lara-unb/Estimulema/Tesis Doc Miguel Gutierrez/figs/Fig_c5/c5_f1_ect.docx

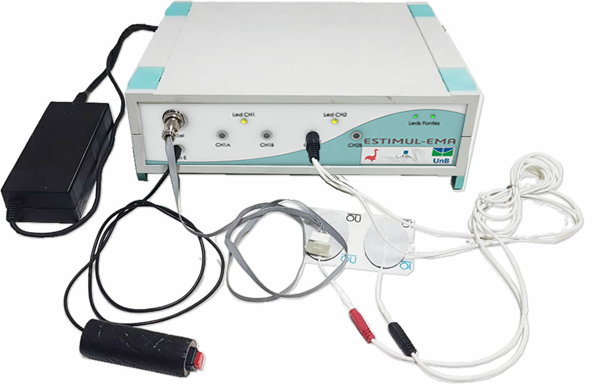
[picture p2: figure]

Acelerômetro

Eletrodo autoadesivo siliconado

Fonte

médica

Cabo do eletrodo

Botão de emergência
