lara-unb/Estimulema/Tesis Doc Miguel Gutierrez/figs/Fig_c5/c5_f4_css.docx

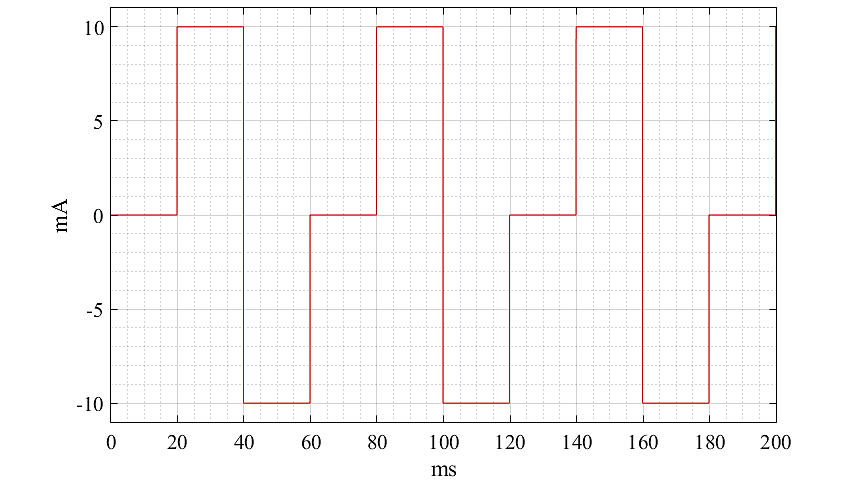
[picture p3: figure]
