lara-unb/Estimulema/Tesis Doc Miguel Gutierrez/figs/Fig_ap1/ap1_f1_v11.pdf

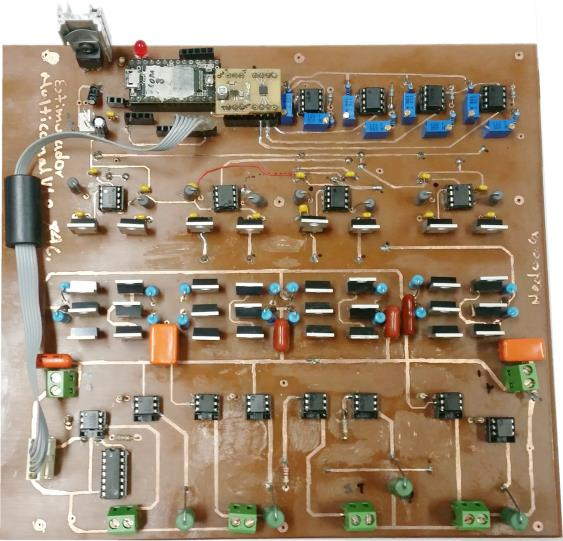
[picture p4: page 1]
