lara-unb/Estimulema/Tesis Doc Miguel Gutierrez/figs/Fig_c2/um_f3.pdf

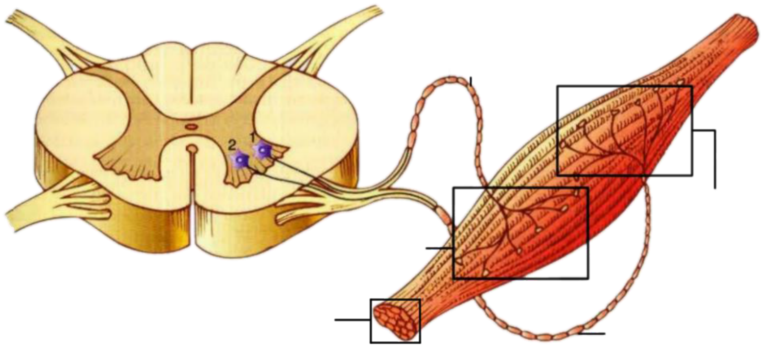
[picture p5: page 1]
