lara-unb/Estimulema/Tesis Doc Miguel Gutierrez/figs/Fig_c3/gem_f4.pdf

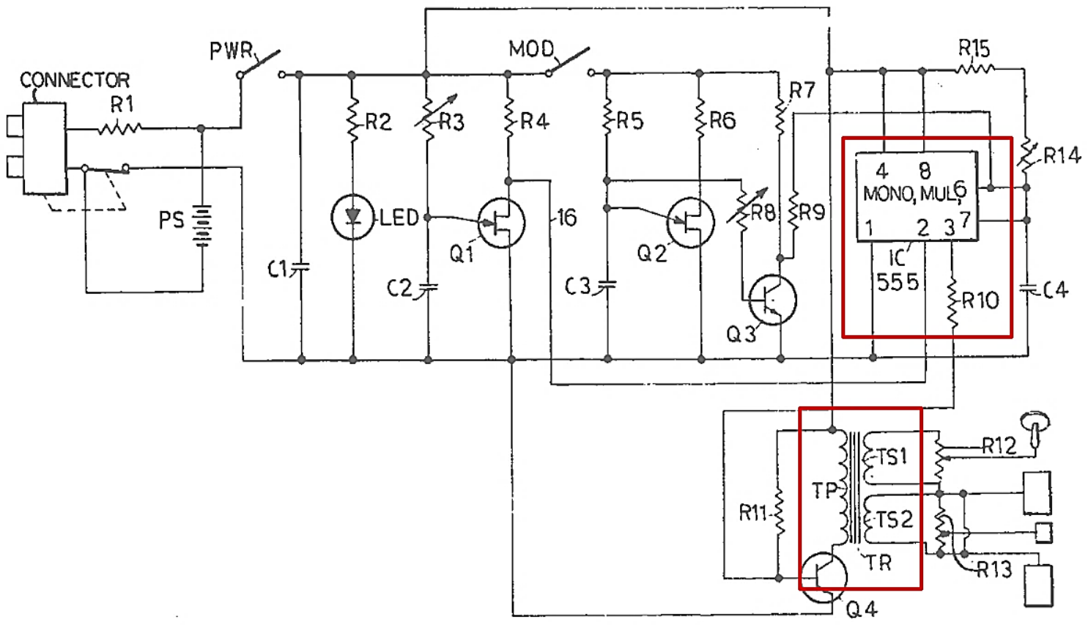
[picture p6: page 1]
