lara-unb/Estimulema/Tesis Doc Miguel Gutierrez/figs/Fig_c3/ges_f8.pdf

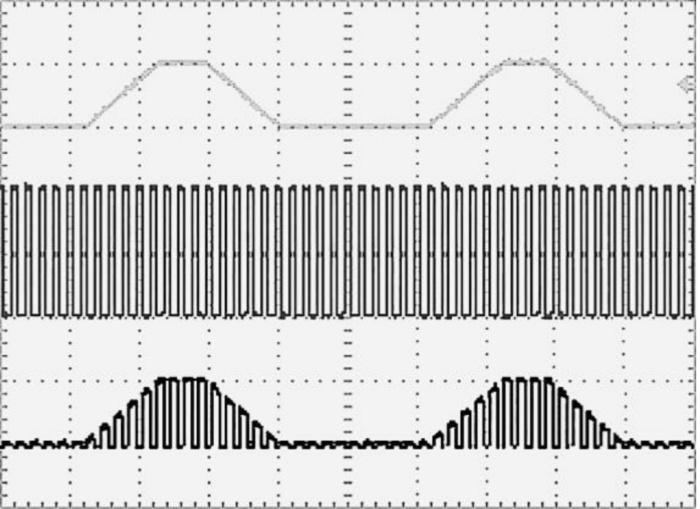
[picture p7: page 2]
