lara-unb/Estimulema/Tesis Doc Miguel Gutierrez/figs/Fig_c4/c4_f21_esb.pdf

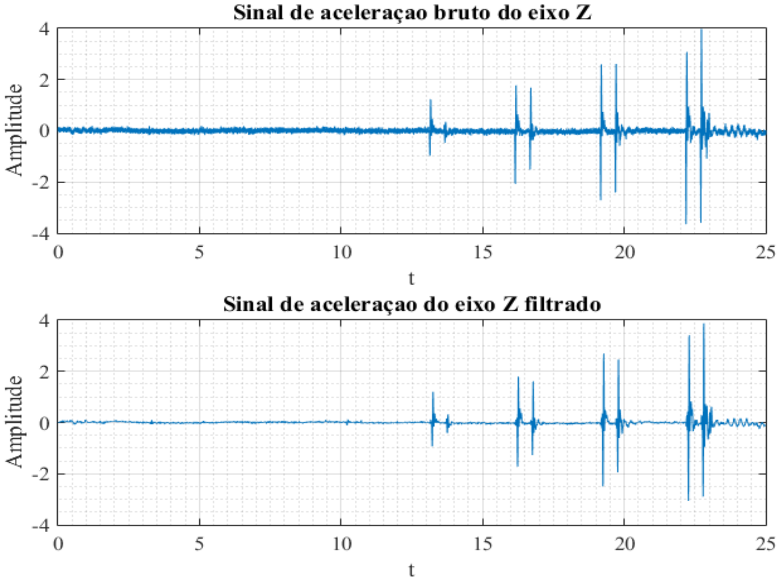
[picture p8: page 1]
