lara-unb/Estimulema/Tesis Doc Miguel Gutierrez/figs/Fig_c4/c4_f22_cca.pdf

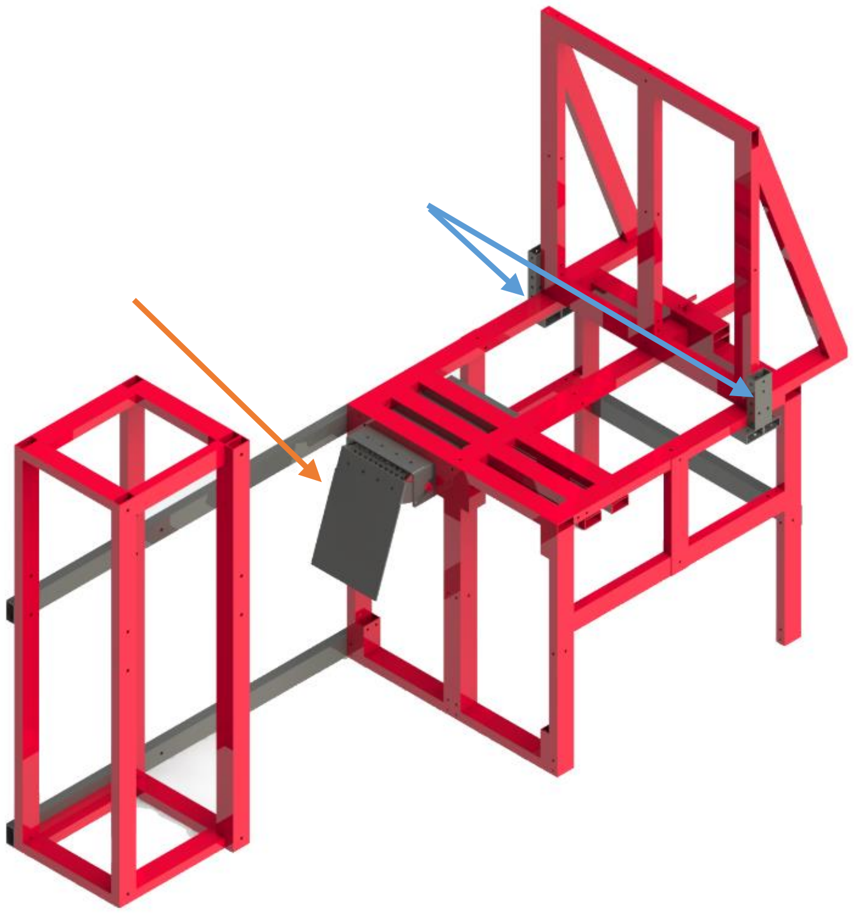
[picture p9: page 1]
