lara-unb/Estimulema/Tesis Doc Miguel Gutierrez/figs/Fig_c4/c4_f23_cdm.pdf

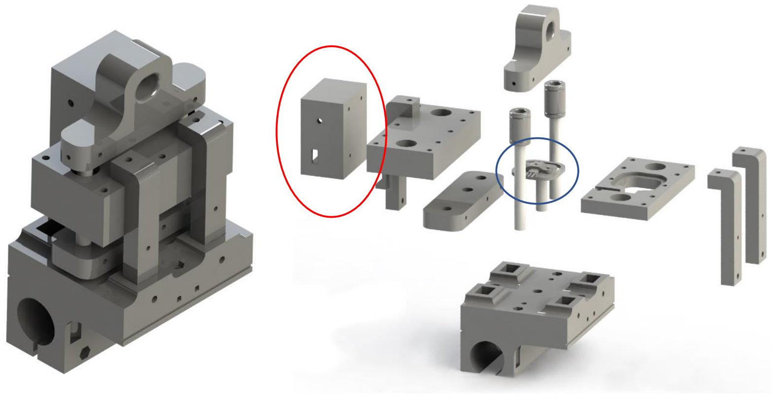
[picture p10: page 1]
