lara-unb/Estimulema/Tesis Doc Miguel Gutierrez/figs/Fig_c4/c4_f25_mpci.pdf

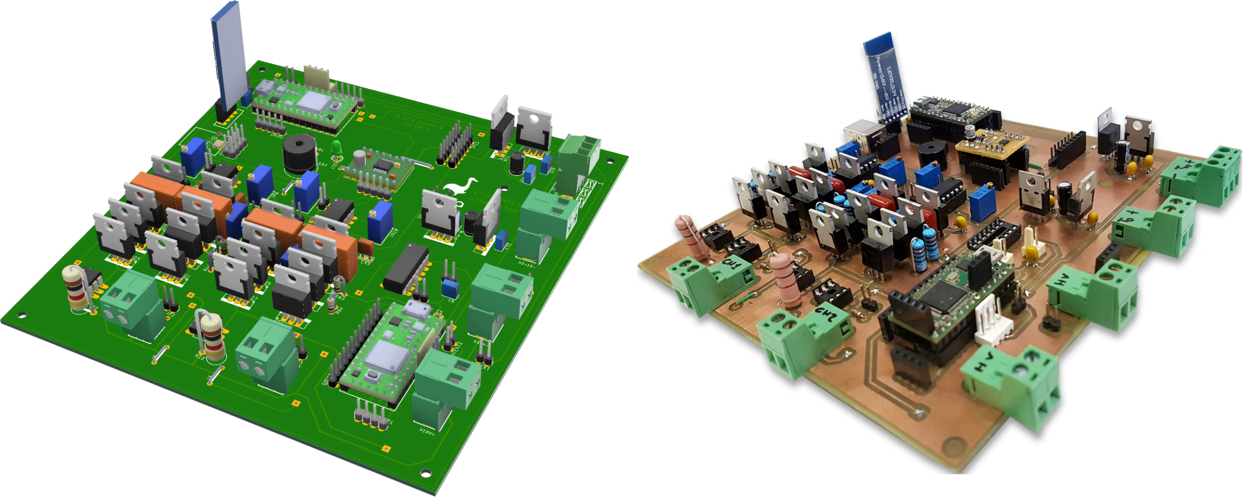
[picture p11: page 1]
