lara-unb/Estimulema/Tesis Doc Miguel Gutierrez/figs/Fig_c4/c4_f28_gfa.pdf

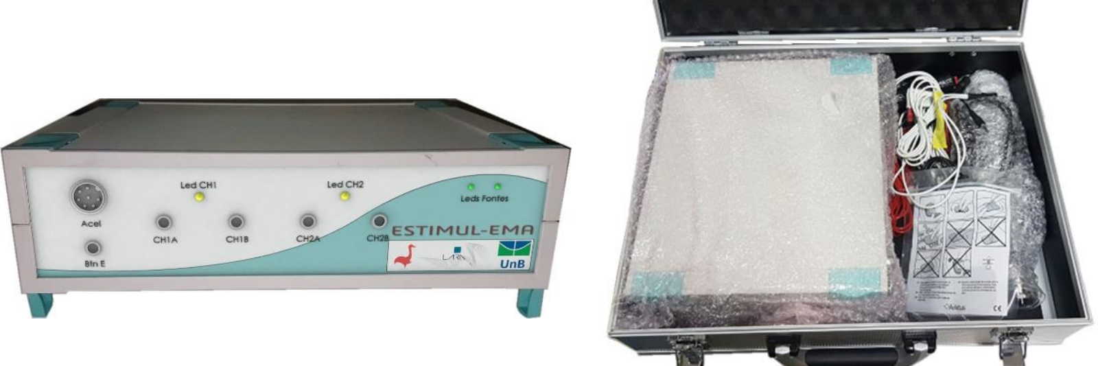
[picture p12: page 1]
