lara-unb/Estimulema/Tesis Doc Miguel Gutierrez/figs/Fig_ap1/ap1_f1_v10.pdf

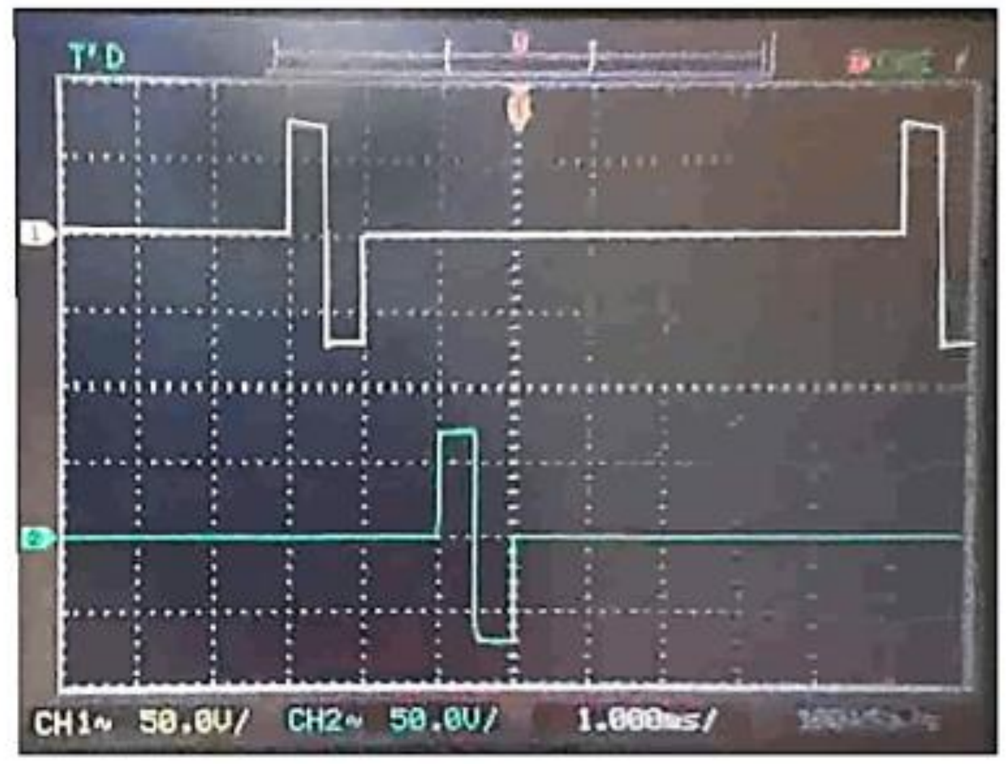
[picture p13: page 1]
