lara-unb/Estimulema/Tesis Doc Miguel Gutierrez/figs/Fig_ap1/ap1_f1_v2.pdf

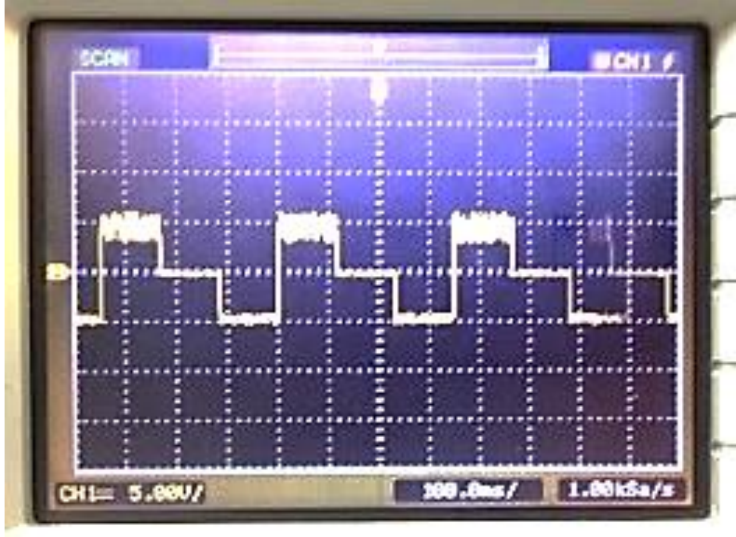
[picture p14: page 1]
