lara-unb/Estimulema/Tesis Doc Miguel Gutierrez/figs/Fig_ap1/ap1_f1_v3.pdf

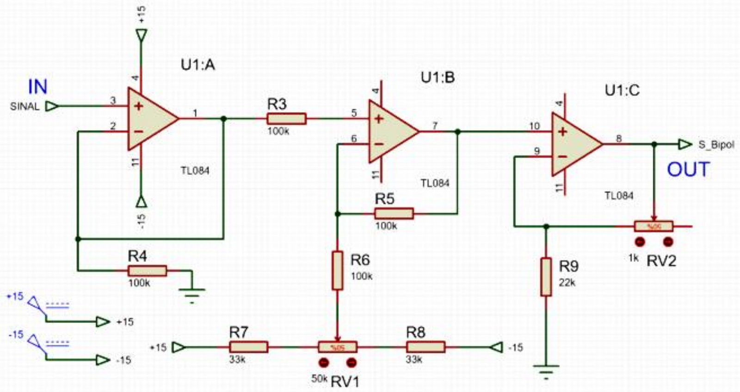
[picture p15: page 1]
