lara-unb/Estimulema/Tesis Doc Miguel Gutierrez/figs/Fig_ap1/ap1_f1_v8.pdf

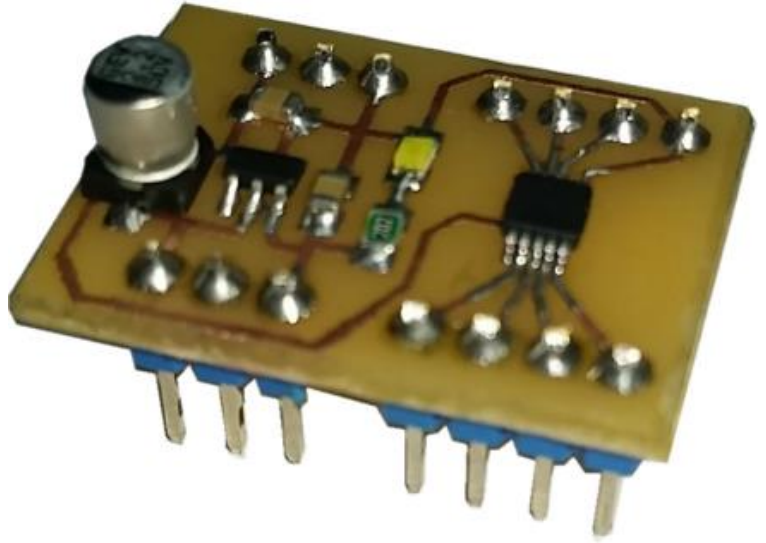
[picture p16: page 2]
