lara-unb/Estimulema/Interfaces Python/Estimulema Diag and Train/03042019/Figure_1.png

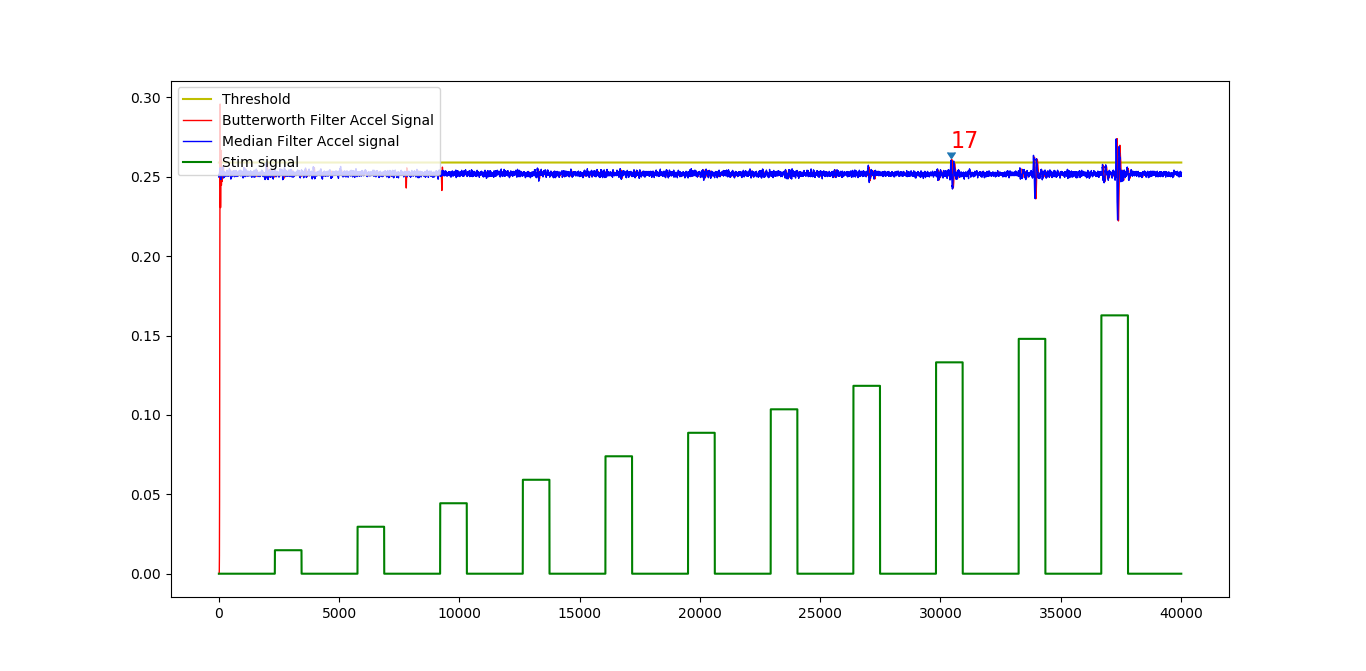
Interfaces Python/Estimulema Diag and Train/03042019/Figure_1.png
