lara-unb/Estimulema/Interfaces Python/Estimulema Diag and Train/03042019/Figure_3.png

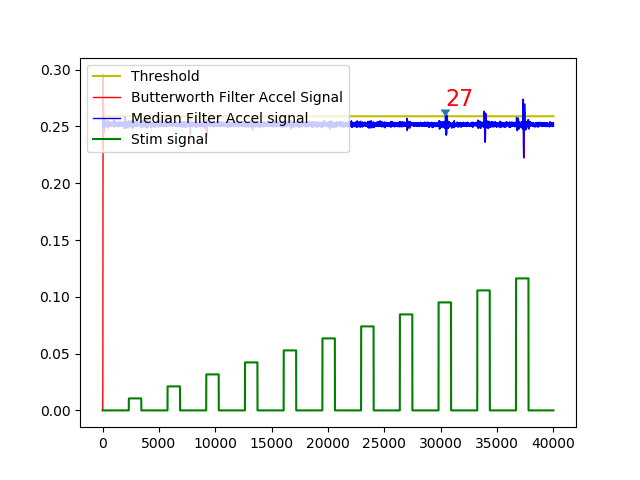
Interfaces Python/Estimulema Diag and Train/03042019/Figure_3.png
