lara-unb/Estimulema/Modelos 3d/Eagle Library/HX711 texture.jpg

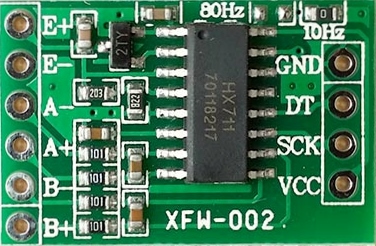
Modelos 3d/Eagle Library/HX711 texture.jpg
