lara-unb/Estimulema/Tesis Doc Miguel Gutierrez/parts/acro_list.tex

\newacronym{UTI}{UTI}{Unidade de Tratamento Intensivo}
\newacronym{DC}{DC}{Doente Crítico}
\newacronym{LM}{LM}{Lesão Medular}
\newacronym{PNMDC}{PNMDC}{Polineuromiopatia da Doença Crítica}
\newacronym{ES}{ES}{\textit{Electrical Stimulation}}
\newacronym{EEF}{EEF}{Estimulação Elétrica Funcional}
\newacronym{FES}{FES}{\textit{Functional Electrical Stimulation}}
\newacronym{EENM}{EENM}{Estimulação Elétrica Neuromuscular}
\newacronym{NMES}{NMES}{\textit{Neuromuscular Electrical Stimulation}}
\newacronym{EENT}{EENT}{Estimulação Elétrica Nervosa Transcutânea}
\newacronym{TENS}{TENS}{\textit{Transcutaneous Electrical Nerve Stimulation}}
\newacronym{EDE}{EDE}{Eletrodiagnóstico de Estímulo}
\newacronym{PE}{PE}{Parâmetros de Estimulação}
\newacronym{SNC}{SNC}{Sistema Nervoso Central}
\newacronym{SNP}{SNP}{Sistema Nervoso Periférico}
\newacronym{EMG}{EMG}{Eletromiografia}
\newacronym{ECG}{ECG}{Eletrocardiografia}
\newacronym{SUS}{SUS}{Sistema Único de Saúde}
\newacronym{UC}{UC}{Unidade de Controle}
\newacronym{MDM}{MDM}{Módulo de Detecção de Movimento}
\newacronym{MIU}{MIU}{Módulo da Interface de Usuário}
\newacronym{MC}{MC}{Módulo de Controle}
\newacronym{MGS}{MGS}{Módulo Gerador de Sinal}
\newacronym{ME}{ME}{Módulo Estimulador}
\newacronym{PLE}{PLE}{Plataforma Experimental}
\newacronym{T}{T}{Transformador}
\newacronym{CTC}{CTC}{Conversor Tensão-Corrente}
\newacronym{EC}{EC}{Espelho de Corrente}
\newacronym{PW}{PW}{\textit{Pulse Width}}
\newacronym{PWM}{PWM}{\textit{Pulse Width Modulation}}
\newacronym{F}{f}{Frequência}
\newacronym{I}{I}{Intensidade}
\newacronym{V}{V}{Voltagem}
\newacronym{M}{M}{Monofásica}
\newacronym{B}{B}{Bifásica}
\newacronym{PWon}{PWon}{Largura de Pulso do Tempo de Ativação}
\newacronym{PWoff}{PWoff}{Largura de Pulso do Tempo de Repouso}
\newacronym{EPS}{EPS}{Estagio de Potência de Saída}
\newacronym{EP}{EP}{Estagio de Potência }
\newacronym{ECW}{ECW}{Espelho de Corrente de Wilson}
\newacronym{RB}{RB}{Reobase}
\newacronym{CR}{CR}{Cronaxia}
\newacronym{AC}{AC}{Acomodação}
\newacronym{PCI}{PCI}{Placa de Circuito Impresso}
\newacronym{PC}{PC}{\textit{Personal Computer}}
\newacronym{ABNT}{ABNT}{Associação Brasileira de Normas Técnicas}
\newacronym{IEC}{IEC}{International Electrotechnical Commission}
\newacronym{NBR}{NBR}{Norma Brasileira}
\newacronym{LCD}{LCD}{\textit{Lyquid Crystal Display}}
%Nuevos acronimos del capitulo 3 
\newacronym{CVM}{CVM}{Contração Voluntária Máxima}
\newacronym{ICD}{ICD}{Interfaces de Controle Digitais}
\newacronym{ICA}{ICA}{Interfaces de Controle Analógicas}
\newacronym{USB}{USB}{\textit{Universal Serial Bus}}
\newacronym{I2C}{I2C}{\textit{Inter Integrated Circuits}}
\newacronym{UART}{UART}{\textit{Universal Asynchronous Receiver-Transmitter}}
\newacronym{SPI}{SPI}{\textit{Serial Peripheral Interface}}
\newacronym{DSP}{DSP}{\textit{Digital Signal Processor}}
\newacronym{UFMG}{UFMG}{Universidade Federal de Minas Gerais}
\newacronym{IHM}{IHM}{Interface Homem Máquina}
\newacronym{$R_{CARGA}$}{$R_{CARGA}$}{Resistencia de Carga}
\newacronym{DAC}{DAC}{\textit{Digital to Analog Converter}}
\newacronym{DA}{DA}{\textit{Digital to Analog}}
\newacronym{ADC}{ADC}{\textit{Analog to Digital Converter}}
\newacronym{AOT}{AOT}{Amplificador Operacional de Transcondutância }
\newacronym{AOP}{AOP}{Amplificador Operacional}
\newacronym{CI}{CI}{Circuito Integrado}
\newacronym{CA}{CA}{Corrente Alternada}
\newacronym{CC}{CC}{Corrente Continua}
\newacronym{IDE}{IDE}{\textit{Integrated Development Environment}}
\newacronym{THM}{THM}{\textit{Through Hole Mounting}}
\newacronym{SMD}{SMD}{\textit{Surface Mount Device}}
\newacronym{MSPS}{MSPS}{\textit{Million Samples Per Second}}
\newacronym{GND}{GND}{\textit{Ground}}
\newacronym{TBJ}{TBJ}{Transistor Bipolar de Junção}
\newacronym{IMU}{IMU}{\textit{Inertial Measurement Unit}}
\newacronym{DOF}{DOF}{\textit{Degrees Of Freedom}}
\newacronym{SC}{SC}{Sinal de Controle}
\newacronym{GS}{GS}{Gerador de Sinal}
\newacronym{GF}{GF}{Gerador de Funções}
\newacronym{TCE}{TCE}{Teste Clínico Experimental}
\newacronym{JT}{JT}{Janela de Tempo}
\newacronym{FIR}{FIR}{\textit{Finite Impulse Response}}
\newacronym{MOS}{MOS}{\textit{Metal Oxide Semiconductor}}
\newacronym{LED}{LED}{\textit{Light Emitting Diode}}
\newacronym{IGC}{IGC}{Interface Gráfica de Controle}
\newacronym{MMG}{MMG}{Mecanomiografia}
\newacronym{sEMG}{sEMG}{\textit{surface Electromyography}}
\newacronym{ExN}{ExN}{Excitabilidade Neuromuscular}
