lara-unb/Estimulema/Tesis Doc Miguel Gutierrez/parts/abstract.tex

%PORTUGUESE
\resumo{Resumo}{gfhdsdjfgjd}
%ENGLISH

\resumo{Abstract}{fdfhdhfd}

\end{abstract}
