lara-unb/Estimulema/estimulemaINO/carga/componentes.fw.png

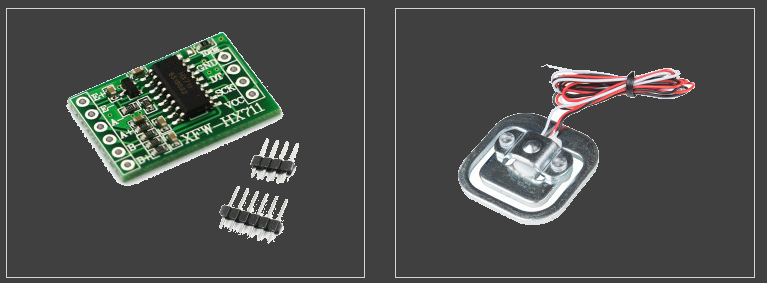
estimulemaINO/carga/componentes.fw.png
