lara-unb/Estimulema/Modelos 3d/caja cto load cell/Assem1.SLDASM

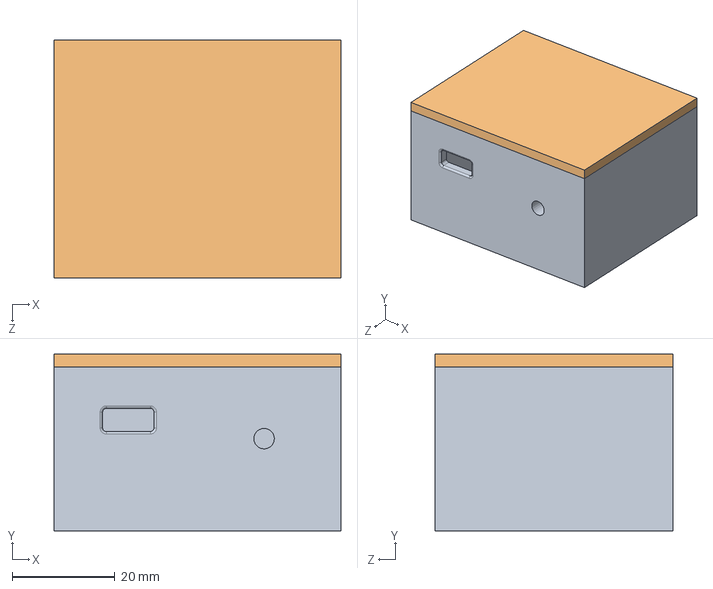
[picture p29: CAD file, 2018-08-30]
Modelos 3d/caja cto load cell/Assem1.SLDASM
56.0 x 34.5 x 46.5 mm
caja
tapa
