lara-unb/Estimulema/Modelos 3d/Isolation Box for Sitching Souurce/box.SLDASM

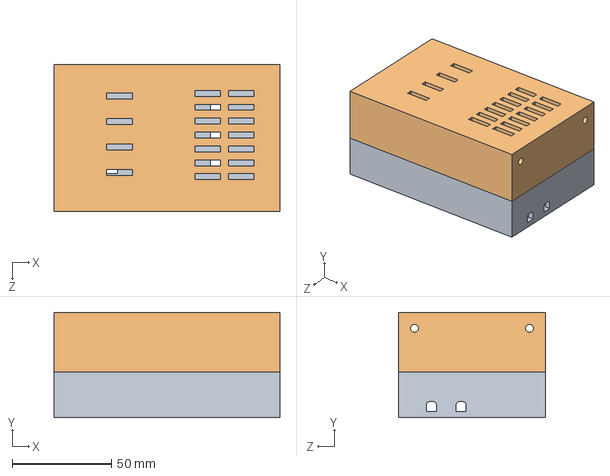
[picture p30: CAD file, 2018-08-30]
Modelos 3d/Isolation Box for Sitching Souurce/box.SLDASM
114.0 x 53.0 x 74.0 mm
button 2
top
