lara-unb/Estimulema/Modelos 3d/Box for Perfotmance test/CAIXA CARGAS COMPLETA.SLDASM

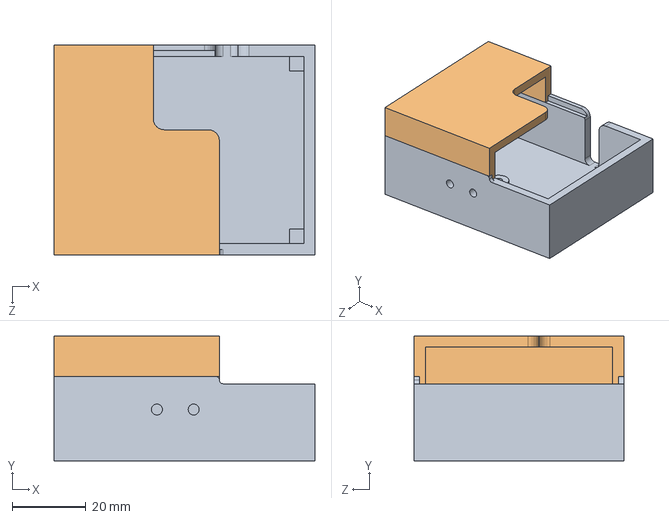
[picture p31: CAD file, 2018-08-30]
Modelos 3d/Box for Perfotmance test/CAIXA CARGAS COMPLETA.SLDASM
71.0 x 34.0 x 57.0 mm
CAIXA SISTEMA CARGAS INF
CAIXA SISTEMA CARGAS SUP
