lara-unb/Estimulema/Modelos 3d/caja acelerometro/Assem1.SLDASM

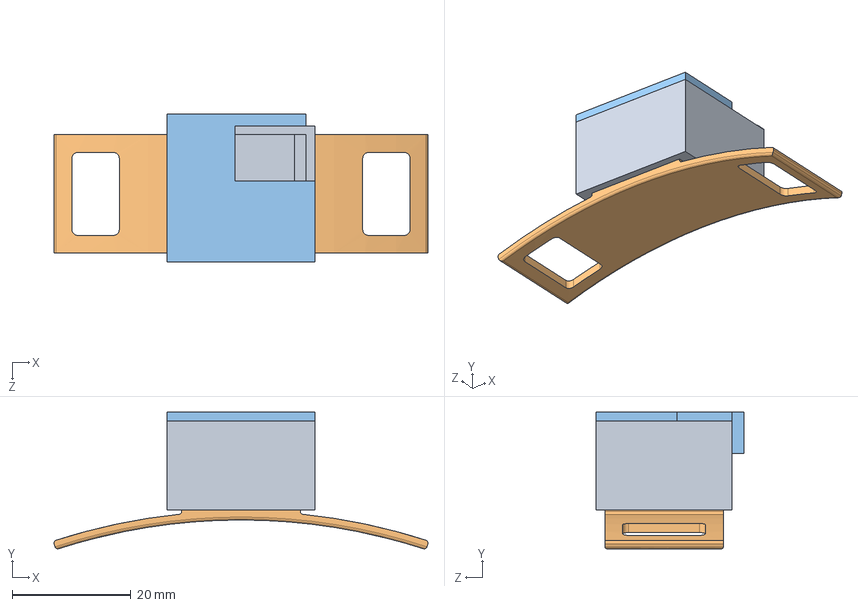
[picture p32: CAD file, 2018-08-30]
Modelos 3d/caja acelerometro/Assem1.SLDASM
63.1 x 23.1 x 25.0 mm
caja accel
base
tapa
