lara-unb/Estimulema/Modelos 3d/caja boton de emergencia/boton de segurança.SLDASM

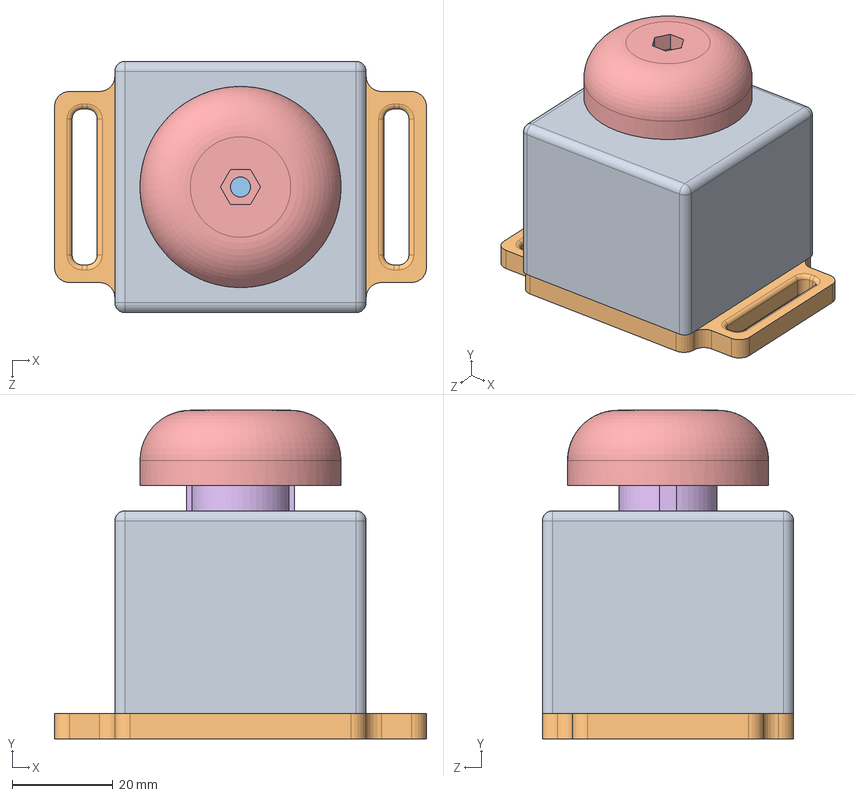
[picture p33: CAD file, 2018-08-30]
Modelos 3d/caja boton de emergencia/boton de segurança.SLDASM
74.0 x 65.3 x 50.0 mm
caja
base
botao
base boton
base boton sup
base boton 2
