lara-unb/Estimulema/Modelos 3d/Caneta/caneta completa.SLDASM

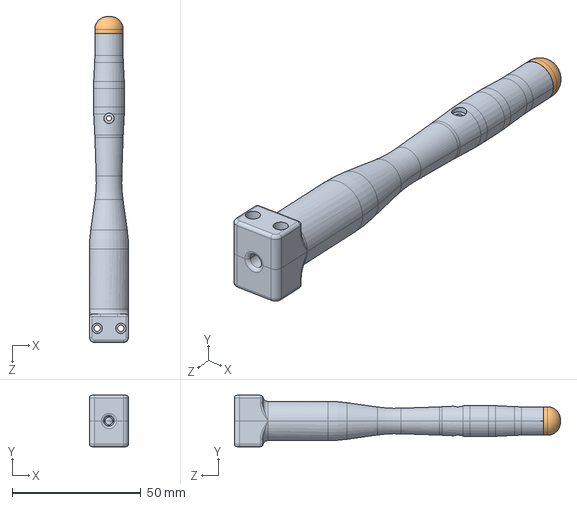
[picture p34: CAD file, 2018-08-30]
Modelos 3d/Caneta/caneta completa.SLDASM
15.2 x 20.0 x 126.5 mm
caneta test x 2
punta caneta
