lara-unb/Estimulema/Modelos 3d/Suport Device for load cell/Aparelho de mediçao de forza (Router's conflicted copy 2018-08-17).SLDASM

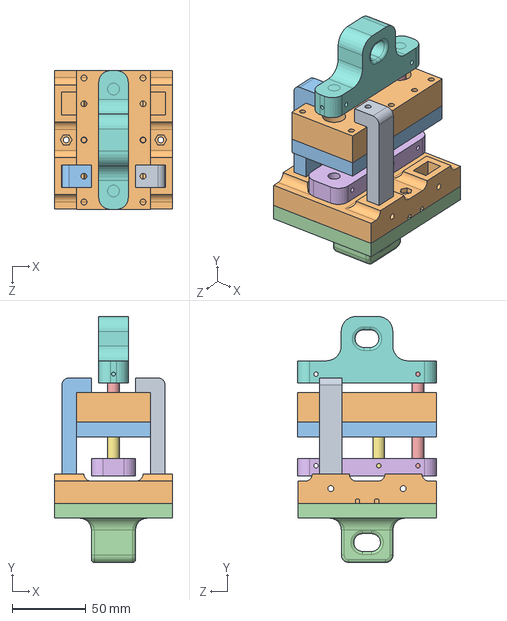
[picture p35: CAD file, 2018-08-30]
Modelos 3d/Suport Device for load cell/Aparelho de mediçao de forza (Router's conflicted copy 2018-08-17).SLDASM
80.0 x 166.5 x 94.0 mm
base trasera
agarre sup trasero
