lara-unb/Estimulema/Modelos 3d/Box for Perfotmance test/CAIXA SISTEMA CARGAS INF.SLDPRT

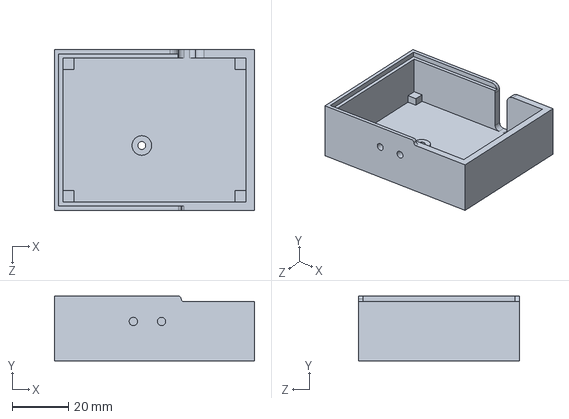
[picture p36: CAD file, 2018-08-30]
Modelos 3d/Box for Perfotmance test/CAIXA SISTEMA CARGAS INF.SLDPRT
71.0 x 23.0 x 57.0 mm
