lara-unb/Estimulema/Modelos 3d/caja acelerometro/tapa.SLDPRT

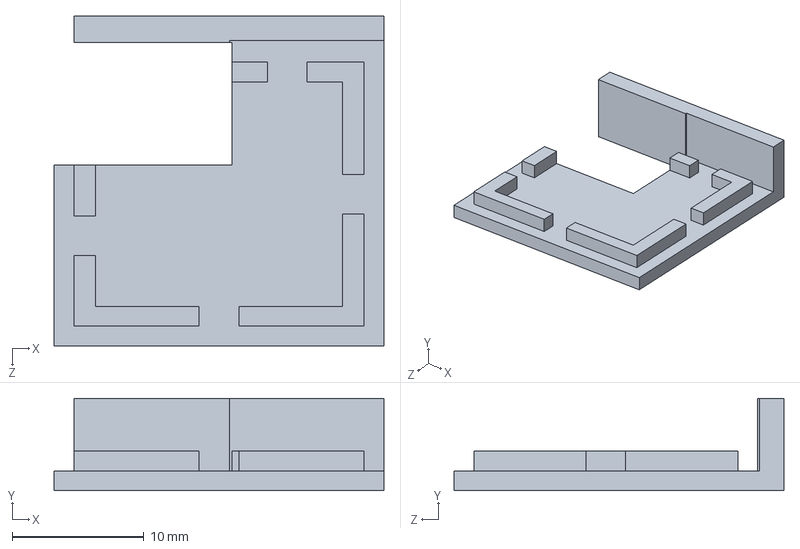
[picture p37: CAD file, 2018-08-30]
Modelos 3d/caja acelerometro/tapa.SLDPRT
25.0 x 7.00 x 25.0 mm
