lara-unb/Estimulema/Modelos 3d/caja boton de emergencia/base boton sup.SLDPRT

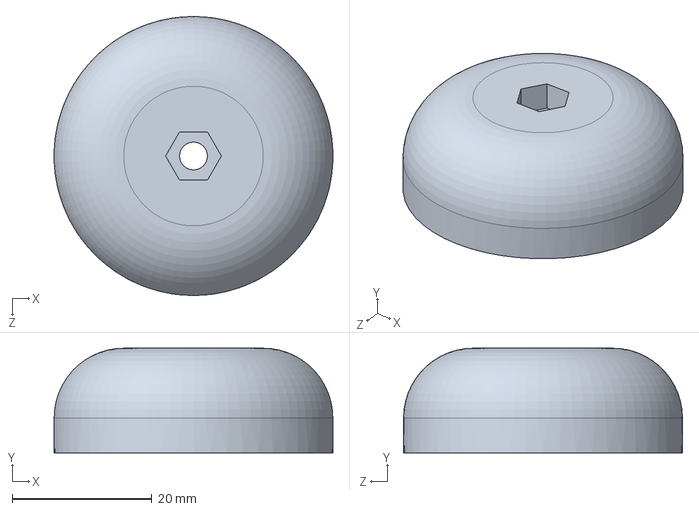
[picture p38: CAD file, 2018-08-30]
Modelos 3d/caja boton de emergencia/base boton sup.SLDPRT
40.0 x 15.0 x 40.0 mm
