lara-unb/Estimulema/Modelos 3d/caja boton de emergencia/stl boton de emergencia/base boton sup suporte.stl

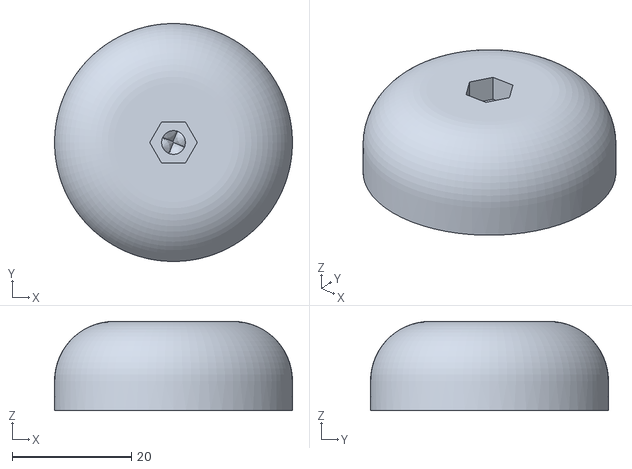
[picture p39: CAD file, 2018-08-30]
Modelos 3d/caja boton de emergencia/stl boton de emergencia/base boton sup suporte.stl
40.0 x 40.0 x 15.0
