lara-unb/Estimulema/Modelos 3d/Caneta/top.STL

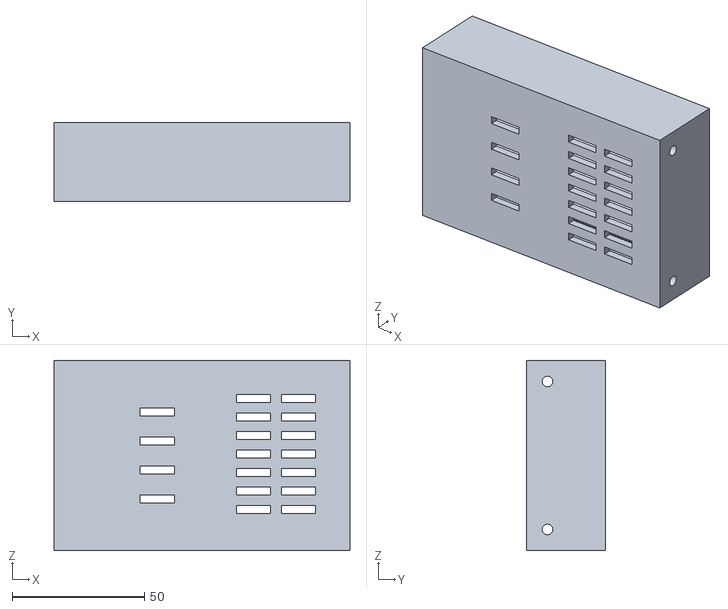
[picture p40: CAD file, 2018-08-30]
Modelos 3d/Caneta/top.STL
112.0 x 30.0 x 72.0
