lara-unb/Estimulema/Modelos 3d/Eagle Library/HX711 14.STEP

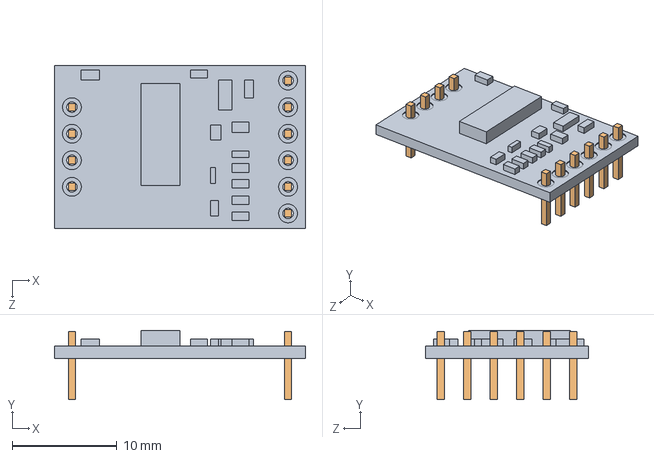
[picture p41: CAD file, 2018-08-30]
Modelos 3d/Eagle Library/HX711 14.STEP
24.0 x 6.60 x 15.6 mm
