lara-unb/Estimulema/Modelos 3d/Isolation Box for Sitching Souurce/top.SLDPRT

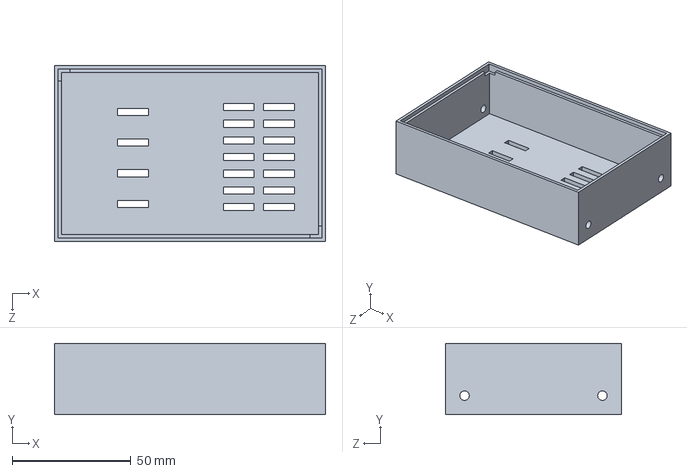
[picture p42: CAD file, 2018-08-30]
Modelos 3d/Isolation Box for Sitching Souurce/top.SLDPRT
114.0 x 30.0 x 74.0 mm
