lara-unb/Estimulema/Modelos 3d/Suport Device for load cell/agarre sup trasero - tuvo 2 pol .SLDPRT

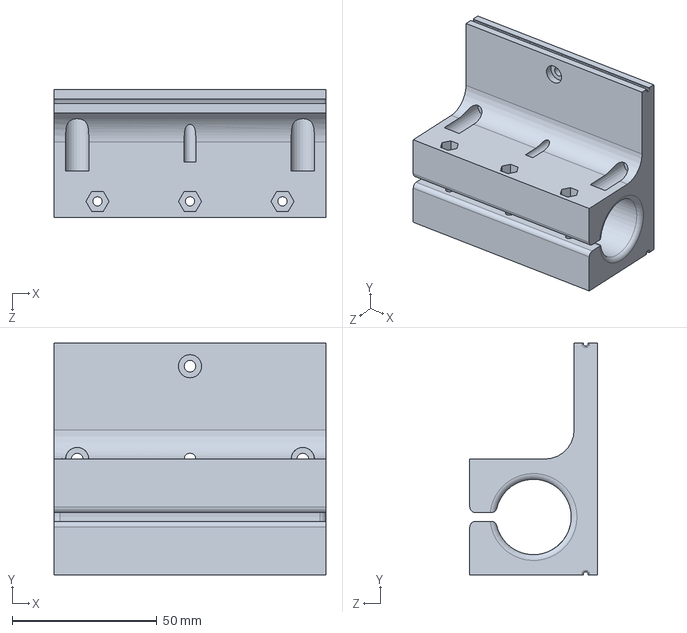
[picture p43: CAD file, 2018-09-06]
Modelos 3d/Suport Device for load cell/agarre sup trasero - tuvo 2 pol .SLDPRT
93.8 x 80.0 x 44.0 mm
