lara-unb/Estimulema/Modelos 3d/Box for Perfotmance test/CAIXA SISTEMA CARGAS SUP.SLDPRT

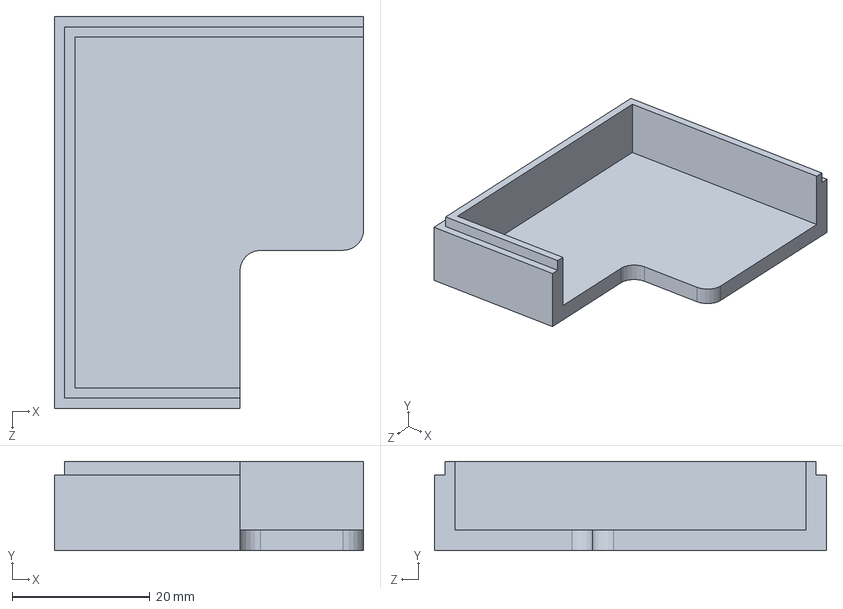
[picture p44: CAD file, 2018-08-30]
Modelos 3d/Box for Perfotmance test/CAIXA SISTEMA CARGAS SUP.SLDPRT
45.0 x 13.0 x 57.0 mm
