lara-unb/Estimulema/Modelos 3d/caja acelerometro/base.SLDPRT

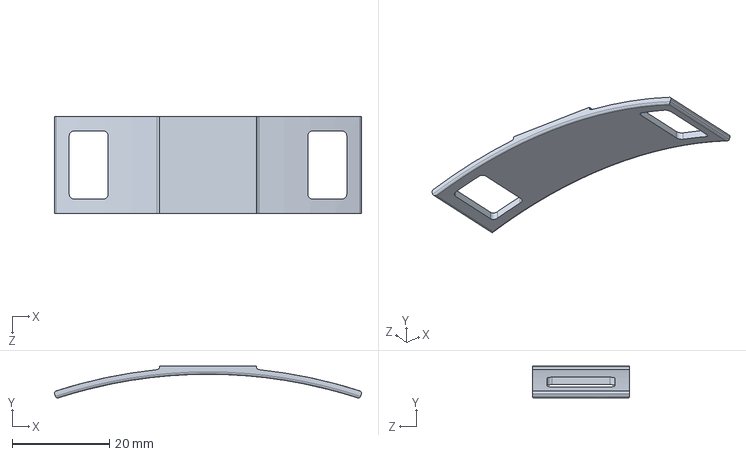
[picture p45: CAD file, 2018-08-30]
Modelos 3d/caja acelerometro/base.SLDPRT
63.1 x 6.57 x 20.0 mm
