lara-unb/Estimulema/Modelos 3d/caja boton de emergencia/botao.SLDPRT

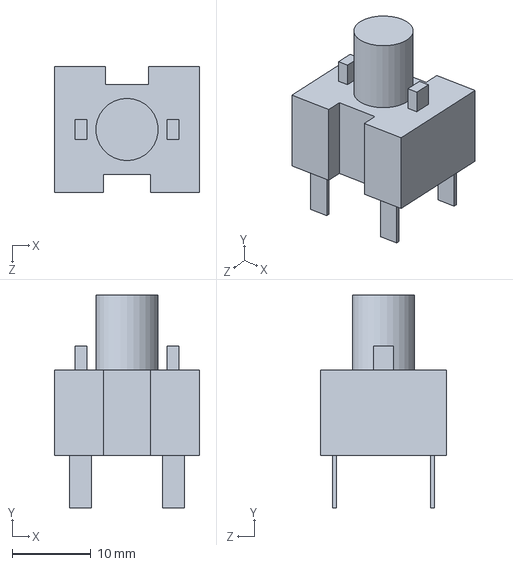
[picture p46: CAD file, 2018-08-30]
Modelos 3d/caja boton de emergencia/botao.SLDPRT
18.4 x 27.0 x 16.0 mm
