lara-unb/Estimulema/Modelos 3d/caja boton de emergencia/stl boton de emergencia/base boton 2.STL

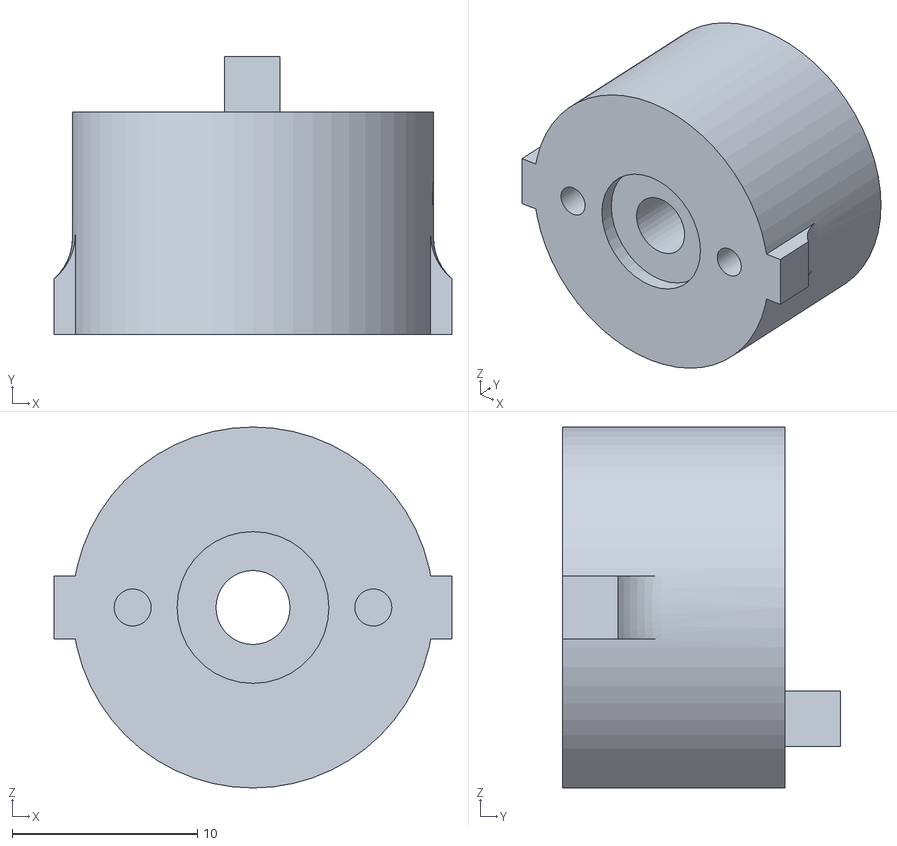
[picture p47: CAD file, 2018-08-30]
Modelos 3d/caja boton de emergencia/stl boton de emergencia/base boton 2.STL
21.5 x 15.0 x 19.5
