lara-unb/Estimulema/Modelos 3d/caja cto load cell/tapa.SLDPRT

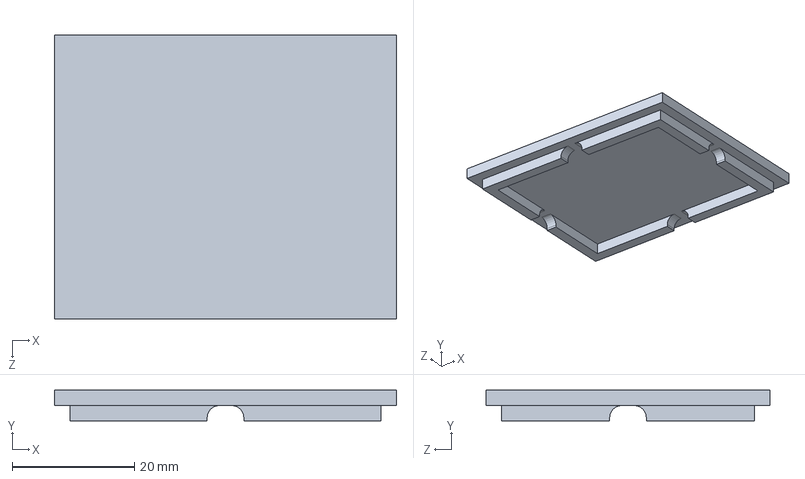
[picture p48: CAD file, 2018-08-30]
Modelos 3d/caja cto load cell/tapa.SLDPRT
56.0 x 5.00 x 46.5 mm
