lara-unb/Estimulema/Modelos 3d/Caneta/punta caneta.SLDPRT

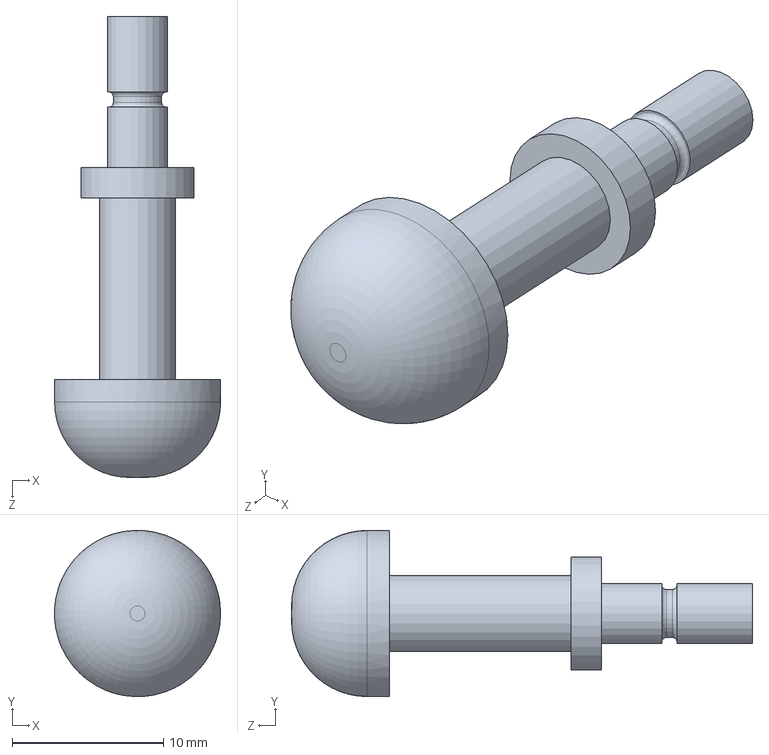
[picture p49: CAD file, 2018-08-30]
Modelos 3d/Caneta/punta caneta.SLDPRT
11.0 x 11.0 x 30.5 mm
