lara-unb/Estimulema/Modelos 3d/caja boton de emergencia/base.SLDPRT

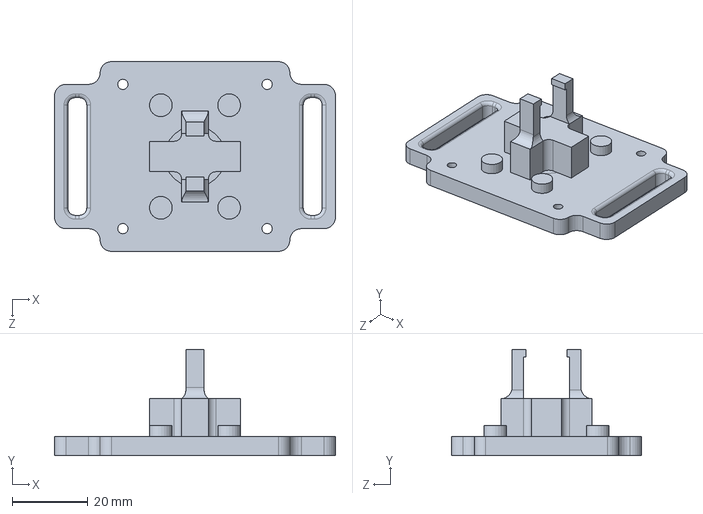
[picture p51: CAD file, 2018-08-30]
Modelos 3d/caja boton de emergencia/base.SLDPRT
74.0 x 28.0 x 50.0 mm
