lara-unb/Estimulema/Modelos 3d/caja cto load cell/caja.SLDPRT

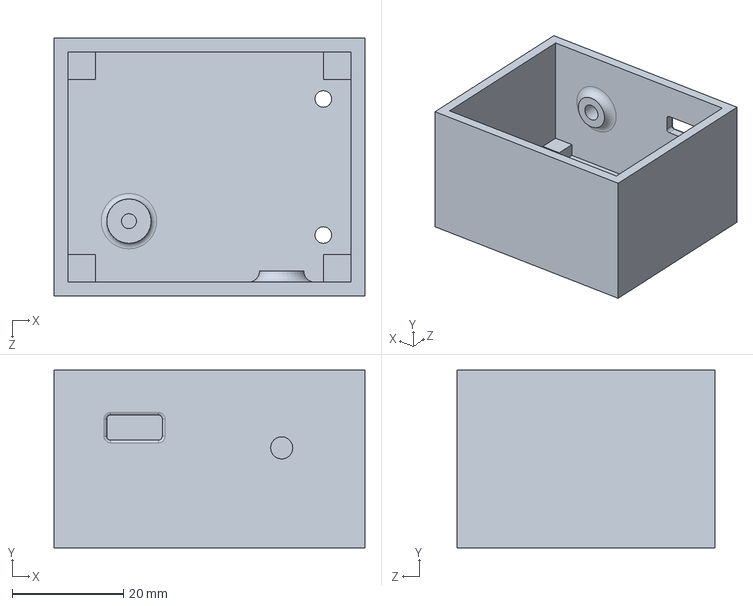
[picture p52: CAD file, 2018-08-30]
Modelos 3d/caja cto load cell/caja.SLDPRT
56.0 x 32.0 x 46.5 mm
