lara-unb/Estimulema/Modelos 3d/Caneta/caneta test.SLDPRT

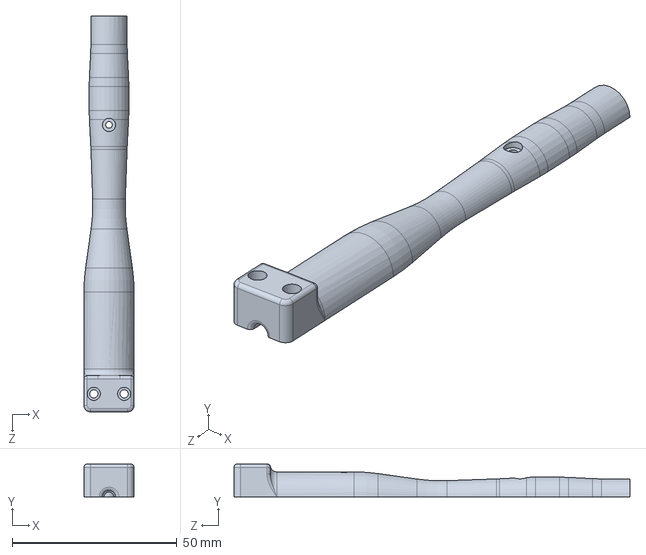
[picture p53: CAD file, 2018-08-30]
Modelos 3d/Caneta/caneta test.SLDPRT
15.2 x 10.0 x 120.0 mm
