lara-unb/Estimulema/Modelos 3d/Isolation Box for Sitching Souurce/base pasante.SLDPRT

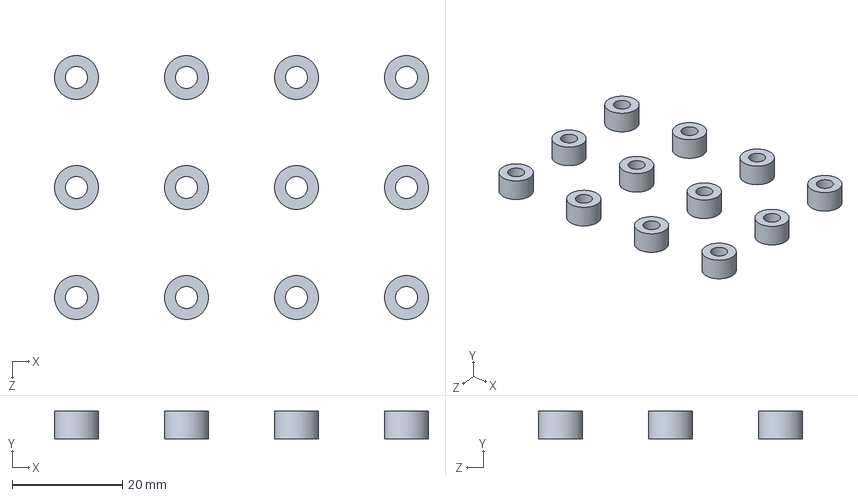
[picture p54: CAD file, 2018-08-30]
Modelos 3d/Isolation Box for Sitching Souurce/base pasante.SLDPRT
68.0 x 5.00 x 48.0 mm
