lara-unb/Estimulema/Modelos 3d/caja acelerometro/caja accel.SLDPRT

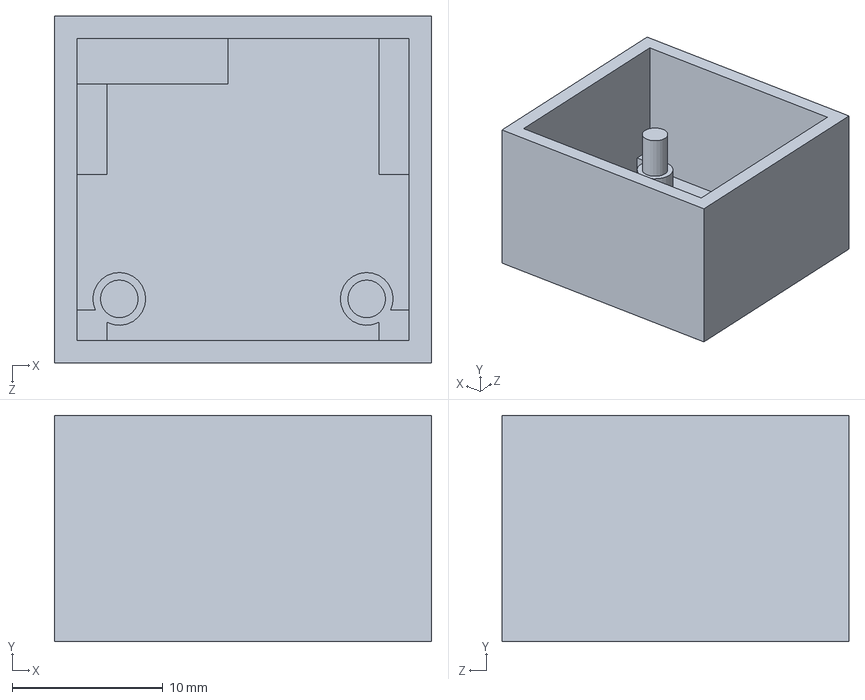
[picture p55: CAD file, 2018-08-30]
Modelos 3d/caja acelerometro/caja accel.SLDPRT
25.0 x 15.0 x 23.0 mm
