lara-unb/Estimulema/Modelos 3d/caja cto load cell/principal.SLDPRT

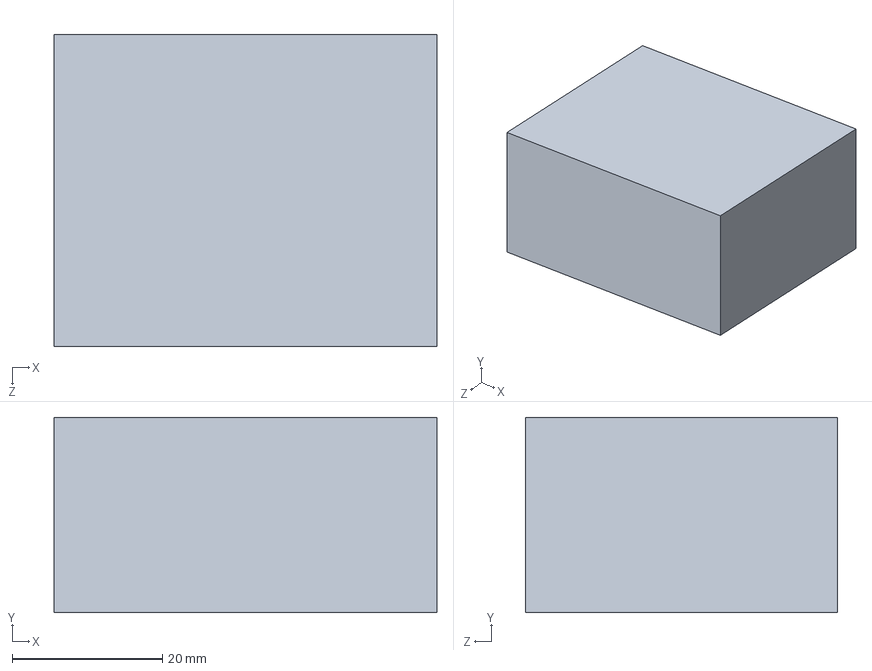
[picture p56: CAD file, 2018-08-30]
Modelos 3d/caja cto load cell/principal.SLDPRT
51.0 x 26.0 x 41.5 mm
