lara-unb/Estimulema/Modelos 3d/Caneta/button.STL

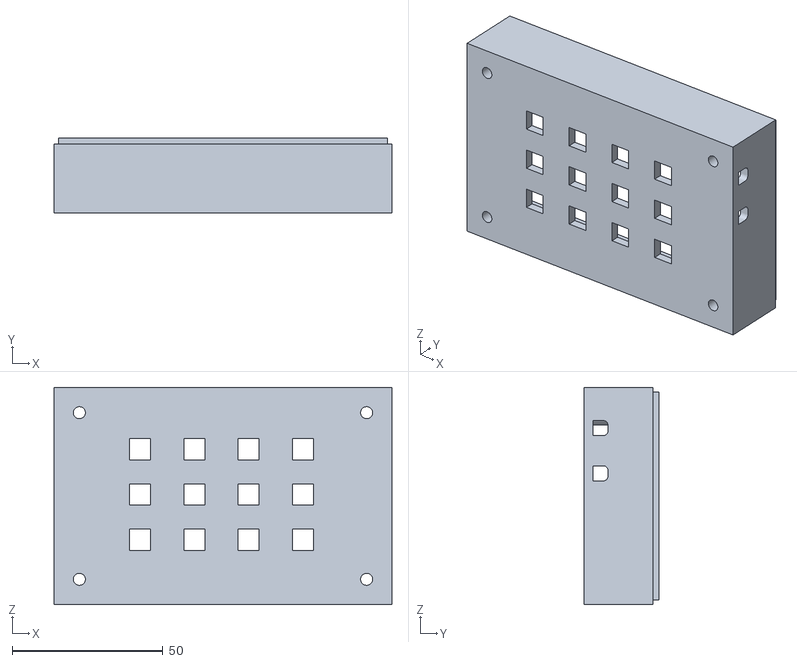
[picture p57: CAD file, 2018-08-30]
Modelos 3d/Caneta/button.STL
112.0 x 25.0 x 72.0
