lara-unb/Estimulema/Modelos 3d/Isolation Box for Sitching Souurce/pasantes.SLDPRT

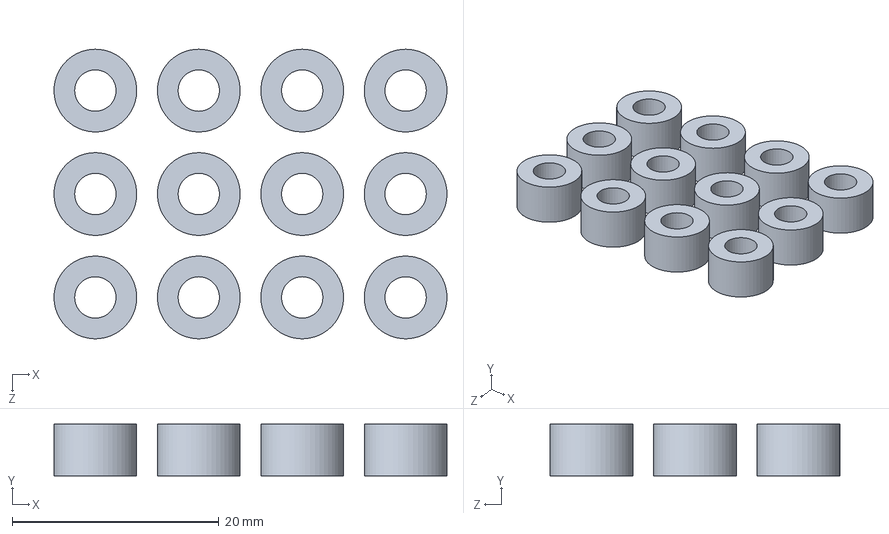
[picture p58: CAD file, 2018-08-30]
Modelos 3d/Isolation Box for Sitching Souurce/pasantes.SLDPRT
38.0 x 5.00 x 28.0 mm
