lara-unb/Estimulema/Modelos 3d/Suport Device for load cell/isolador pasante.SLDPRT

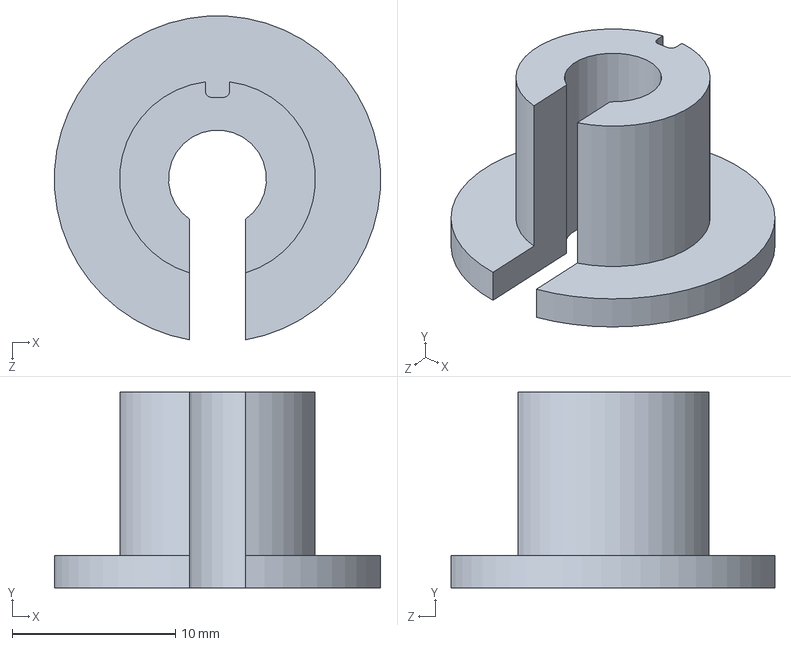
[picture p59: CAD file, 2018-09-06]
Modelos 3d/Suport Device for load cell/isolador pasante.SLDPRT
20.0 x 12.0 x 19.8 mm
