lara-unb/Estimulema/Modelos 3d/caja boton de emergencia/caja.SLDPRT

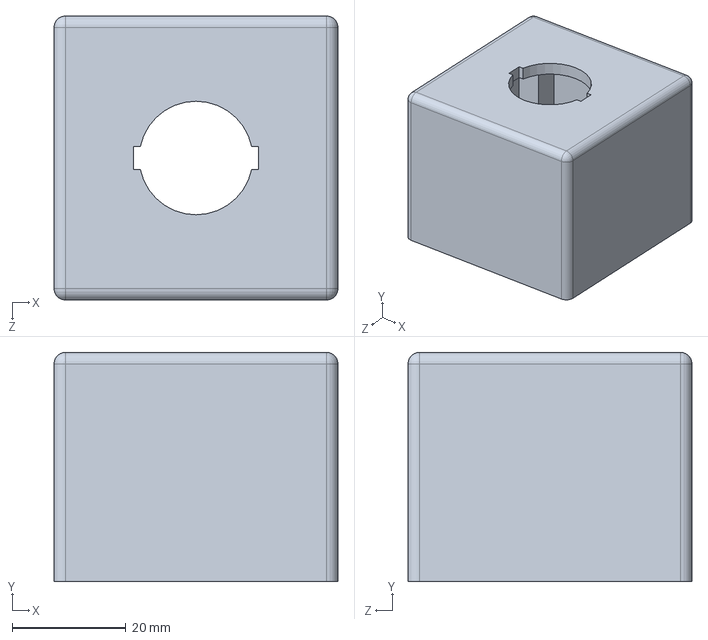
[picture p60: CAD file, 2018-08-30]
Modelos 3d/caja boton de emergencia/caja.SLDPRT
50.0 x 40.3 x 50.0 mm
