lara-unb/Estimulema/Modelos 3d/caja boton de emergencia/stl boton de emergencia/base boton.STL

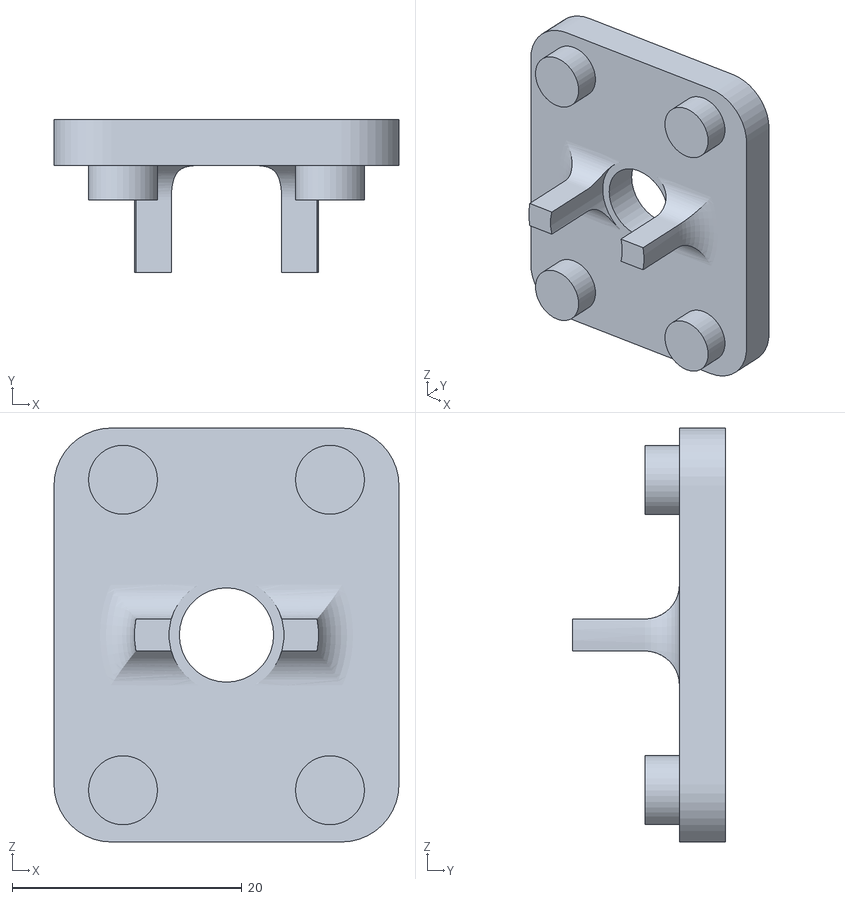
[picture p61: CAD file, 2018-08-30]
Modelos 3d/caja boton de emergencia/stl boton de emergencia/base boton.STL
30.0 x 13.3 x 36.0
