lara-unb/Estimulema/Modelos 3d/Isolation Box for Sitching Souurce/button 2.SLDPRT

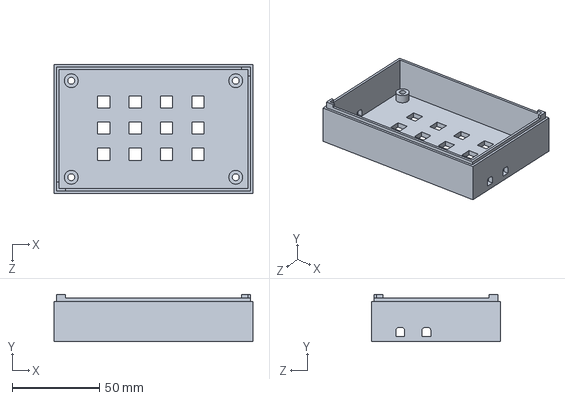
[picture p62: CAD file, 2018-08-30]
Modelos 3d/Isolation Box for Sitching Souurce/button 2.SLDPRT
114.0 x 27.0 x 74.0 mm
