lara-unb/Estimulema/Modelos 3d/Suport Device for load cell/LATERAL MOV - FRONTAL.SLDPRT

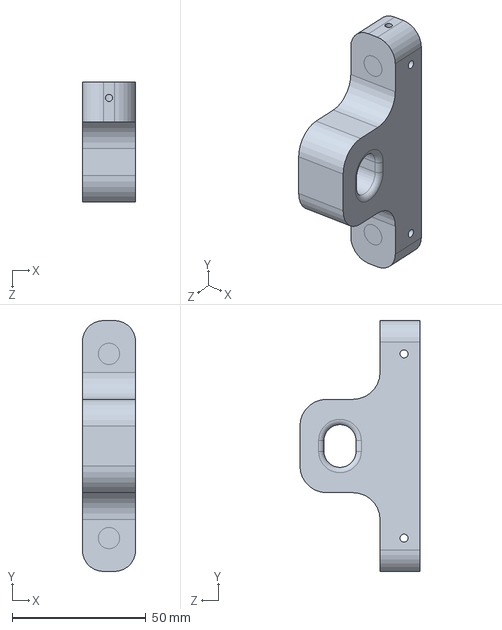
[picture p63: CAD file, 2018-08-30]
Modelos 3d/Suport Device for load cell/LATERAL MOV - FRONTAL.SLDPRT
20.0 x 94.0 x 45.0 mm
