lara-unb/Estimulema/Modelos 3d/Suport Device for load cell/GUIA.SLDPRT

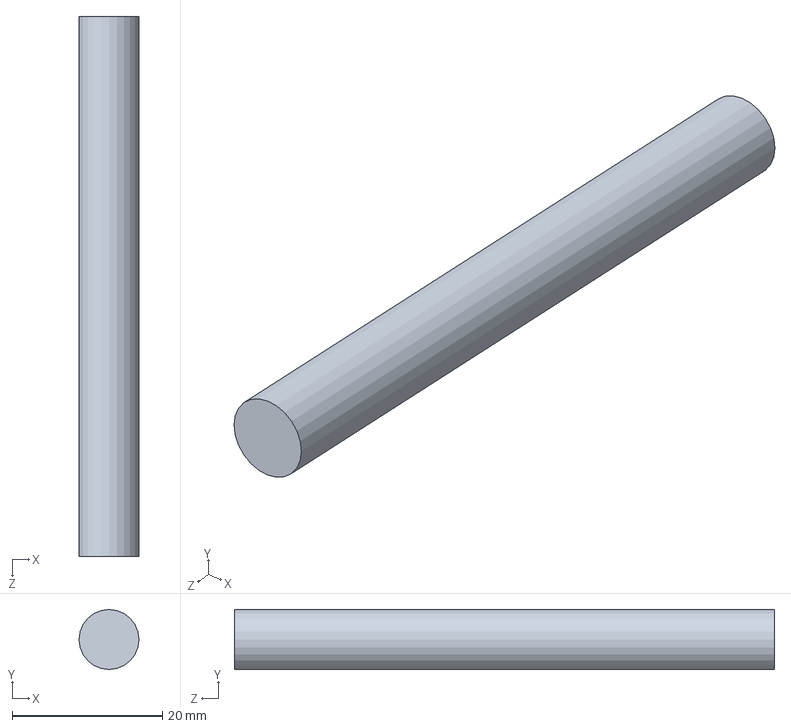
[picture p65: CAD file, 2018-08-30]
Modelos 3d/Suport Device for load cell/GUIA.SLDPRT
8.00 x 8.00 x 72.0 mm
