lara-unb/Estimulema/Modelos 3d/Suport Device for load cell/LATERAL MOV.SLDPRT

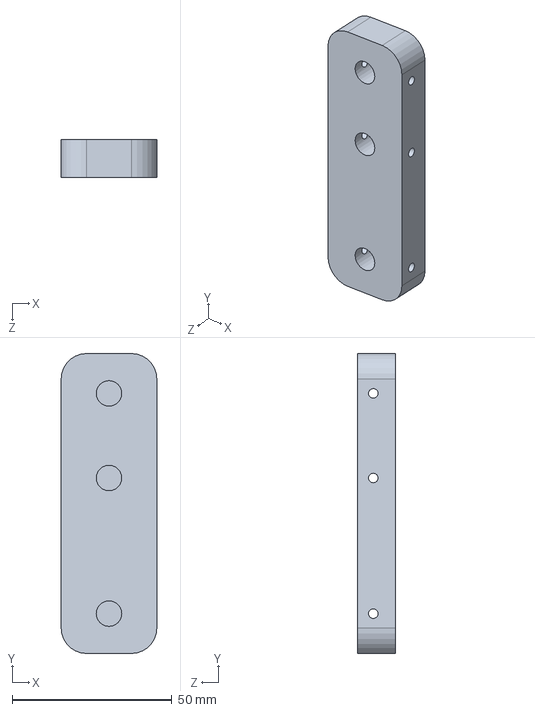
[picture p66: CAD file, 2018-08-30]
Modelos 3d/Suport Device for load cell/LATERAL MOV.SLDPRT
30.0 x 94.0 x 12.0 mm
