lara-unb/Estimulema/Modelos 3d/Suport Device for load cell/ESTOPIN.SLDPRT

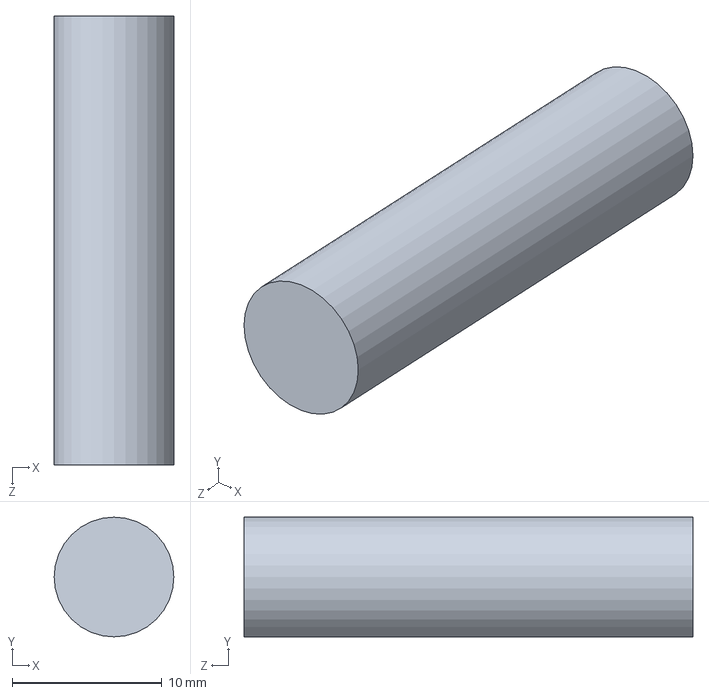
[picture p67: CAD file, 2018-08-30]
Modelos 3d/Suport Device for load cell/ESTOPIN.SLDPRT
8.00 x 8.00 x 30.0 mm
