lara-unb/Estimulema/Modelos 3d/Suport Device for load cell/suporte trasero - base cto.SLDPRT

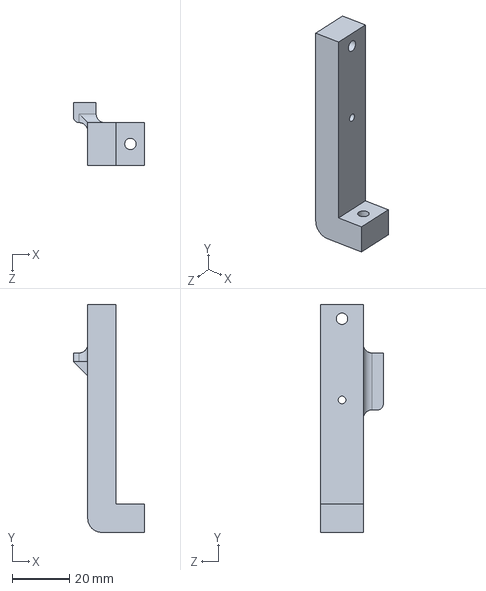
[picture p68: CAD file, 2018-08-30]
Modelos 3d/Suport Device for load cell/suporte trasero - base cto.SLDPRT
25.0 x 80.0 x 22.0 mm
