lara-unb/Estimulema/Modelos 3d/Suport Device for load cell/suporte trasero - Con hueco.SLDPRT

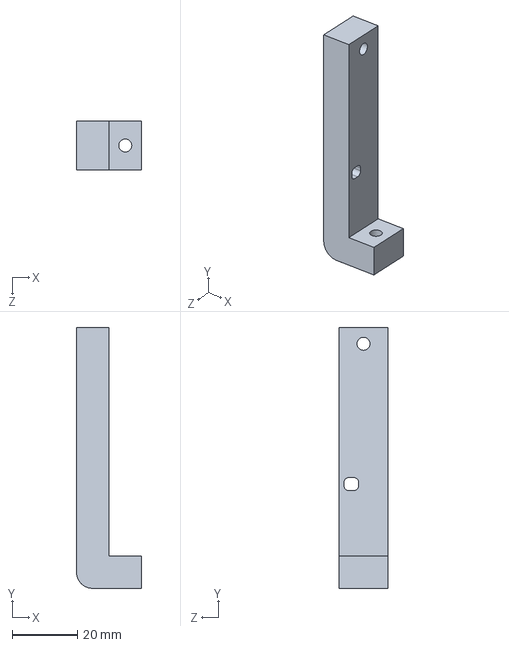
[picture p70: CAD file, 2018-08-30]
Modelos 3d/Suport Device for load cell/suporte trasero - Con hueco.SLDPRT
20.0 x 80.0 x 15.0 mm
