lara-unb/Estimulema/Modelos 3d/Suport Device for load cell/Celula de carga.SLDPRT

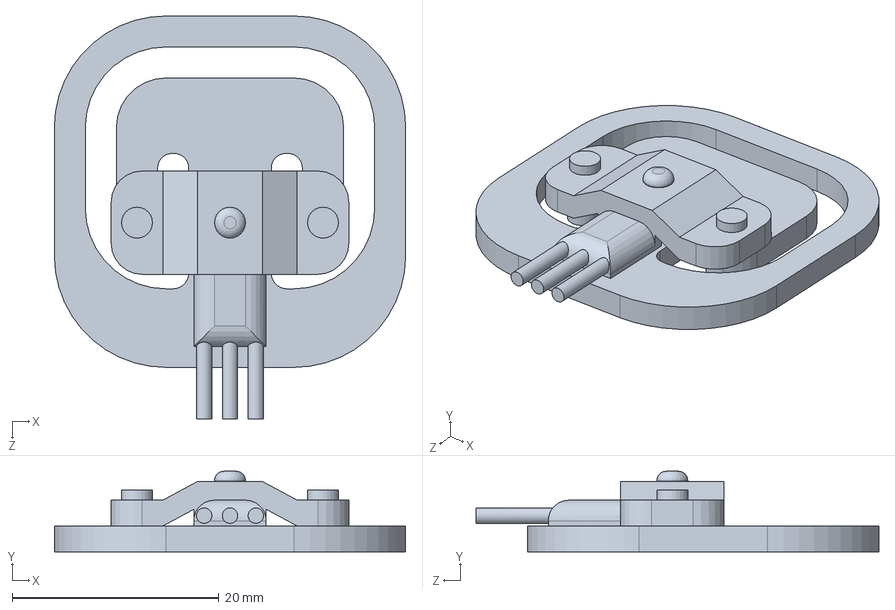
[picture p71: CAD file, 2018-08-30]
Modelos 3d/Suport Device for load cell/Celula de carga.SLDPRT
34.0 x 7.80 x 39.0 mm
