lara-unb/Estimulema/Modelos 3d/Suport Device for load cell/GUIA LATERAL.SLDPRT

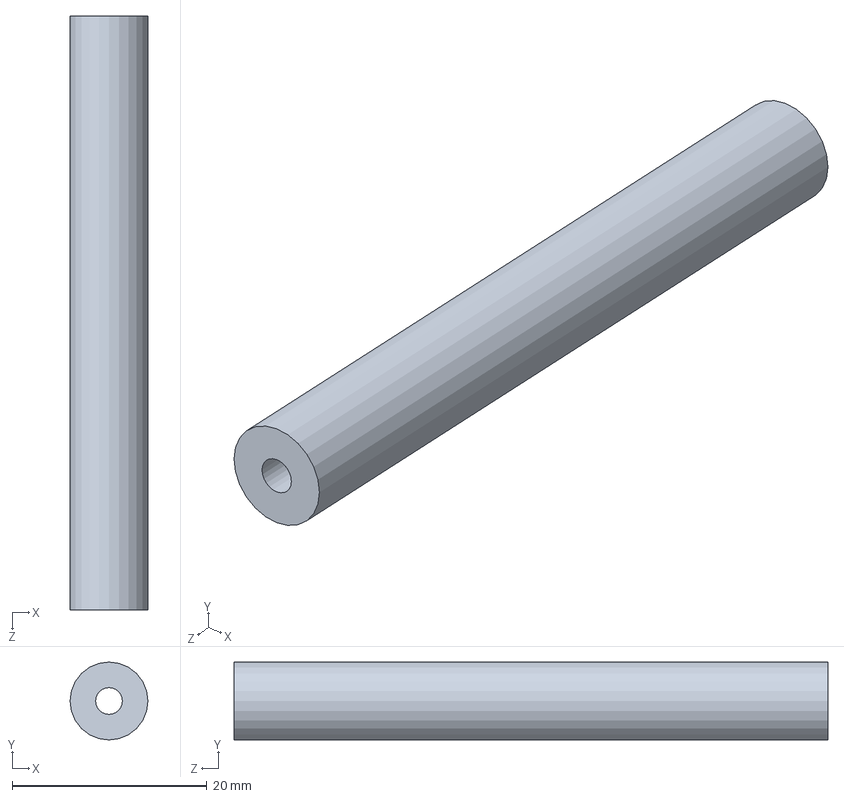
[picture p72: CAD file, 2018-08-30]
Modelos 3d/Suport Device for load cell/GUIA LATERAL.SLDPRT
8.00 x 8.00 x 61.0 mm
