lara-unb/Estimulema/Modelos 3d/Suport Device for load cell/suporte 12.SLDPRT

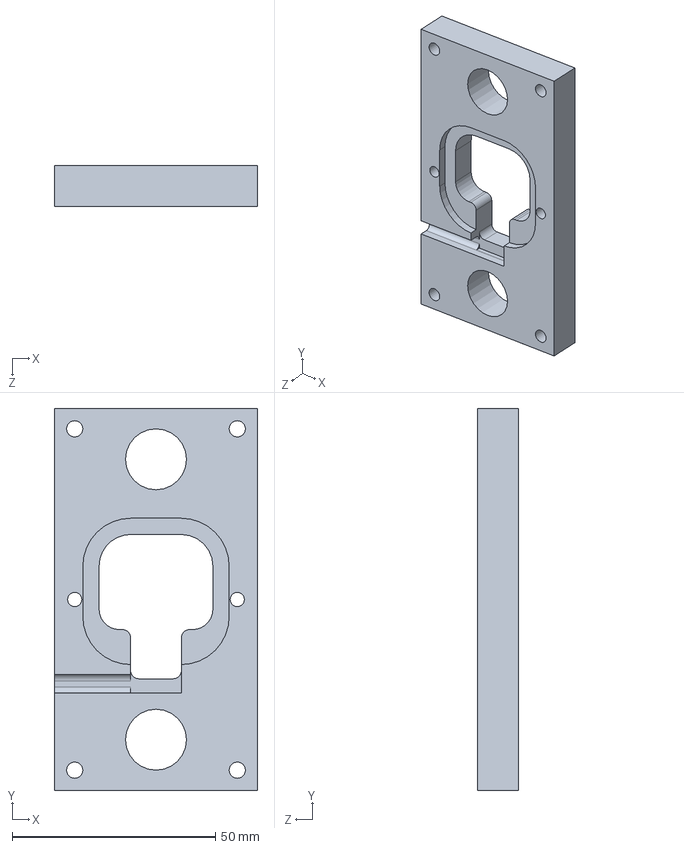
[picture p73: CAD file, 2018-08-30]
Modelos 3d/Suport Device for load cell/suporte 12.SLDPRT
50.0 x 94.0 x 10.0 mm
