lara-unb/Estimulema/Modelos 3d/Suport Device for load cell/ROLAMENTO.SLDPRT

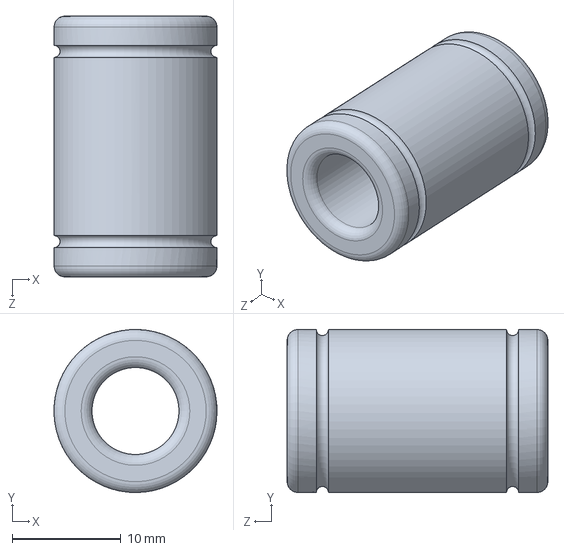
[picture p74: CAD file, 2018-08-30]
Modelos 3d/Suport Device for load cell/ROLAMENTO.SLDPRT
15.0 x 15.0 x 24.0 mm
