lara-unb/Estimulema/Modelos 3d/Suport Device for load cell/base trasera.SLDPRT

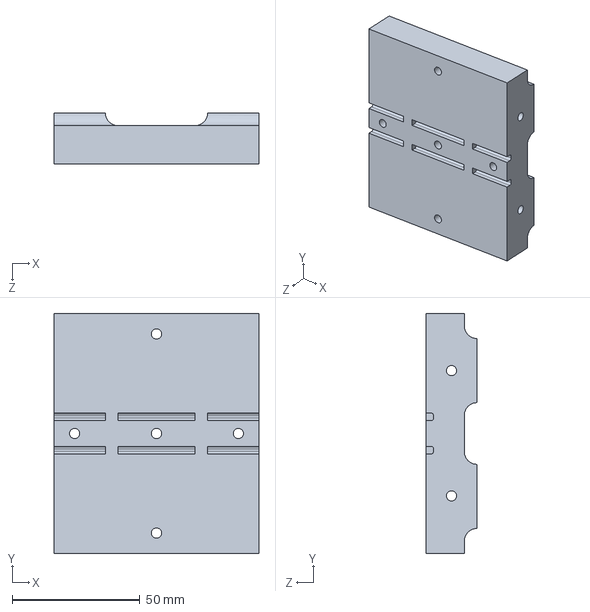
[picture p75: CAD file, 2018-08-30]
Modelos 3d/Suport Device for load cell/base trasera.SLDPRT
80.0 x 93.8 x 20.0 mm
