lara-unb/Estimulema/Modelos 3d/Suport Device for load cell/suporte 1.SLDPRT

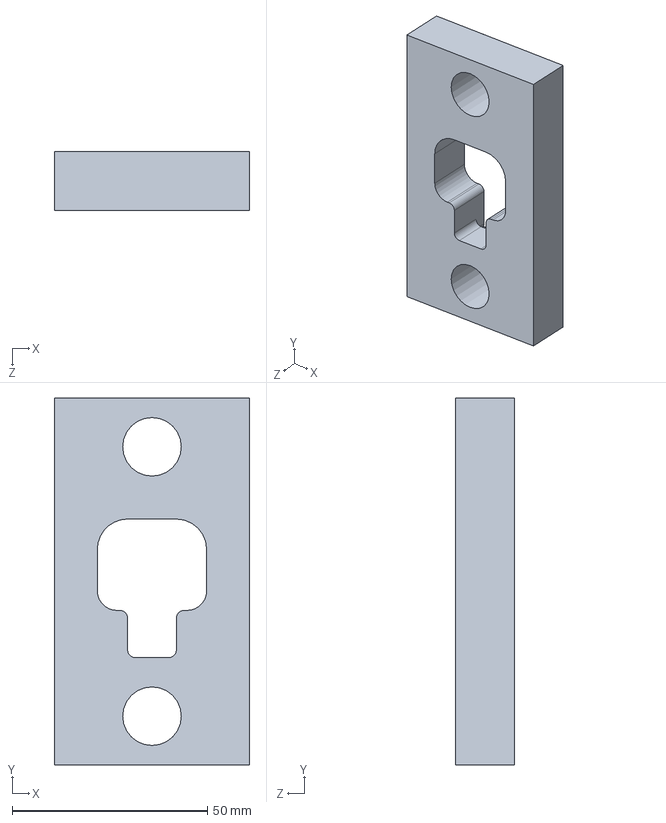
[picture p76: CAD file, 2018-08-30]
Modelos 3d/Suport Device for load cell/suporte 1.SLDPRT
50.0 x 94.0 x 15.0 mm
