lara-unb/Estimulema/Modelos 3d/Suport Device for load cell/Part1.SLDPRT

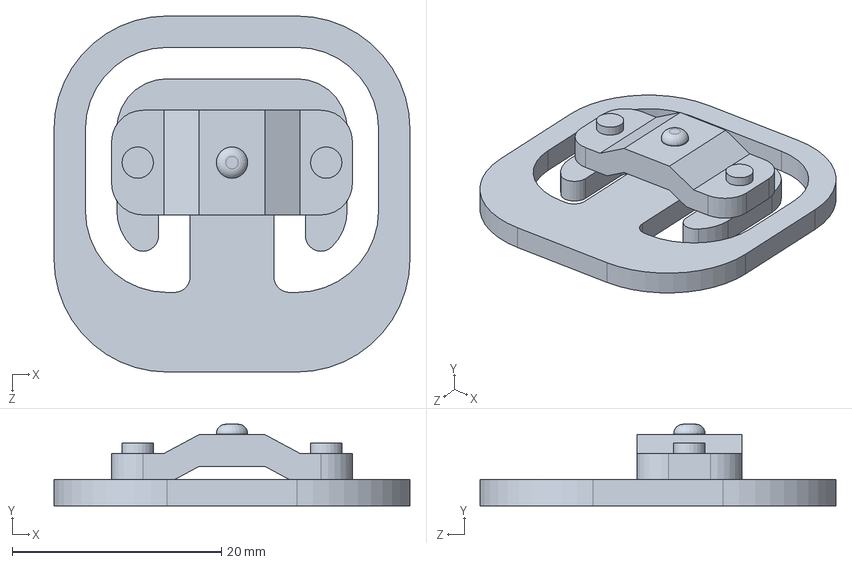
[picture p77: CAD file, 2018-08-30]
Modelos 3d/Suport Device for load cell/Part1.SLDPRT
34.0 x 7.80 x 34.0 mm
