lara-unb/Estimulema/Modelos 3d/Suport Device for load cell/agarre sup trasero.SLDPRT

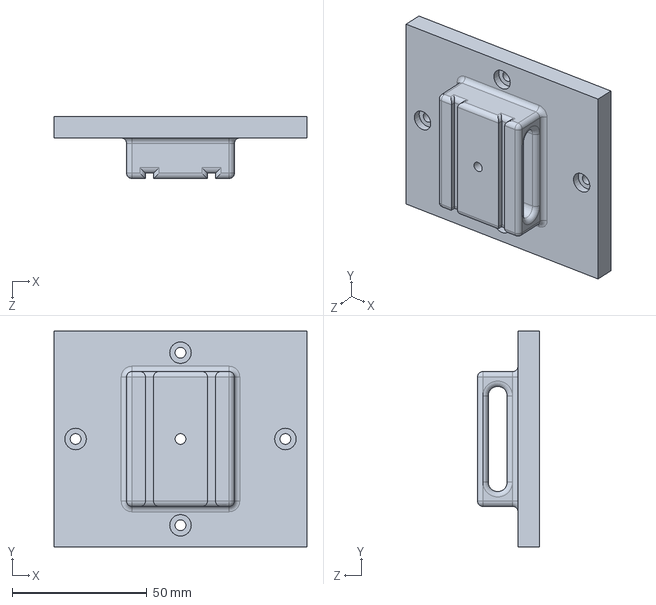
[picture p78: CAD file, 2018-08-30]
Modelos 3d/Suport Device for load cell/agarre sup trasero.SLDPRT
93.8 x 80.0 x 23.0 mm
