lara-unb/Estimulema/(list of files, cad)

Other CAD files:
Modelos 3d/Eagle Library/HX711.STEP
Modelos 3d/caja boton de emergencia/stl boton de emergencia/base boton sup.STL
Modelos 3d/caja boton de emergencia/stl boton de emergencia/base.STL
Modelos 3d/caja boton de emergencia/stl boton de emergencia/caja.STL
Modelos 3d/Isolation Box for Sitching Souurce/button.SLDPRT
Modelos 3d/caja boton de emergencia/base boton.SLDPRT
Modelos 3d/Caneta/punta caneta.SLDDRW
Modelos 3d/Eagle Library/HX711.SLDPRT
