lara-unb/Estimulema/Teste de Desempeño/Dualpex 071 performance test/Desempenho.pdf

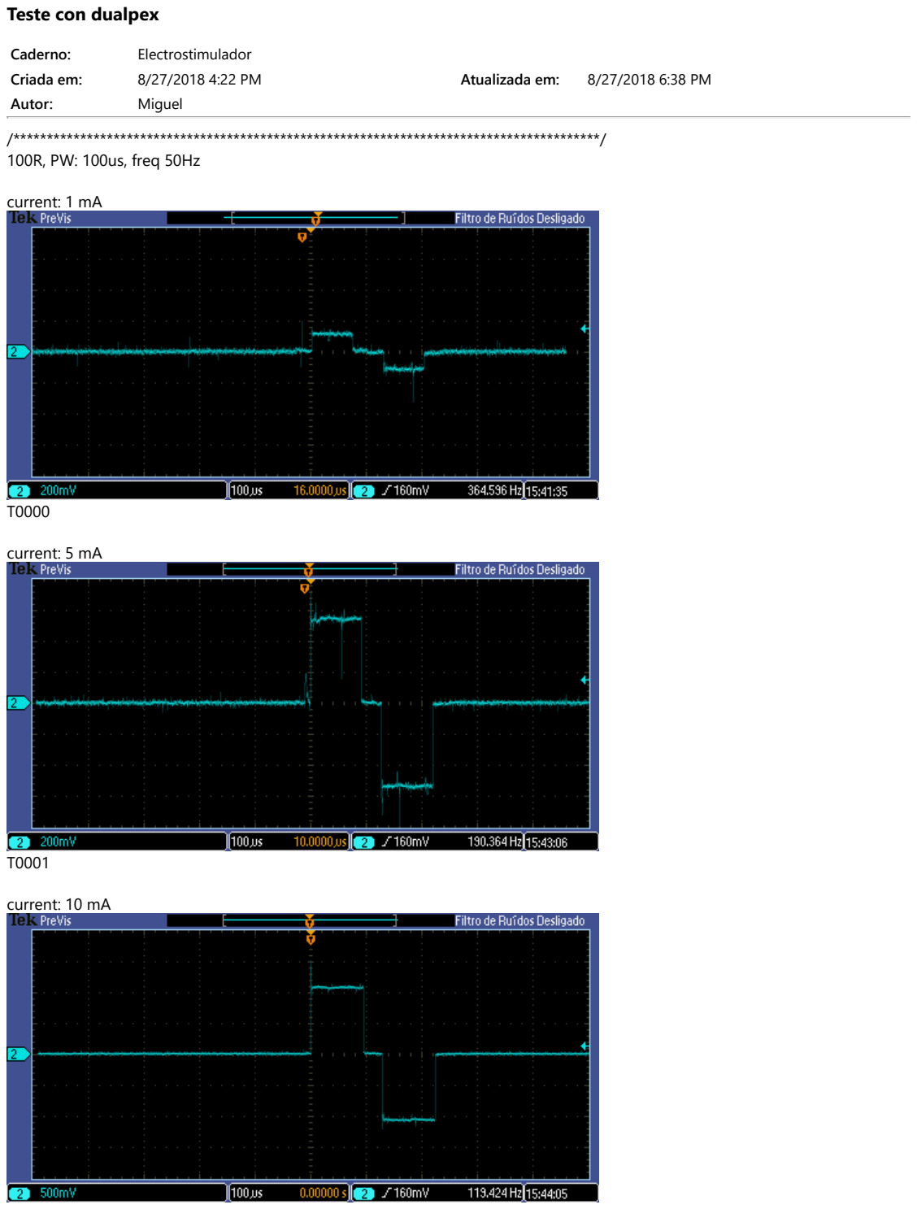
[picture p79: page 1]

Caderno: | Electrostimulador
Criada em: | 8/27/2018 4:22 PM | Atualizada em: | 8/27/2018 6:38 PM
Autor: | Miguel

Teste con dualpex

/****************************************************************************************/
100R, PW: 100us, freq 50Hz

current: 1 mA

T0000

current: 5 mA

T0001

current: 10 mA

T0002

current: 35 mA

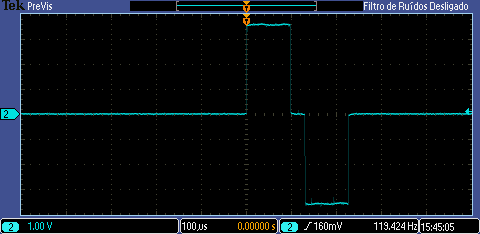
[picture p80: figure]

T0003

current: 69 mA

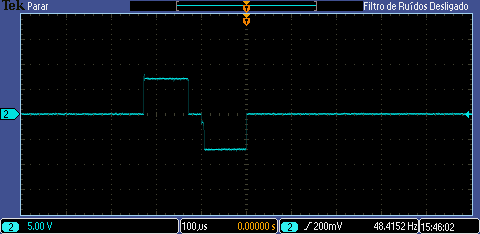
[picture p81: figure]

T0004

/****************************************************************************************/ 470R, PW: 100us, freq 50Hz

current: 1 mA

T0005

current: 5 mA

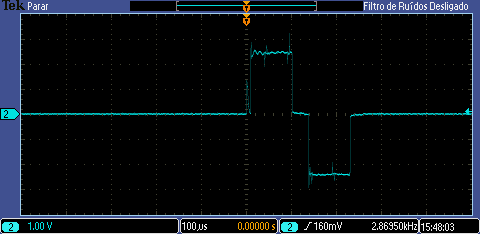
[picture p82: figure]

T0006

current: 10 mA

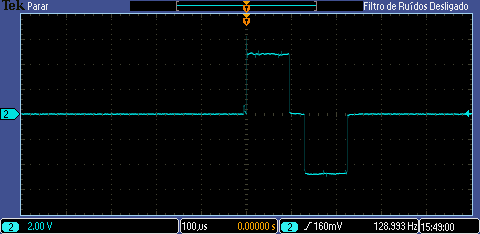
[picture p83: figure]

T0007

current: 35 mA

T0008

current: 69 mA

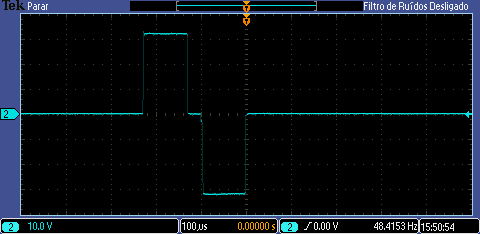
[picture p84: figure]

T0009

/****************************************************************************************/ 1000R, PW: 100us, freq 50Hz

current: 1 mA

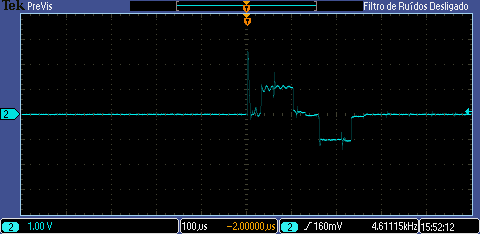
[picture p85: figure]

T0010

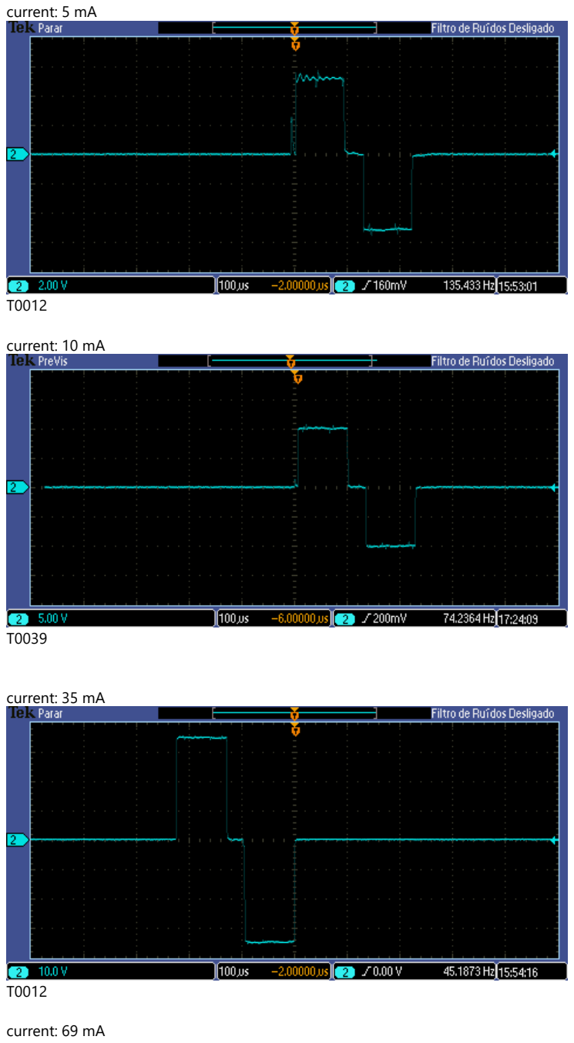
[picture p86: page 5]

current: 5 mA

T0012

current: 10 mA

T0039

current: 35 mA

T0012

current: 69 mA

T0013

/****************************************************************************************/ 1500R, PW: 100us, freq 100Hz

current: 1 mA

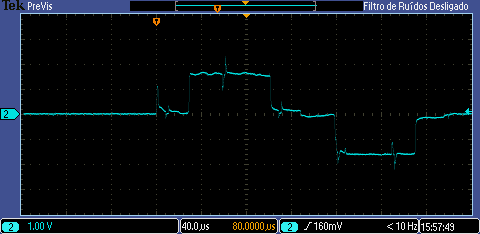
[picture p87: figure]

T0014

current: 5 mA

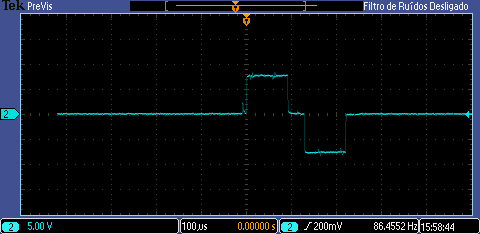
[picture p88: figure]

T0015

current: 10 mA

T0016

current: 35 mA

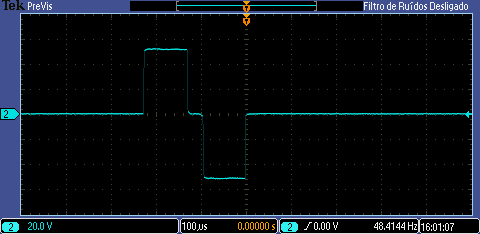
[picture p89: figure]

T0017

current: 69 mA

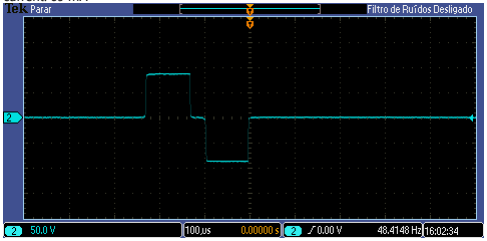
[picture p90: figure]

T0018

/****************************************************************************************/ 100R, PW: 500us, freq 100Hz

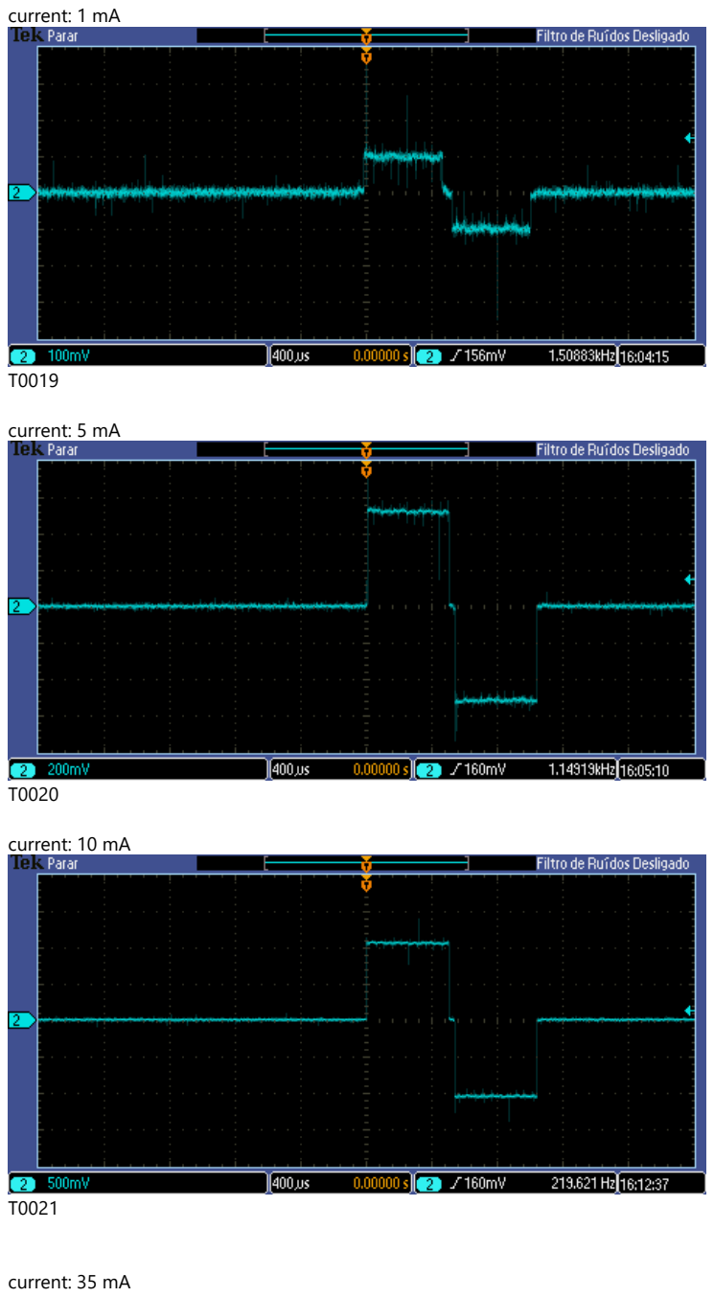
[picture p91: page 8]

current: 1 mA

T0019

current: 5 mA

T0020

current: 10 mA

T0021

current: 35 mA

T0022

current: 69 mA

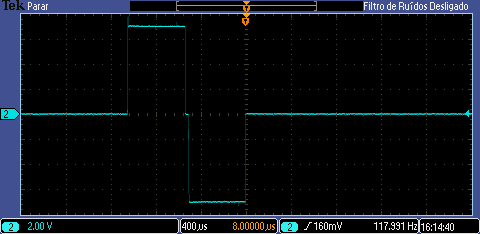
[picture p92: figure]

T0023

/****************************************************************************************/ 1500R, PW: 500us, freq 100Hz

current: 1 mA

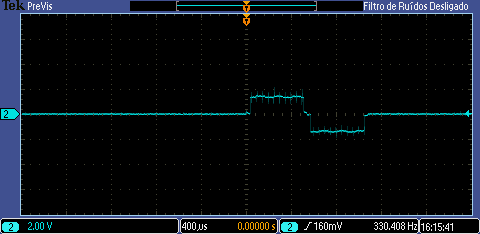
[picture p93: figure]

T0024

current: 5 mA

T0025

current: 10 mA

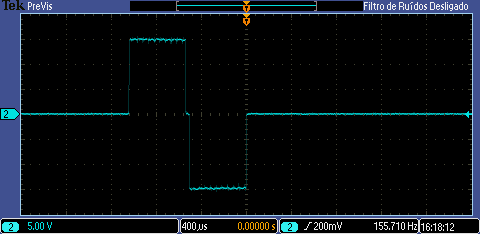
[picture p94: figure]

T0026

current: 35 mA

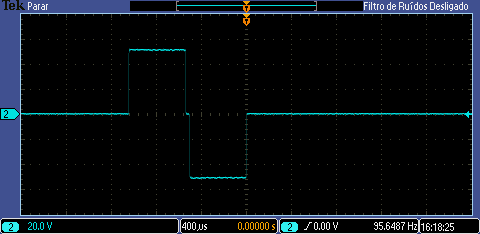
[picture p95: figure]

T0027

current: 69 mA

T0028

/****************************************************************************************/ 1500R, PW: 1000us, freq 200Hz

current: 1 mA

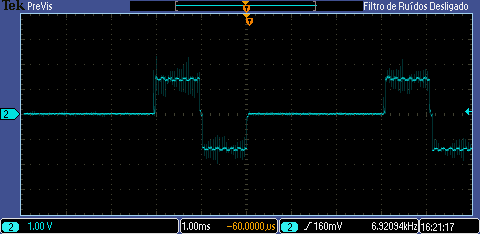
[picture p96: figure]

T0029

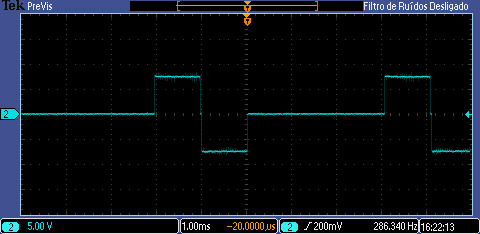
[picture p97: figure]

current: 5 mA

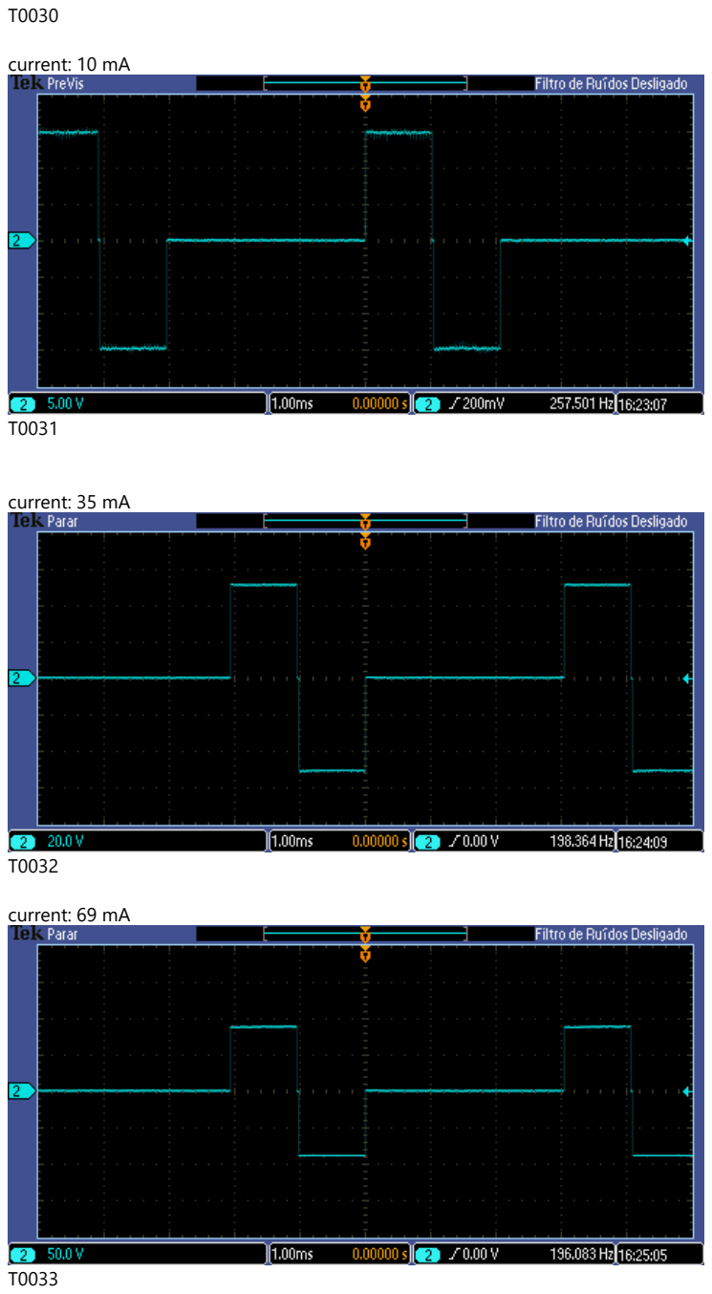
[picture p98: page 12]

T0030

current: 10 mA

T0031

current: 35 mA

T0032

current: 69 mA

T0033

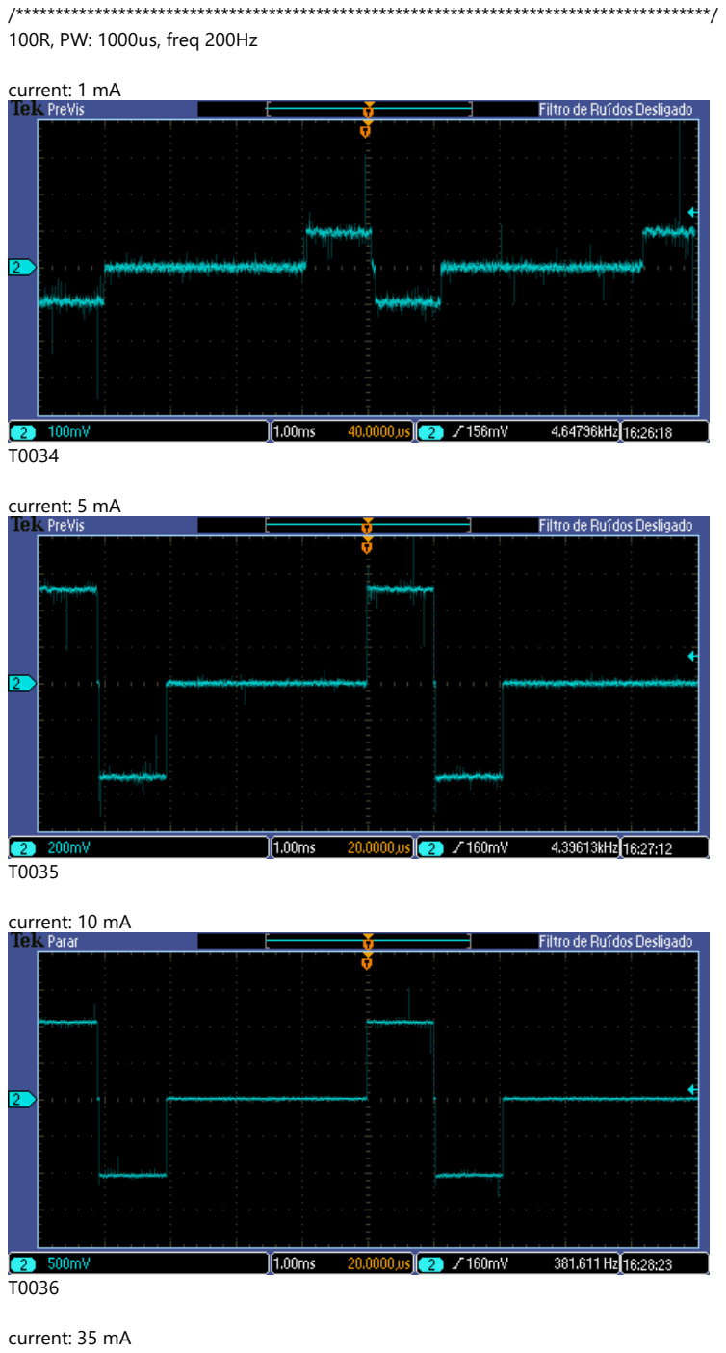
[picture p99: page 13]

/****************************************************************************************/ 100R, PW: 1000us, freq 200Hz

current: 1 mA

T0034

current: 5 mA

T0035

current: 10 mA

T0036

current: 35 mA

T0037

current: 69 mA

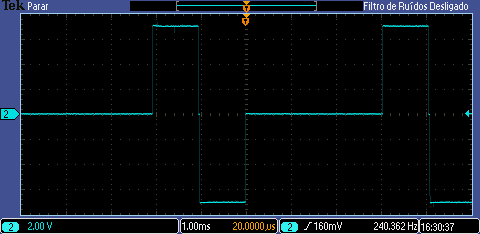
[picture p100: figure]

T0038
