lara-unb/Estimulema/Teste de Desempeño/Libro testes electro HTM.xlsx

Sheet: Hoja1
1mA |  |  |  |  |  | 10mA |  |  |  |  |  | 20mA
fre | pw | R1= 100 | R2= 470 | R3=1k | R4=1,5k | fre | pw | R1= 100 | R2= 470 | R3=1k | R4=1,5k | fre | pw | R1= 100 | R2= 470 | R3=1k | R4=1,5k
20 | 100 | 100mV | 470mV | 1V | 1.5V | 20 | 100 |  |  |  |  | 20 | 100
20 | 300 | 100mV | 470mV | 1V | 1.5V | 20 | 300 |  |  |  |  | 20 | 300
20 | 500 | 100mV | 470mV | 1V | 1.5V | 20 | 500 |  |  |  |  | 20 | 500
30 | 100 | 100mV | 470mV | 1V | 1.5V | 30 | 100 |  |  |  |  | 30 | 100
30 | 300 | 100mV | 470mV | 1V | 1.5V | 30 | 300 |  |  |  |  | 30 | 300
30 | 500 | 100mV | 470mV | 1V | 1.5V | 30 | 500 |  |  |  |  | 30 | 500
40 | 100 | 100mV | 470mV | 1V | 1.5V | 40 | 100 |  |  |  |  | 40 | 100
40 | 300 | 100mV | 470mV | 1V | 1.5V | 40 | 300 |  |  |  |  | 40 | 300
40 | 500 | 100mV | 470mV | 1V | 1.5V | 40 | 500 |  |  |  |  | 40 | 500
50 | 100 | 100mV | 470mV | 1V | 1.5V | 50 | 100 |  |  |  |  | 50 | 100
50 | 300 | 100mV | 470mV | 1V | 1.5V | 50 | 300 |  |  |  |  | 50 | 300
50 | 500 | 100mV | 470mV | 1V | 1.5V | 50 | 500 |  |  |  |  | 50 | 500
30mA |  |  |  |  |  | 40mA |  |  |  |  |  | 50mA
fre | pw | R1= 100 | R2= 470 | R3=1k | R4=1,5k | fre | pw | R1= 100 | R2= 470 | R3=1k | R4=1,5k | fre | pw | R1= 100 | R2= 470 | R3=1k | R4=1,5k
20 | 100 | 3V | 14V | 30V | 46V | 20 | 100 |  |  |  |  | 20 | 100
20 | 300 | 3V | 14V | 30V | 46V | 20 | 300 |  |  |  |  | 20 | 300
20 | 500 | 3V | 14V | 30V | 46V | 20 | 500 |  |  |  |  | 20 | 500
30 | 100 | 3V | 14V | 30V | 46V | 30 | 100 |  |  |  |  | 30 | 100
30 | 300 | 3V | 14V | 30V | 46V | 30 | 300 |  |  |  |  | 30 | 300
30 | 500 | 3V | 14V | 30V | 46V | 30 | 500 |  |  |  |  | 30 | 500
40 | 100 | 3V | 14V | 30V | 46V | 40 | 100 |  |  |  |  | 40 | 100
40 | 300 | 3V | 14V | 30V | 46V | 40 | 300 |  |  |  |  | 40 | 300
40 | 500 | 3V | 14V | 30V | 46V | 40 | 500 |  |  |  |  | 40 | 500
50 | 100 | 3V | 14V | 30V | 46V | 50 | 100 |  |  |  |  | 50 | 100
50 | 300 | 3V | 14V | 30.1V | 46V | 50 | 300 |  |  |  |  | 50 | 300
50 | 500 | 3V | 14V | 30.1V | 46V | 50 | 500 |  |  |  |  | 50 | 500
60mA |  |  |  |  |  | 70mA |  |  |  |  |  | 80mA
fre | pw | R1= 100 | R2= 470 | R3=1k | R4=1,5k | fre | pw | R1= 100 | R2= 470 | R3=1k | R4=1,5k | fre | pw | R1= 100 | R2= 470 | R3=1k | R4=1,5k
20 | 100 | 6.1V | 29V | 61V | 92V | 20 | 100 |  |  |  |  | 20 | 100 |  |  |  | 122V
20 | 300 | 6.1V | 29V | 61V | 92V | 20 | 300 |  |  |  |  | 20 | 300 |  |  |  | 122V
20 | 500 | 6.1V | 29V | 61V | 92V | 20 | 500 |  |  |  |  | 20 | 500 |  |  |  | 122V
30 | 100 | 6.1V | 29V | 61V | 92V | 30 | 100 |  |  |  |  | 30 | 100 |  |  |  | 122V
30 | 300 | 6.1V | 29V | 61V | 92V | 30 | 300 |  |  |  |  | 30 | 300 |  |  |  | 122V
30 | 500 | 6.1V | 29V | 61V | 92V | 30 | 500 |  |  |  |  | 30 | 500 |  |  |  | 122V
40 | 100 | 6.1V | 29V | 61V | 92V | 40 | 100 |  |  |  |  | 40 | 100 |  |  |  | 122V
40 | 300 | 6.1V | 29V | 61V | 92V | 40 | 300 |  |  |  |  | 40 | 300 |  |  |  | 122V
40 | 500 | 6.1V | 29V | 61V | 92V | 40 | 500 |  |  |  |  | 40 | 500 |  |  |  | 122V
50 | 100 | 6.1V | 29V | 61V | 92V | 50 | 100 |  |  |  |  | 50 | 100 |  |  |  | 122V
50 | 300 | 6.1V | 29V | 61V | 92V | 50 | 300 |  |  |  |  | 50 | 300 |  |  |  | 122V
50 | 500 | 6.1V | 29V | 61V | 92V | 50 | 500 |  |  |  |  | 50 | 500 |  |  |  | 122V
90mA |  |  |  |  |  | 100mA
fre | pw | R1= 100 | R2= 470 | R3=1k | R4=1,5k | fre | pw | R1= 100 | R2= 470 | R3=1k | R4=1,5k
20 | 100 |  |  |  | 130.5V | 20 | 100 | 2.1V |  | 100V | 130.5V
20 | 300 |  |  |  | 130.5V | 20 | 300 | 2.1V |  |  | 130.5V
20 | 500 |  |  |  | 130.5V | 20 | 500 | 2.1V |  |  | 130.5V
30 | 100 |  |  |  | 130.5V | 30 | 100 | 2.1V |  |  | 130.5V
30 | 300 |  |  |  | 130.5V | 30 | 300 | 2.1V |  |  | 130.5V
30 | 500 |  |  |  | 130.5V | 30 | 500 | 2.1V |  |  | 130.5V
40 | 100 |  |  |  | 130.5V | 40 | 100 | 2.1V |  |  | 130.5V
40 | 300 |  |  |  | 130.5V | 40 | 300 | 2.1V |  |  | 130.5V
40 | 500 |  |  |  | 130.5V | 40 | 500 | 2.1V |  |  | 130.5V
50 | 100 |  |  |  | 130.5V | 50 | 100 | 2.1V |  |  | 130.5V
50 | 300 |  |  |  | 130.5V | 50 | 300 | 2.1V |  |  | 130.5V
50 | 500 |  |  |  | 130.5V | 50 | 500 | 2.1V |  |  | 130.5V

Sheet: Dualpex
1mA
fre | pw | R1= 100 | R3=1k | R4=1,5k
20 | 100 | 100mV | 1V | 1.5V
20 | 300 | 100mV | 1V | 1.5V
20 | 500 | 100mV | 1V | 1.5V
30 | 100 | 100mV | 1V | 1.5V
30 | 300 | 100mV | 1V | 1.5V
30 | 500 | 100mV | 1V | 1.5V
40 | 100 | 100mV | 1V | 1.5V
40 | 300 | 100mV | 1V | 1.5V
40 | 500 | 100mV | 1V | 1.5V
50 | 100 | 100mV | 1V | 1.5V
50 | 300 | 100mV | 1V | 1.5V
50 | 500 | 100mV | 1V | 1.5V
30mA
fre | pw | R1= 100 | R3=1k | R4=1,5k
20 | 100 | 3V | 30V | 46V
20 | 300 | 3V | 30V | 46V
20 | 500 | 3V | 30V | 46V
30 | 100 | 3V | 30V | 46V
30 | 300 | 3V | 30V | 46V
30 | 500 | 3V | 30V | 46V
40 | 100 | 3V | 30V | 46V
40 | 300 | 3V | 30V | 46V
40 | 500 | 3V | 30V | 46V
50 | 100 | 3V | 30V | 46V
50 | 300 | 3V | 30.1V | 46V
50 | 500 | 3V | 30.1V | 46V
60mA
fre | pw | R1= 100 | R3=1k | R4=1,5k
20 | 100 | 6.1V | 61V | 92V
20 | 300 | 6.1V | 61V | 92V
20 | 500 | 6.1V | 61V | 92V
30 | 100 | 6.1V | 61V | 92V
30 | 300 | 6.1V | 61V | 92V
30 | 500 | 6.1V | 61V | 92V
40 | 100 | 6.1V | 61V | 92V
40 | 300 | 6.1V | 61V | 92V
40 | 500 | 6.1V | 61V | 92V
50 | 100 | 6.1V | 61V | 92V
50 | 300 | 6.1V | 61V | 92V
50 | 500 | 6.1V | 61V | 92V
100mA
fre | pw | R1= 100 | R3=1k | R4=1,5k
20 | 100 | 2.1V | 69V | 69V
20 | 300 | 2.1V | 69V | 69V
20 | 500 | 2.1V | 69V | 69V
30 | 100 | 2.1V | 69V | 69V
30 | 300 | 2.1V | 69V | 69V
30 | 500 | 2.1V | 69V | 69V
40 | 100 | 2.1V | 69V | 69V
40 | 300 | 2.1V | 69V | 69V
40 | 500 | 2.1V | 69V | 69V
50 | 100 | 2.1V | 69V | 69V
50 | 300 | 2.1V | 69V | 69V
50 | 500 | 2.1V | 69V | 69V

Sheet: Neodym
1mA
fre | pw | R1= 100 | R3=1k | R4=1,5k
20 | 100 | 100mV | 1V | 1.5V
20 | 300 | 100mV | 1V | 1.5V
20 | 500 | 100mV | 1V | 1.5V
30 | 100 | 100mV | 1V | 1.5V
30 | 300 | 100mV | 1V | 1.5V
30 | 500 | 100mV | 1V | 1.5V
40 | 100 | 100mV | 1V | 1.5V
40 | 300 | 100mV | 1V | 1.5V
40 | 500 | 100mV | 1V | 1.5V
50 | 100 | 100mV | 1V | 1.5V
50 | 300 | 100mV | 1V | 1.5V
50 | 500 | 100mV | 1V | 1.5V
30mA
fre | pw | R1= 100 | R3=1k | R4=1,5k
20 | 100 | 3V | 30V | 46V
20 | 300 | 3V | 30V | 46V
20 | 500 | 3V | 30V | 46V
30 | 100 | 3V | 30V | 46V
30 | 300 | 3V | 30V | 46V
30 | 500 | 3V | 30V | 46V
40 | 100 | 3V | 30V | 46V
40 | 300 | 3V | 30V | 46V
40 | 500 | 3V | 30V | 46V
50 | 100 | 3V | 30V | 46V
50 | 300 | 3V | 30.1V | 46V
50 | 500 | 3V | 30.1V | 46V
60mA
fre | pw | R1= 100 | R3=1k | R4=1,5k
20 | 100 | 6.1V | 61V | 92V
20 | 300 | 6.1V | 61V | 92V
20 | 500 | 6.1V | 61V | 92V
30 | 100 | 6.1V | 61V | 92V
30 | 300 | 6.1V | 61V | 92V
30 | 500 | 6.1V | 61V | 92V
40 | 100 | 6.1V | 61V | 92V
40 | 300 | 6.1V | 61V | 92V
40 | 500 | 6.1V | 61V | 92V
50 | 100 | 6.1V | 61V | 92V
50 | 300 | 6.1V | 61V | 92V
50 | 500 | 6.1V | 61V | 92V
100mA
fre | pw | R1= 100 | R3=1k | R4=1,5k
20 | 100 | 2.1V | 100V | 130.5V
20 | 300 | 2.1V |  | 130.5V
20 | 500 | 2.1V |  | 130.5V
30 | 100 | 2.1V |  | 130.5V
30 | 300 | 2.1V |  | 130.5V
30 | 500 | 2.1V |  | 130.5V
40 | 100 | 2.1V |  | 130.5V
40 | 300 | 2.1V |  | 130.5V
40 | 500 | 2.1V |  | 130.5V
50 | 100 | 2.1V |  | 130.5V
50 | 300 | 2.1V |  | 130.5V
50 | 500 | 2.1V |  | 130.5V

Sheet: Compex SP8
1mA
fre | pw | R1= 100 | R3=1k | R4=1,5k
20 | 100 | 100mV | 1V | 1.5V
20 | 300 | 100mV | 1V | 1.5V
20 | 500 | 100mV | 1V | 1.5V
30 | 100 | 100mV | 1V | 1.5V
30 | 300 | 100mV | 1V | 1.5V
30 | 500 | 100mV | 1V | 1.5V
40 | 100 | 100mV | 1V | 1.5V
40 | 300 | 100mV | 1V | 1.5V
40 | 500 | 100mV | 1V | 1.5V
50 | 100 | 100mV | 1V | 1.5V
50 | 300 | 100mV | 1V | 1.5V
50 | 500 | 100mV | 1V | 1.5V
30mA
fre | pw | R1= 100 | R3=1k | R4=1,5k
20 | 100 | 3V | 30V | 46V
20 | 300 | 3V | 30V | 46V
20 | 500 | 3V | 30V | 46V
30 | 100 | 3V | 30V | 46V
30 | 300 | 3V | 30V | 46V
30 | 500 | 3V | 30V | 46V
40 | 100 | 3V | 30V | 46V
40 | 300 | 3V | 30V | 46V
40 | 500 | 3V | 30V | 46V
50 | 100 | 3V | 30V | 46V
50 | 300 | 3V | 30.1V | 46V
50 | 500 | 3V | 30.1V | 46V
60mA
fre | pw | R1= 100 | R3=1k | R4=1,5k
20 | 100 | 6.1V | 61V | 92V
20 | 300 | 6.1V | 61V | 92V
20 | 500 | 6.1V | 61V | 92V
30 | 100 | 6.1V | 61V | 92V
30 | 300 | 6.1V | 61V | 92V
30 | 500 | 6.1V | 61V | 92V
40 | 100 | 6.1V | 61V | 92V
40 | 300 | 6.1V | 61V | 92V
40 | 500 | 6.1V | 61V | 92V
50 | 100 | 6.1V | 61V | 92V
50 | 300 | 6.1V | 61V | 92V
50 | 500 | 6.1V | 61V | 92V
100mA
fre | pw | R1= 100 | R3=1k | R4=1,5k
20 | 100 | 2.1V | 100V | 130.5V
20 | 300 | 2.1V |  | 130.5V
20 | 500 | 2.1V |  | 130.5V
30 | 100 | 2.1V |  | 130.5V
30 | 300 | 2.1V |  | 130.5V
30 | 500 | 2.1V |  | 130.5V
40 | 100 | 2.1V |  | 130.5V
40 | 300 | 2.1V |  | 130.5V
40 | 500 | 2.1V |  | 130.5V
50 | 100 | 2.1V |  | 130.5V
50 | 300 | 2.1V |  | 130.5V
50 | 500 | 2.1V |  | 130.5V

Sheet: Genesy1500
1mA
fre | pw | R1= 100 | R3=1k | R4=1,5k
20 | 100 | 100mV | 1V | 1.5V | Qualidade do sinal
20 | 300 | 100mV | 1V | 1.5V
20 | 500 | 100mV | 1V | 1.5V
30 | 100 | 100mV | 1V | 1.5V
30 | 300 | 100mV | 1V | 1.5V
30 | 500 | 100mV | 1V | 1.5V
40 | 100 | 100mV | 1V | 1.5V
40 | 300 | 100mV | 1V | 1.5V
40 | 500 | 100mV | 1V | 1.5V
50 | 100 | 100mV | 1V | 1.5V
50 | 300 | 100mV | 1V | 1.5V
50 | 500 | 100mV | 1V | 1.5V
30mA
fre | pw | R1= 100 | R3=1k | R4=1,5k
20 | 100 | 3V | 30V | 46V
20 | 300 | 3V | 30V | 46V
20 | 500 | 3V | 30V | 46V
30 | 100 | 3V | 30V | 46V
30 | 300 | 3V | 30V | 46V
30 | 500 | 3V | 30V | 46V
40 | 100 | 3V | 30V | 46V
40 | 300 | 3V | 30V | 46V
40 | 500 | 3V | 30V | 46V
50 | 100 | 3V | 30V | 46V
50 | 300 | 3V | 30.1V | 46V
50 | 500 | 3V | 30.1V | 46V
60mA
fre | pw | R1= 100 | R3=1k | R4=1,5k
20 | 100 | 6.1V | 61V | 92V
20 | 300 | 6.1V | 61V | 92V
20 | 500 | 6.1V | 61V | 92V
30 | 100 | 6.1V | 61V | 92V
30 | 300 | 6.1V | 61V | 92V
30 | 500 | 6.1V | 61V | 92V
40 | 100 | 6.1V | 61V | 92V
40 | 300 | 6.1V | 61V | 92V
40 | 500 | 6.1V | 61V | 92V
50 | 100 | 6.1V | 61V | 92V
50 | 300 | 6.1V | 61V | 92V
50 | 500 | 6.1V | 61V | 92V
100mA
fre | pw | R1= 100 | R3=1k | R4=1,5k
20 | 100 | 2.1V | 100V | 130.5V
20 | 300 | 2.1V |  | 130.5V
20 | 500 | 2.1V |  | 130.5V
30 | 100 | 2.1V |  | 130.5V
30 | 300 | 2.1V |  | 130.5V
30 | 500 | 2.1V |  | 130.5V
40 | 100 | 2.1V |  | 130.5V
40 | 300 | 2.1V |  | 130.5V
40 | 500 | 2.1V |  | 130.5V
50 | 100 | 2.1V |  | 130.5V
50 | 300 | 2.1V |  | 130.5V
50 | 500 | 2.1V |  | 130.5V

Sheet: HTM
1mA
fre | pw | R1= 100 | R3=1k | R4=1,5k
20 | 100 | 100mV | 1V | 1.5V
20 | 300 | 100mV | 1V | 1.5V
20 | 500 | 100mV | 1V | 1.5V
30 | 100 | 100mV | 1V | 1.5V
30 | 300 | 100mV | 1V | 1.5V
30 | 500 | 100mV | 1V | 1.5V
40 | 100 | 100mV | 1V | 1.5V
40 | 300 | 100mV | 1V | 1.5V
40 | 500 | 100mV | 1V | 1.5V
50 | 100 | 100mV | 1V | 1.5V
50 | 300 | 100mV | 1V | 1.5V
50 | 500 | 100mV | 1V | 1.5V
30mA
fre | pw | R1= 100 | R3=1k | R4=1,5k
20 | 100 | 3V | 30V | 46V
20 | 300 | 3V | 30V | 46V
20 | 500 | 3V | 30V | 46V
30 | 100 | 3V | 30V | 46V
30 | 300 | 3V | 30V | 46V
30 | 500 | 3V | 30V | 46V
40 | 100 | 3V | 30V | 46V
40 | 300 | 3V | 30V | 46V
40 | 500 | 3V | 30V | 46V
50 | 100 | 3V | 30V | 46V
50 | 300 | 3V | 30.1V | 46V
50 | 500 | 3V | 30.1V | 46V
60mA
fre | pw | R1= 100 | R3=1k | R4=1,5k
20 | 100 | 6.1V | 61V | 92V
20 | 300 | 6.1V | 61V | 92V
20 | 500 | 6.1V | 61V | 92V
30 | 100 | 6.1V | 61V | 92V
30 | 300 | 6.1V | 61V | 92V
30 | 500 | 6.1V | 61V | 92V
40 | 100 | 6.1V | 61V | 92V
40 | 300 | 6.1V | 61V | 92V
40 | 500 | 6.1V | 61V | 92V
50 | 100 | 6.1V | 61V | 92V
50 | 300 | 6.1V | 61V | 92V
50 | 500 | 6.1V | 61V | 92V
100mA
fre | pw | R1= 100 | R3=1k | R4=1,5k
20 | 100 | 2.1V | 100V | 130.5V
20 | 300 | 2.1V |  | 130.5V
20 | 500 | 2.1V |  | 130.5V
30 | 100 | 2.1V |  | 130.5V
30 | 300 | 2.1V |  | 130.5V
30 | 500 | 2.1V |  | 130.5V
40 | 100 | 2.1V |  | 130.5V
40 | 300 | 2.1V |  | 130.5V
40 | 500 | 2.1V |  | 130.5V
50 | 100 | 2.1V |  | 130.5V
50 | 300 | 2.1V |  | 130.5V
50 | 500 | 2.1V |  | 130.5V

Sheet: Stimulema
1mA
fre | pw | R1= 100 | R3=1k | R4=1,5k
20 | 100 | 100mV | 1V | 1.5V
20 | 300 | 100mV | 1V | 1.5V
20 | 500 | 100mV | 1V | 1.5V
30 | 100 | 100mV | 1V | 1.5V
30 | 300 | 100mV | 1V | 1.5V
30 | 500 | 100mV | 1V | 1.5V
40 | 100 | 100mV | 1V | 1.5V
40 | 300 | 100mV | 1V | 1.5V
40 | 500 | 100mV | 1V | 1.5V
50 | 100 | 100mV | 1V | 1.5V
50 | 300 | 100mV | 1V | 1.5V
50 | 500 | 100mV | 1V | 1.5V
30mA
fre | pw | R1= 100 | R3=1k | R4=1,5k
20 | 100 | 3V | 30V | 46V
20 | 300 | 3V | 30V | 46V
20 | 500 | 3V | 30V | 46V
30 | 100 | 3V | 30V | 46V
30 | 300 | 3V | 30V | 46V
30 | 500 | 3V | 30V | 46V
40 | 100 | 3V | 30V | 46V
40 | 300 | 3V | 30V | 46V
40 | 500 | 3V | 30V | 46V
50 | 100 | 3V | 30V | 46V
50 | 300 | 3V | 30.1V | 46V
50 | 500 | 3V | 30.1V | 46V
60mA
fre | pw | R1= 100 | R3=1k | R4=1,5k
20 | 100 | 6.1V | 61V | 92V
20 | 300 | 6.1V | 61V | 92V
20 | 500 | 6.1V | 61V | 92V
30 | 100 | 6.1V | 61V | 92V
30 | 300 | 6.1V | 61V | 92V
30 | 500 | 6.1V | 61V | 92V
40 | 100 | 6.1V | 61V | 92V
40 | 300 | 6.1V | 61V | 92V
40 | 500 | 6.1V | 61V | 92V
50 | 100 | 6.1V | 61V | 92V
50 | 300 | 6.1V | 61V | 92V
50 | 500 | 6.1V | 61V | 92V
100mA
fre | pw | R1= 100 | R3=1k | R4=1,5k
20 | 100 | 2.1V | 100V | 130.5V
20 | 300 | 2.1V |  | 130.5V
20 | 500 | 2.1V |  | 130.5V
30 | 100 | 2.1V |  | 130.5V
30 | 300 | 2.1V |  | 130.5V
30 | 500 | 2.1V |  | 130.5V
40 | 100 | 2.1V |  | 130.5V
40 | 300 | 2.1V |  | 130.5V
40 | 500 | 2.1V |  | 130.5V
50 | 100 | 2.1V |  | 130.5V
50 | 300 | 2.1V |  | 130.5V
50 | 500 | 2.1V |  | 130.5V

Sheet: carga vs corrente 100r
carga 100
Estimulador | Corrente [mA]
Referencia | 10 | -10 | 30 | -30 | 60 | -60 | 100 | -100 | Erro maximo
Dualpex 071 | 10.32 | -10.8 | 29.31 | -29.73 | 60.21 | -59.34 | 67.26 | -66.73 | 33.27 | 0.2 | 0.49 | 0.07 | 0.42 | -0.2 | 0.16 | 0.24 | -0.24
Neurodym Esthetic | 10.61 | -10.04 | 24.04 | -23.44 | 48.552 | -46.0922 | 60.58 | -57.21 | 42.7891 | 0.55 | -0.21 | -0.46 | -0.55 | -0.39 | 0.37 | -0.38 | 0.61
Tens-Fes HTM | 2.42 | -0.12 | 29.3 | -20.10 | 67.05 | -30.17 | 86.6 | -27.71 | 72.288 | 0.54 | -0.5 | 0.24 | -0.2 | 0.25 | 0.22 | 0.06 | -0.24
Genesy 1500 | 10.54 | -9.7 | 29.22 | -29.97 | 60.56 | -59.82 | 100.39 | -99.6 | 0.78 | -0.38 | 0.33 | -0.48 | -0.14 | 0.49 | -0.37 | -0.41 | -0.75
Estimulador Proposto | 10.12 | -10.25 | 29.81 | -30.11 | 60.25 | -59.93 | 100.63 | -100.33 | 0.63 | -0.04 | 0.44 | 0.8 | 0.31 | 0.54 | -0.37 | -0.52 | 0.32
 |  |  |  |  |  |  |  |  |  | -0.59 | -0.07 | 0.56 | -0.11 | 0.03 | 0.29 | -0.04 | -0.74
Erros |  |  |  |  |  |  |  |  |  | -0.37 | 0.33 | 0.75 | -0.24 | -0.04 | 0.18 | -0.5 | 0.53
Dualpex 071 | 0.32 | 0.8 | 0.69 | 0.27 | 0.21 | 0.66 | 32.74 | 33.27 | 33.27 | 0.4 | 0.04 | -0.59 | -0.73 | 0.3 | -0.66 | 0.44 | -0.09
Neurodym Esthetic | 0.61 | 0.04 | 5.96 | 6.5612 | 11.448 | 13.9078 | 39.424 | 42.7891 | 42.7891
Tens-Fes HTM | 7.58 | 9.879 | 0.7 | 9.9 | 7.05 | 29.8275 | 13.4 | 72.288 | 72.288
Genesy 1500 | 0.54 | 0.3 | 0.78 | 0.03 | 0.56 | 0.18 | 0.39 | 0.4 | 0.78
Estimulador Proposto | 0.12 | 0.25 | 0.19 | 0.11 | 0.25 | 0.07 | 0.63 | 0.33 | 0.63

Sheet: carga vs corrente 470r
carga 470
Estimulador | Corrente [mA]
Referencia | 10 | -10 | 30 | -30 | 60 | -60 | 100 | -100 | Erro maximo
Dualpex 071 | 9.74 | -10.64 | 30.78 | -29.79 | 60.37 | -60.14 | 68.07 | -66.72 | 33.28 | -0.51 | 0.49 | 0.32 | 0.58 | 0.1 | 0.34 | -0.26 | -0.61
Neurodym Esthetic | 10.74 | -10.65 | 23.62 | -23.65 | 48.72 | -46.5388 | 60.25 | -57.06 | 42.943 | 0.32 | 0.33 | 0.02 | 0.06 | 0.18 | 0.03 | 0.51 | -0.63
Tens-Fes HTM | 9 | -0.09 | 34.3 | -1.01 | 67.05 | -1.48 | 89.1 | -2.67 | 97.327 | 0.1 | 0.57 | -0.69 | -0.23 | -0.01 | -0.33 | 0.73 | 0.66
Genesy 1500 | 10.83 | -9.48 | 30.45 | -28.86 | 61.24 | -57.51 | 100.48 | -97.43 | 2.57 | -0.39 | 0.53 | 0.29 | -0.32 | -0.37 | -0.29 | -0.66 | -0.8
Estimulador Proposto | 10.25 | -10.32 | 30.21 | -30.18 | 60.51 | -59.9 | 100.48 | -100.7 | 0.7 | -0.14 | 0.39 | -0.32 | 0.73 | 0.53 | -0.55 | -0.68 | -0.27
 |  |  |  |  |  |  |  |  |  | 0.24 | 0.54 | -0.21 | -0.39 | 0.49 | -0.12 | -0.14 | -0.64
Erros |  |  |  |  |  |  |  |  |  | 0.59 | -0.06 | -0.72 | -0.9 | 0.02 | -0.61 | 0.16 | 0.14
Dualpex 071 | 0.26 | 0.64 | 0.78 | 0.21 | 0.37 | 0.14 | 31.93 | 33.28 | 33.28 | 0.02 | -0.6 | 0.75 | 0.73 | -0.26 | -0.64 | -0.43 | -0.41
Neurodym Esthetic | 0.74 | 0.65 | 6.384 | 6.3533 | 11.28 | 13.4612 | 39.748 | 42.943 | 42.943
Tens-Fes HTM | 1 | 9.91 | 4.3 | 28.995 | 7.05 | 58.5249 | 10.9 | 97.327 | 97.327
Genesy 1500 | 0.83 | 0.52 | 0.45 | 1.14 | 1.24 | 2.49 | 0.48 | 2.57 | 2.57
Estimulador Proposto | 0.25 | 0.32 | 0.21 | 0.18 | 0.51 | 0.1 | 0.48 | 0.7 | 0.7

Sheet: carga vs corrente 1k
carga 470
Estimulador | Corrente [mA]
Referencia | 10.00 | -10.00 | 30.00 | -30.00 | 60.00 | -60.00 | 100.00 | -100.00 | Erro maximo
Dualpex 071 | 10.16 | -10.70 | 30.15 | -30.38 | 61.22 | -60.52 | 68.33 | -66.26 | 33.74 | 0.14 | 0.08 | -0.44 | 0.74 | 0.07 | 0.36 | 0.75 | 0.49
Neurodym Esthetic | 10.10 | -11.06 | 23.45 | -23.38 | 36.97 | -33.88 | 40.72 | -37.24 | 62.76 | 0.34 | 0.7 | 0.63 | 0.84 | 0.5 | -0.3 | -0.77 | 0.72
Tens-Fes HTM | 9.00 | -0.09 | 34.30 | -1.01 | 67.05 | -1.48 | 89.10 | -2.67 | 97.33 | 0.36 | 0.18 | -0.66 | 0.9 | 0.02 | -0.62 | 0.78 | 0.39
Genesy 1500 | 10.76 | -10.00 | 30.51 | -28.44 | 61.12 | -57.37 | 101.97 | -96.12 | 3.88 | -0.33 | -0.35 | 0.3 | -0.77 | -0.14 | 0.46 | 0.79 | 0.79
Estimulador Proposto | 10.02 | -10.36 | 29.97 | -30.71 | 61.05 | -59.98 | 101.63 | -100.83 | 1.63 | 0.17 | 0.56 | -0.23 | 0.07 | -0.56 | 0.07 | 0.25 | 0.23
 |  |  |  |  |  |  |  |  |  | 0.54 | -0.54 | 0.13 | -0.61 | -0.28 | 0.59 | -0.54 | 0.55
Erros |  |  |  |  |  |  |  |  |  | -0.3 | 0.17 | 0.12 | -0.56 | 0.44 | -0.56 | -0.24 | -0.72
Dualpex 071 | 0.16 | 0.7 | 0.15 | 0.38 | 1.22 | 0.52 | 31.67 | 33.74 | 33.74 | -0.57 | -0.17 | 0.23 | -0.71 | 0.56 | 0.38 | 0.07 | 0.6
Neurodym Esthetic | 0.1 | 1.06 | 6.552 | 6.6228 | 23.034 | 26.1192 | 59.28 | 62.7558 | 62.7558
Tens-Fes HTM | 1 | 9.91 | 4.3 | 28.995 | 7.05 | 58.5249 | 10.9 | 97.327 | 97.327
Genesy 1500 | 0.76 | 0 | 0.51 | 1.56 | 1.12 | 2.63 | 1.97 | 3.88 | 3.88
Estimulador Proposto | 0.02 | 0.36 | 0.03 | 0.71 | 1.05 | 0.02 | 1.63 | 0.83 | 1.63

Sheet: Planilha11
Equipamento | Corrente [mA]
Referencia | 10.00 | -10.00 | 30.00 | -30.00 | 60.00 | -60.00 | 100.00 | -100.00 | Erro maximo
Estimulador 1 | 10.32 | -10.80 | 29.31 | -29.73 | 60.21 | -59.34 | 67.26 | -66.73 | 33.27
Estimulador 2 | 10.61 | -10.04 | 24.04 | -23.44 | 48.55 | -46.09 | 60.58 | -57.21 | 42.79
Estimulador 3 | 2.42 | -0.12 | 29.30 | -20.10 | 67.05 | -30.17 | 86.60 | -27.71 | 72.29
Estimulador 4 | 10.54 | -9.70 | 29.22 | -29.97 | 60.56 | -59.82 | 100.39 | -99.60 | 0.78
Estimulador Proposto | 10.12 | -10.25 | 29.81 | -30.11 | 60.25 | -59.93 | 100.63 | -100.33 | 0.63
Estimulador | Corrente [mA]
Referencia | 10 | -10 | 30 | -30 | 60 | -60 | 100 | -100 | Erro maximo
Dualpex 071 | 9.74 | -10.64 | 30.78 | -29.79 | 60.37 | -60.14 | 68.07 | -66.72 | 33.28
Neurodym Esthetic | 10.74 | -10.65 | 23.616 | -23.6467 | 48.72 | -46.5388 | 60.252 | -57.057 | 42.943
Tens-Fes HTM | 9 | -0.09 | 34.3 | -1.005 | 67.05 | -1.4751 | 89.1 | -2.673 | 97.327
Genesy 1500 | 10.83 | -9.48 | 30.45 | -28.86 | 61.24 | -57.51 | 100.48 | -97.43 | 2.57
Estimulador Proposto | 10.25 | -10.32 | 30.21 | -30.18 | 60.51 | -59.9 | 100.48 | -100.7 | 0.7
Estimulador | Corrente [mA]
Referencia | 10.00 | -10.00 | 30.00 | -30.00 | 60.00 | -60.00 | 100.00 | -100.00 | Erro maximo
Estimulador 1 | 10.16 | -10.70 | 30.15 | -30.38 | 61.22 | -60.52 | 68.33 | -66.26 | 33.74
Estimulador 2 | 10.10 | -11.06 | 23.45 | -23.38 | 49.29 | -45.77 | 61.08 | -57.38 | 42.62
Estimulador 3 | 9.21 | -0.09 | 34.30 | -1.01 | 67.05 | -1.48 | 89.10 | -2.67 | 97.33
Estimulador 4 | 10.76 | -10.00 | 30.51 | -28.44 | 61.12 | -57.37 | 101.97 | -96.12 | 3.88
Estimulador Proposto | 10.02 | -10.36 | 29.97 | -30.71 | 61.05 | -59.98 | 101.63 | -100.83 | 1.63
