lara-unb/Estimulema/Teste de Desempeño/GENESY1500/Libro testes electro.xlsx

1mA |  |  |  |  |  |  | 10mA |  |  |  |  |  |  | 20mA
fre | pw | R1= 100 | R2= 470 | R3=1k | R4=1,5k | pw_r | fre | pw | R1= 100 | R2= 470 | R3=1k | R4=1,5k | pw_r | fre | pw | R1= 100 | R2= 470 | R3=1k | R4=1,5k | pw_r
20 | 100 | 100mV | 470mV | 1V | 1.5V | 49800 | 10 | 100 |  |  |  |  | 99800 | 20 | 100 |  |  |  |  | 49800
20 | 300 | 100mV | 470mV | 1V | 1.5V | 49400 | 10 | 300 |  |  |  |  | 99400 | 20 | 300 |  |  |  |  | 49400
20 | 500 | 100mV | 470mV | 1V | 1.5V | 49000 | 10 | 500 |  |  |  |  | 99000 | 20 | 500 |  |  |  |  | 49000
30 | 100 | 100mV | 470mV | 1V | 1.5V | 33133.33333 | 35 | 100 |  |  |  |  | 28371.42857 | 30 | 100 |  |  |  |  | 33133.33333
30 | 300 | 100mV | 470mV | 1V | 1.5V | 32733.33333 | 35 | 300 |  |  |  |  | 27971.42857 | 30 | 300 |  |  |  |  | 32733.33333
30 | 500 | 100mV | 470mV | 1V | 1.5V | 32333.33333 | 35 | 500 |  |  |  |  | 27571.42857 | 30 | 500 |  |  |  |  | 32333.33333
40 | 100 | 100mV | 470mV | 1V | 1.5V | 24800 | 40 | 100 |  |  |  |  | 24800 | 40 | 100 |  |  |  |  | 24800
40 | 300 | 100mV | 470mV | 1V | 1.5V | 24400 | 40 | 300 |  |  |  |  | 24400 | 40 | 300 |  |  |  |  | 24400
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
