lara-unb/Estimulema/Teste de Desempeño/Imagenes osciloscopio/T0001.CSV

Model | DPO2012
Firmware Version | 1.25
Point Format | Y
Horizontal Units | S
Horizontal Scale | 1
Sample Interval | 8e-05
Filter Frequency | 550000
Record Length | 125000
Gating | 0.0% to 100.0% |  | 0.0% to 100.0%
Probe Attenuation | 10 |  | 10
Vertical Units | V |  | V
Vertical Offset | 0 |  | 0
Vertical Scale | 10 |  | 10
Label
TIME | CH1 | CH1 Peak Detect | CH2 | CH2 Peak Detect
-5.00000e+00 | -11 | -10.6 | 0.2 | 1
-4.99992e+00 | -11 | -11.8 | 0.6 | -0.2
-4.99984e+00 | -11 | -10.6 | 0.2 | 1
-4.99976e+00 | -11 | -11.8 | 0.6 | -0.2
-4.99968e+00 | -11 | -10.6 | 0.6 | 1
-4.99960e+00 | -11 | -11.8 | 0.2 | -0.2
-4.99952e+00 | -11 | -10.6 | 0.2 | 1
-4.99944e+00 | -11 | -11.8 | 0.2 | -0.2
-4.99936e+00 | -11 | -10.6 | 0.6 | 1
-4.99928e+00 | -11 | -11.8 | 0.6 | -0.2
-4.99920e+00 | -11 | -10.6 | 0.6 | 1
-4.99912e+00 | -11 | -11.8 | 0.6 | -0.2
-4.99904e+00 | -11 | -10.6 | 0.2 | 1
-4.99896e+00 | -11 | -11.8 | 0.2 | -0.2
-4.99888e+00 | -11 | -10.6 | 0.2 | 1
-4.99880e+00 | -11 | -11.8 | 0.2 | -0.2
-4.99872e+00 | -11 | -10.6 | 0.2 | 1
-4.99864e+00 | -11 | -11.8 | 0.2 | -0.2
-4.99856e+00 | -11 | -10.6 | 0.2 | 1
-4.99848e+00 | -11 | -11.8 | 0.2 | -0.2
-4.99840e+00 | -11 | -10.6 | 0.2 | 1
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
