lara-unb/Estimulema/Interfaces Python/teste total/data anterior/teste .xlsx

Sheet: Planilha1
1.22
1.26
1.25
1.24
1.26
1.28
1.39
1.99
2.58
2.62
2.82
2.81
2.67
2.64
2.66
2.68
2.69
2.72
2.66
2.61
2.56
2.23
1.76
1.47
1.33
1.27
1.24
1.21
1.19
1.2
1.2
1.18
1.17
1.18
1.19
1.21
1.18
1.16
1.17
1.18
1.16
1.16
1.19
1.18
1.16
1.16
1.18
1.17
1.16
1.15
1.15
1.17
1.18
1.19
1.2
1.19
1.15
1.15
1.17
1.16
1.16
1.16
1.16
1.17
1.17
1.16
1.15
1.17
1.17
1.19
1.2
1.18
1.19
1.21
1.19
1.18
1.17
1.2
1.21
1.2
1.18
1.17
1.17
1.2
1.18
1.17
1.16
1.15
1.2
1.21
1.18
1.17
1.19
1.21
1.21
1.19
1.17
1.16
1.16
1.16
1.18
1.2
1.21
1.18
1.17
1.18
1.2
1.18
1.18
1.21
1.24
1.23
1.24
1.24
1.32
1.78
2.56
2.55
2.53
2.78
2.71
2.61
2.51
2.52
2.62
2.59
2.61
2.62
2.57
2.41
2
1.59
1.41
1.32
1.27
1.26
1.23
1.24
1.22
1.22
1.19
1.19
1.2
1.2
1.17
1.17
1.19
1.2
1.19
1.21
1.22
1.21
1.21
1.21
1.21
1.24
1.24
1.22
1.22
1.22
1.22
1.21
1.21
1.2
1.2
1.22
1.21
1.19
1.2
1.22
1.2
1.19
1.19
1.21
1.22
1.2
1.18
1.2
1.21
1.21
1.2
1.2
1.21
1.2
1.2
1.2
1.2
1.23
1.24
1.24
1.22
1.22
1.21
1.18
1.19
1.2
1.2
1.21
1.22
1.2
1.21
1.22
1.23
1.21
1.2
1.21
1.18
1.17
1.2
1.22
1.18
1.16
1.16
1.18
1.21
1.21
1.23
1.23
1.23
1.22
1.21
1.24
1.27
1.48
2.29
2.6
2.44
2.68
2.75
2.64
2.57
2.56
2.67
2.67
2.62
2.61
2.56
2.42
2.02
1.57
1.38
1.31
1.25
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
