lara-unb/Estimulema/Teste de Desempeño/Dualpex 071 performance test/Dualpex 071 performance test data CSV/T0000.CSV

Model | DPO2012
Firmware Version | 1.25
Point Format | Y
Horizontal Units | S
Horizontal Scale | 0.0001
Sample Interval | 8e-09
Filter Frequency | 1e+08
Record Length | 125000
Gating | 0.0% to 100.0%
Probe Attenuation | 10
Vertical Units | V
Vertical Offset | 0
Vertical Scale | 0.2
Label
TIME | CH2 | CH2 Peak Detect
-5.26000e-04 | 0.02 | 0.012
-5.25992e-04 | 0.004 | -0.004
-5.25984e-04 | -0.004 | 0.02
-5.25976e-04 | 0.012 | -0.012
-5.25968e-04 | 0.02 | 0.012
-5.25960e-04 | 0.004 | -0.004
-5.25952e-04 | 0.004 | 0.028
-5.25944e-04 | 0.012 | -0.004
-5.25936e-04 | -0.004 | 0.004
-5.25928e-04 | 0.004 | -0.004
-5.25920e-04 | 0.012 | 0.012
-5.25912e-04 | 0.012 | -0.012
-5.25904e-04 | 0.004 | 0.012
-5.25896e-04 | -0.004 | -0.004
-5.25888e-04 | 0.012 | 0.02
-5.25880e-04 | 0.012 | -0.02
-5.25872e-04 | 0.004 | 0.012
-5.25864e-04 | 0.004 | -0.012
-5.25856e-04 | 0.012 | 0.02
-5.25848e-04 | 0.028 | -0.004
-5.25840e-04 | 0.012 | 0.012
-5.25832e-04 | -0.004 | -0.004
-5.25824e-04 | -0.004 | 0.028
-5.25816e-04 | 0.012 | -0.012
-5.25808e-04 | 0.012 | 0.02
-5.25800e-04 | 0.004 | -0.004
-5.25792e-04 | 0.012 | 0.02
-5.25784e-04 | 0.004 | -0.012
-5.25776e-04 | -0.012 | 0.012
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
