lara-unb/Estimulema/Teste de Desempeño/Dualpex 071 performance test/Dualpex 071 performance test data CSV/T0001.CSV

Model | DPO2012
Firmware Version | 1.25
Point Format | Y
Horizontal Units | S
Horizontal Scale | 0.0001
Sample Interval | 8e-09
Filter Frequency | 1e+08
Record Length | 125000
Gating | 0.0% to 100.0%
Probe Attenuation | 10
Vertical Units | V
Vertical Offset | 0
Vertical Scale | 0.2
Label
TIME | CH2 | CH2 Peak Detect
-4.84000e-04 | 0.012 | 0.02
-4.83992e-04 | 0.012 | -0.004
-4.83984e-04 | 0.012 | 0.02
-4.83976e-04 | 0.004 | -0.012
-4.83968e-04 | 0.004 | 0.012
-4.83960e-04 | 0.004 | -0.012
-4.83952e-04 | 0.012 | 0.02
-4.83944e-04 | 0.012 | -0.012
-4.83936e-04 | 0.012 | 0.012
-4.83928e-04 | -0.004 | -0.004
-4.83920e-04 | 0.004 | 0.012
-4.83912e-04 | 0.004 | -0.012
-4.83904e-04 | 0.012 | 0.012
-4.83896e-04 | 0.004 | -0.004
-4.83888e-04 | 0.004 | 0.02
-4.83880e-04 | 0.02 | -0.004
-4.83872e-04 | 0.012 | 0.004
-4.83864e-04 | 0.004 | -0.004
-4.83856e-04 | -0.004 | 0.02
-4.83848e-04 | 0.02 | -0.012
-4.83840e-04 | 0.004 | 0.004
-4.83832e-04 | 0.004 | -0.012
-4.83824e-04 | 0.012 | 0.028
-4.83816e-04 | 0.012 | -0.012
-4.83808e-04 | -0.004 | 0.012
-4.83800e-04 | 0.004 | -0.004
-4.83792e-04 | 0.012 | 0.012
-4.83784e-04 | 0.02 | -0.02
-4.83776e-04 | -0.004 | 0.012
-4.83768e-04 | -0.012 | -0.012
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
