lara-unb/Estimulema/Teste de Desempeño/Dualpex 071 performance test/Dualpex 071 performance test data CSV/T0002.CSV

Model | DPO2012
Firmware Version | 1.25
Point Format | Y
Horizontal Units | S
Horizontal Scale | 0.0001
Sample Interval | 8e-09
Filter Frequency | 1e+08
Record Length | 125000
Gating | 0.0% to 100.0%
Probe Attenuation | 10
Vertical Units | V
Vertical Offset | 0
Vertical Scale | 0.5
Label
TIME | CH2 | CH2 Peak Detect
-4.90000e-04 | 0.01 | 0.03
-4.89992e-04 | 0.01 | -0.01
-4.89984e-04 | 0.03 | 0.05
-4.89976e-04 | 0.03 | -0.01
-4.89968e-04 | 0.03 | 0.03
-4.89960e-04 | 0.03 | -0.01
-4.89952e-04 | 0.03 | 0.03
-4.89944e-04 | 0.03 | -0.01
-4.89936e-04 | 0.01 | 0.03
-4.89928e-04 | 0.03 | -0.01
-4.89920e-04 | 0.05 | 0.03
-4.89912e-04 | 0.05 | -0.01
-4.89904e-04 | 0.03 | 0.05
-4.89896e-04 | 0.03 | 0.01
-4.89888e-04 | 0.05 | 0.05
-4.89880e-04 | 0.03 | -0.01
-4.89872e-04 | 0.01 | 0.05
-4.89864e-04 | 0.03 | 0.01
-4.89856e-04 | 0.01 | 0.03
-4.89848e-04 | 0.03 | -0.01
-4.89840e-04 | -0.01 | 0.03
-4.89832e-04 | 0.01 | -0.01
-4.89824e-04 | 0.03 | 0.03
-4.89816e-04 | 0.03 | -0.03
-4.89808e-04 | 0.01 | 0.03
-4.89800e-04 | 0.03 | -0.01
-4.89792e-04 | 0.05 | 0.05
-4.89784e-04 | 0.03 | -0.01
-4.89776e-04 | 0.03 | 0.05
-4.89768e-04 | 0.05 | -0.01
-4.89760e-04 | 0.03 | 0.05
-4.89752e-04 | 0.03 | 0.01
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
