lara-unb/Estimulema/Teste de Desempeño/Dualpex 071 performance test/Dualpex 071 performance test data CSV/T0003.CSV

Model | DPO2012
Firmware Version | 1.25
Point Format | Y
Horizontal Units | S
Horizontal Scale | 0.0001
Sample Interval | 8e-09
Filter Frequency | 1e+08
Record Length | 125000
Gating | 0.0% to 100.0%
Probe Attenuation | 10
Vertical Units | V
Vertical Offset | 0
Vertical Scale | 1
Label
TIME | CH2 | CH2 Peak Detect
-5.00000e-04 | 0.06 | 0.06
-4.99992e-04 | 0.02 | -0.02
-4.99984e-04 | 0.06 | 0.06
-4.99976e-04 | 0.02 | -0.02
-4.99968e-04 | 0.06 | 0.06
-4.99960e-04 | 0.06 | -0.02
-4.99952e-04 | 0.02 | 0.06
-4.99944e-04 | 0.06 | -0.02
-4.99936e-04 | 0.06 | 0.06
-4.99928e-04 | 0.02 | -0.02
-4.99920e-04 | 0.02 | 0.06
-4.99912e-04 | 0.06 | -0.02
-4.99904e-04 | 0.02 | 0.06
-4.99896e-04 | 0.02 | -0.02
-4.99888e-04 | 0.02 | 0.06
-4.99880e-04 | 0.02 | -0.02
-4.99872e-04 | 0.06 | 0.06
-4.99864e-04 | 0.02 | -0.02
-4.99856e-04 | 0.06 | 0.06
-4.99848e-04 | 0.06 | -0.02
-4.99840e-04 | 0.02 | 0.06
-4.99832e-04 | 0.06 | -0.02
-4.99824e-04 | 0.06 | 0.06
-4.99816e-04 | 0.06 | -0.02
-4.99808e-04 | 0.06 | 0.06
-4.99800e-04 | 0.02 | -0.02
-4.99792e-04 | 0.06 | 0.06
-4.99784e-04 | 0.06 | -0.02
-4.99776e-04 | 0.02 | 0.06
-4.99768e-04 | 0.02 | -0.02
-4.99760e-04 | 0.06 | 0.06
-4.99752e-04 | 0.06 | -0.02
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
