lara-unb/Estimulema/Interfaces Python/teste total/piera der/1/load/data of right leg.png

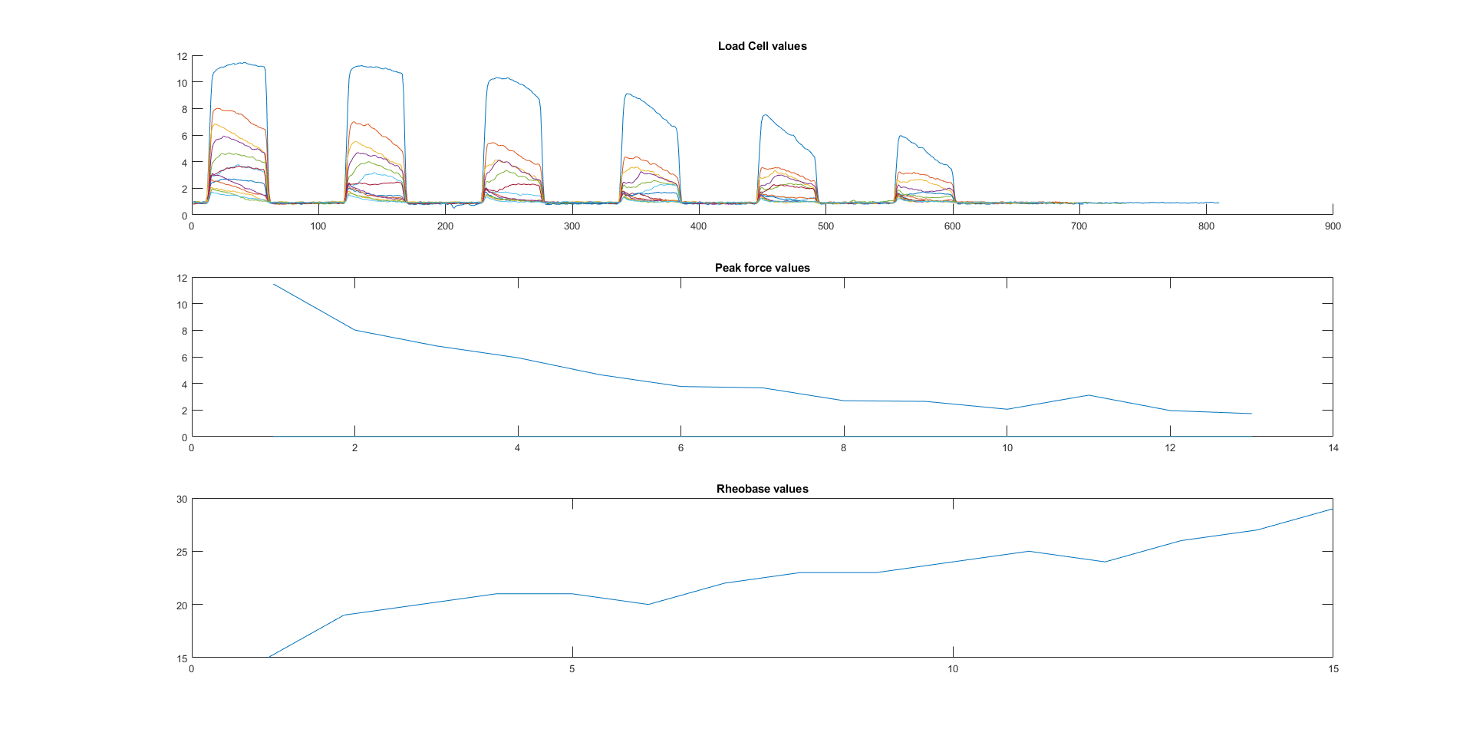
Interfaces Python/teste total/piera der/1/load/data of right leg.png
