lara-unb/Estimulema/Interfaces Python/teste total/piera der/2/data of left leg.png

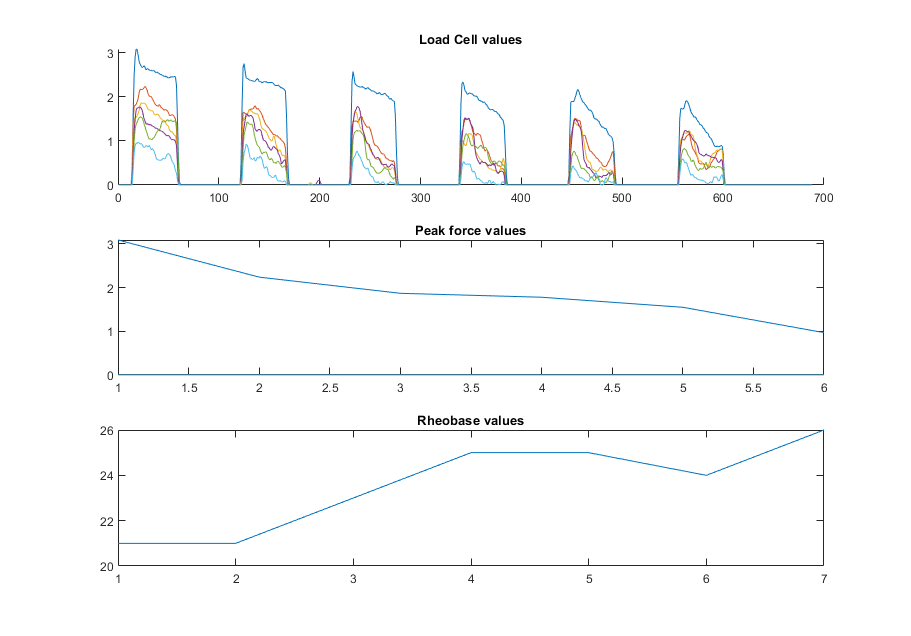
Interfaces Python/teste total/piera der/2/data of left leg.png
