lara-unb/Estimulema/Interfaces Python/teste total/piera der/2/pierna izq.png

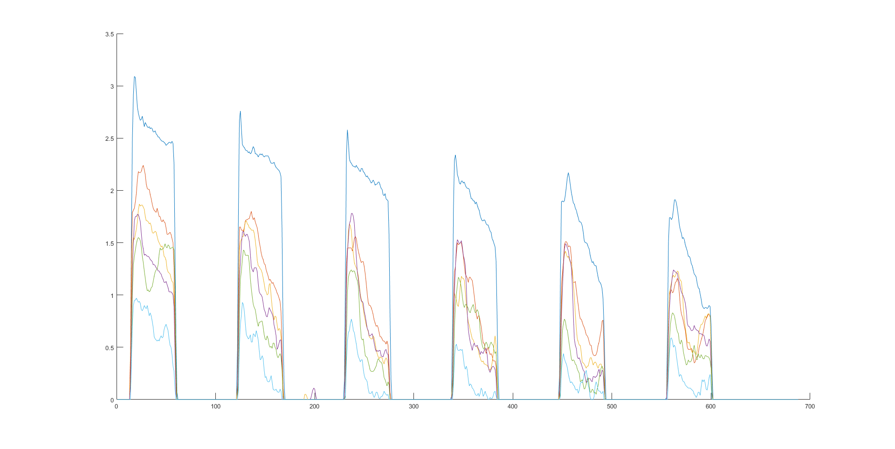
Interfaces Python/teste total/piera der/2/pierna izq.png
