lara-unb/Estimulema/Teste de Desempeño/Dualpex 071 performance test/T0000.PNG

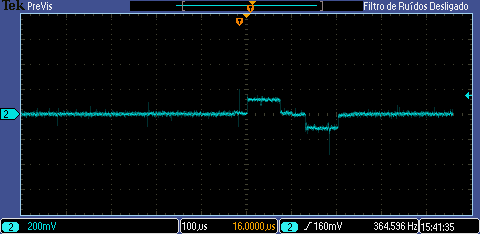
Teste de Desempeño/Dualpex 071 performance test/T0000.PNG
