lara-unb/Estimulema/Teste de Desempeño/Dualpex 071 performance test/T0001.PNG

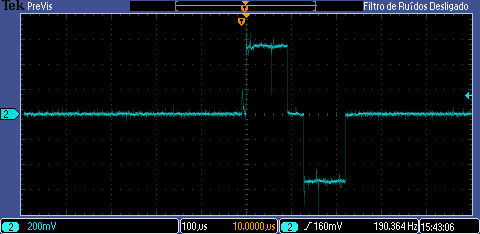
Teste de Desempeño/Dualpex 071 performance test/T0001.PNG
