lara-unb/Estimulema/Teste de Desempeño/Dualpex 071 performance test/T0019.PNG

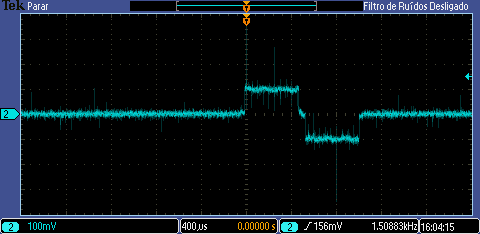
Teste de Desempeño/Dualpex 071 performance test/T0019.PNG
