lara-unb/Estimulema/Teste de Desempeño/Dualpex 071 performance test/T0031.PNG

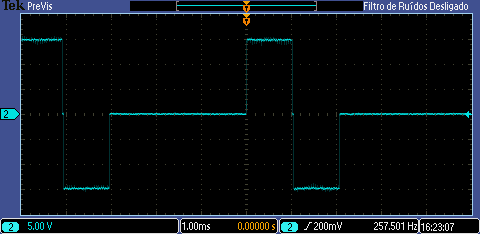
Teste de Desempeño/Dualpex 071 performance test/T0031.PNG
