lara-unb/Estimulema/Teste de Desempeño/Dualpex 071 performance test/T0034.PNG

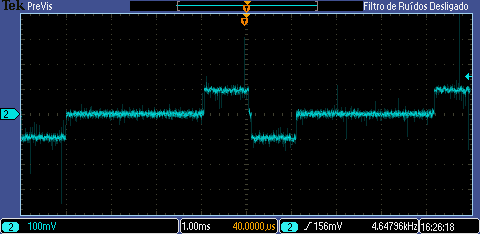
Teste de Desempeño/Dualpex 071 performance test/T0034.PNG
