lara-unb/Estimulema/Teste de Desempeño/Dualpex 071 performance test/T0036.PNG

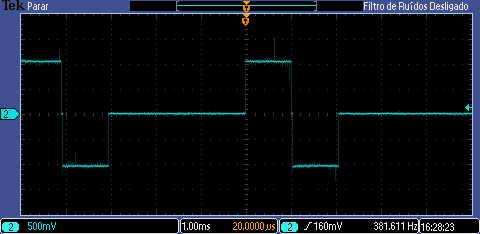
Teste de Desempeño/Dualpex 071 performance test/T0036.PNG
