lara-unb/Estimulema/Teste de Desempeño/GENESY1500/T0000.PNG

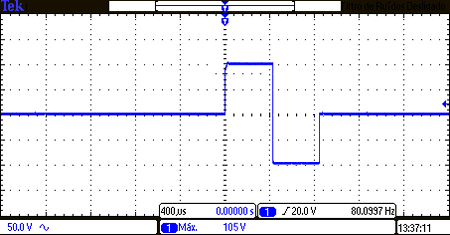
Teste de Desempeño/GENESY1500/T0000.PNG
