lara-unb/Estimulema/Teste de Desempeño/HTM/T0000.PNG

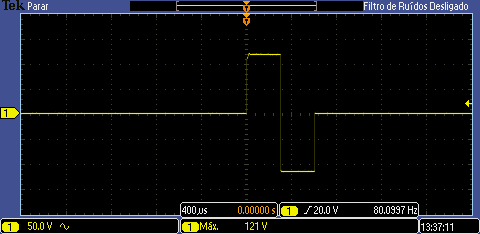
Teste de Desempeño/HTM/T0000.PNG
