lara-unb/Estimulema/Teste de Desempeño/HTM/T0001.PNG

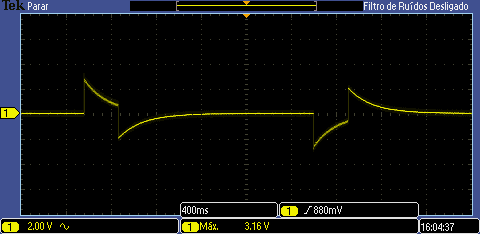
Teste de Desempeño/HTM/T0001.PNG
