lara-unb/Estimulema/Teste de Desempeño/HTM/T0002.PNG

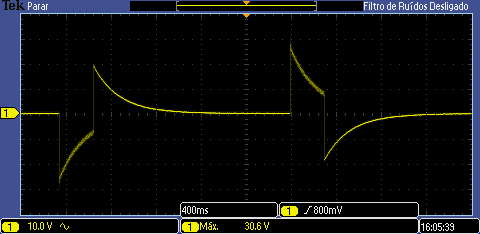
Teste de Desempeño/HTM/T0002.PNG
