lara-unb/Estimulema/Teste de Desempeño/HTM/T0003.PNG

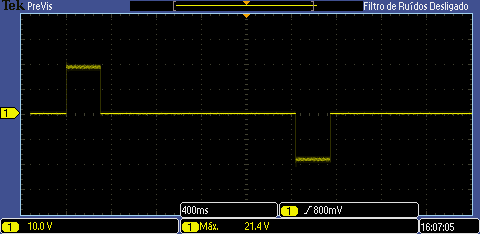
Teste de Desempeño/HTM/T0003.PNG
