lara-unb/Estimulema/Teste de Desempeño/HTM/T0004.PNG

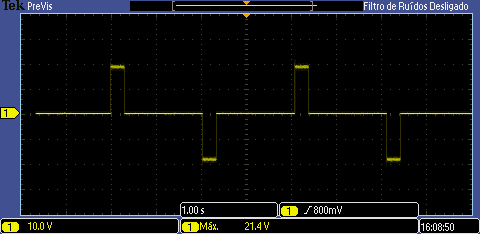
Teste de Desempeño/HTM/T0004.PNG
