lara-unb/Estimulema/Teste de Desempeño/HTM/T0005.PNG

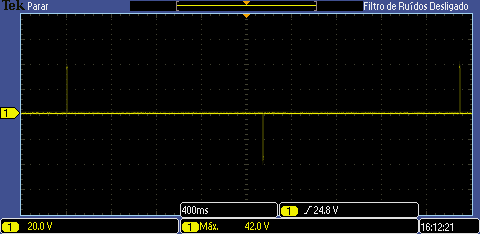
Teste de Desempeño/HTM/T0005.PNG
