lara-unb/Estimulema/Teste de Desempeño/Imagenes osciloscopio/T0000.PNG

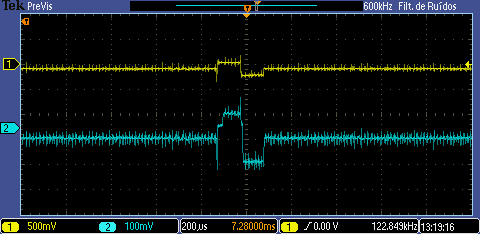
Teste de Desempeño/Imagenes osciloscopio/T0000.PNG
