lara-unb/Estimulema/Teste de Desempeño/Imagenes osciloscopio/T0001.PNG

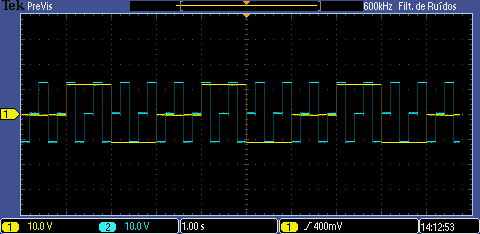
Teste de Desempeño/Imagenes osciloscopio/T0001.PNG
