lara-unb/Estimulema/Teste de Desempeño/Imagenes osciloscopio/TEK00000.PNG

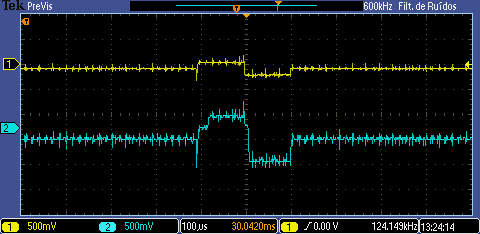
Teste de Desempeño/Imagenes osciloscopio/TEK00000.PNG
