lara-unb/Estimulema/Teste de Desempeño/Imagenes osciloscopio/TEK00001.PNG

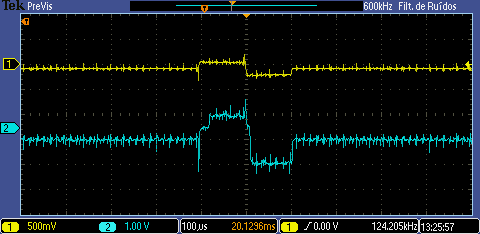
Teste de Desempeño/Imagenes osciloscopio/TEK00001.PNG
