lara-unb/Estimulema/Teste de Desempeño/Imagenes osciloscopio/TEK00002.PNG

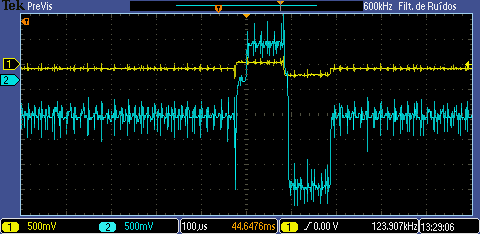
Teste de Desempeño/Imagenes osciloscopio/TEK00002.PNG
