lara-unb/Estimulema/Teste de Desempeño/Imagenes osciloscopio/TEK00003.PNG

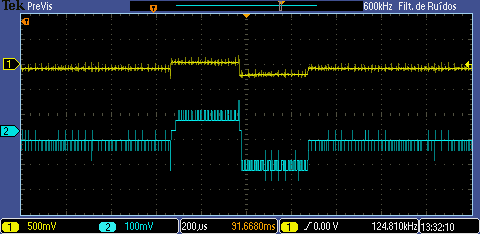
Teste de Desempeño/Imagenes osciloscopio/TEK00003.PNG
