lara-unb/Estimulema/Teste de Desempeño/Imagenes osciloscopio/TEK00004.PNG

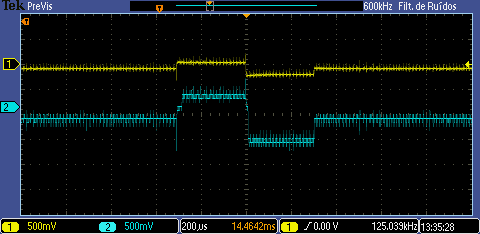
Teste de Desempeño/Imagenes osciloscopio/TEK00004.PNG
