lara-unb/Estimulema/Teste de Desempeño/Imagenes osciloscopio/TEK00005.PNG

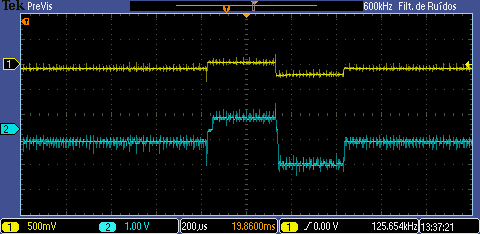
Teste de Desempeño/Imagenes osciloscopio/TEK00005.PNG
