lara-unb/Estimulema/Teste de Desempeño/Imagenes osciloscopio/TEK00006.PNG

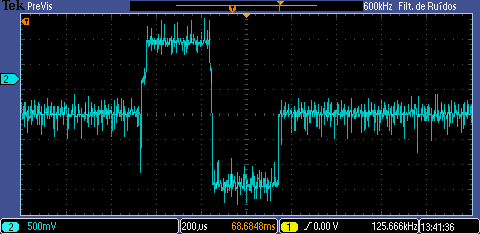
Teste de Desempeño/Imagenes osciloscopio/TEK00006.PNG
