lara-unb/Estimulema/Teste de Desempeño/Imagenes osciloscopio/TEK00007.PNG

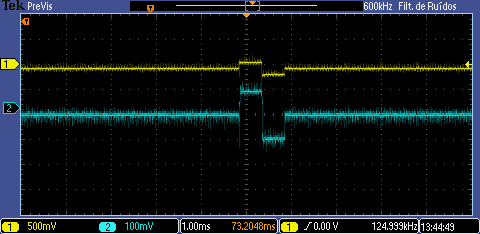
Teste de Desempeño/Imagenes osciloscopio/TEK00007.PNG
