lara-unb/Estimulema/Teste de Desempeño/Imagenes osciloscopio/TEK00008.PNG

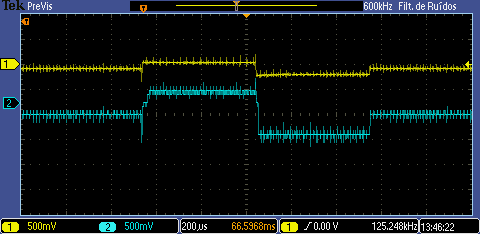
Teste de Desempeño/Imagenes osciloscopio/TEK00008.PNG
