lara-unb/Estimulema/Teste de Desempeño/Imagenes osciloscopio/TEK00009.PNG

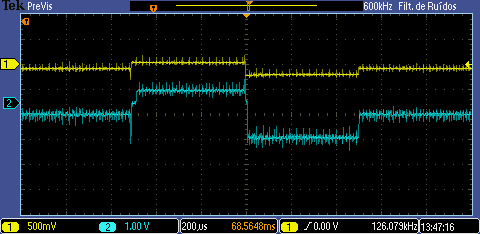
Teste de Desempeño/Imagenes osciloscopio/TEK00009.PNG
