lara-unb/Estimulema/Teste de Desempeño/Imagenes osciloscopio/TEK00010.PNG

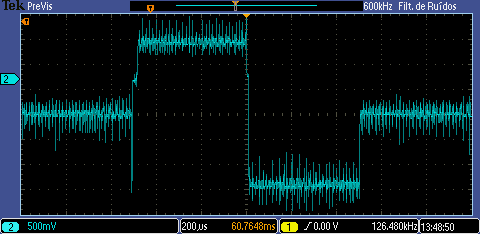
Teste de Desempeño/Imagenes osciloscopio/TEK00010.PNG
