lara-unb/Estimulema/Teste de Desempeño/Imagenes osciloscopio/TEK00011.PNG

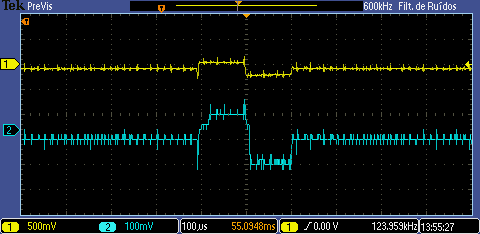
Teste de Desempeño/Imagenes osciloscopio/TEK00011.PNG
