lara-unb/Estimulema/Teste de Desempeño/Imagenes osciloscopio/TEK00013.PNG

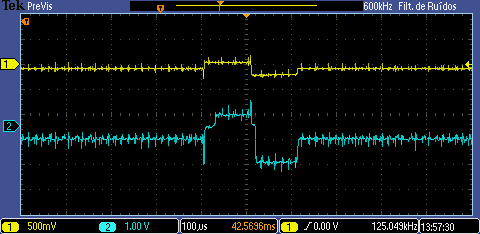
Teste de Desempeño/Imagenes osciloscopio/TEK00013.PNG
