lara-unb/Estimulema/Teste de Desempeño/Imagenes osciloscopio/TEK00014.PNG

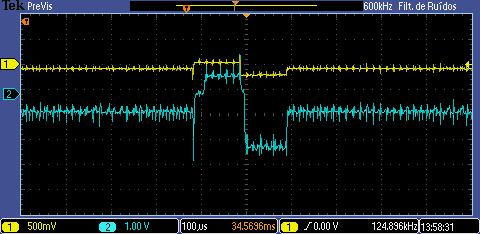
Teste de Desempeño/Imagenes osciloscopio/TEK00014.PNG
