lara-unb/Estimulema/Teste de Desempeño/Imagenes osciloscopio/TEK00015.PNG

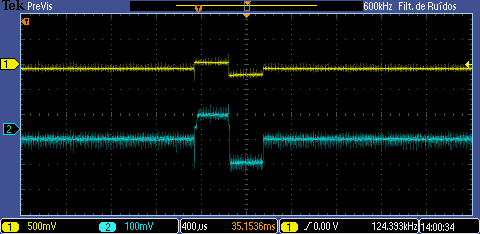
Teste de Desempeño/Imagenes osciloscopio/TEK00015.PNG
