lara-unb/Estimulema/Teste de Desempeño/Imagenes osciloscopio/TEK00016.PNG

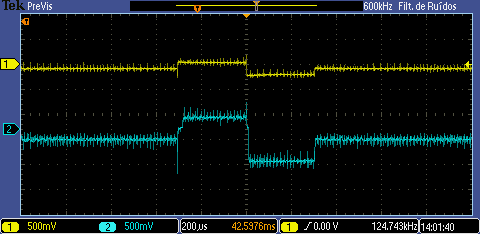
Teste de Desempeño/Imagenes osciloscopio/TEK00016.PNG
