lara-unb/Estimulema/Teste de Desempeño/Imagenes osciloscopio/TEK00017.PNG

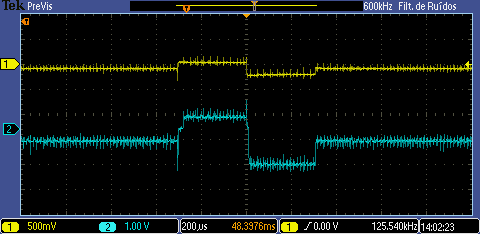
Teste de Desempeño/Imagenes osciloscopio/TEK00017.PNG
