lara-unb/Estimulema/Teste de Desempeño/Imagenes osciloscopio/TEK00018.PNG

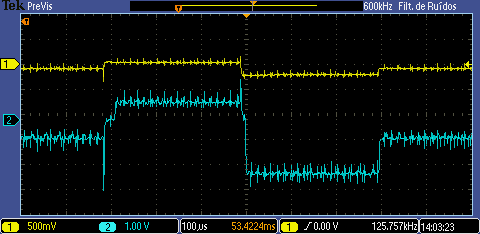
Teste de Desempeño/Imagenes osciloscopio/TEK00018.PNG
