lara-unb/Estimulema/Teste de Desempeño/Imagenes osciloscopio/TEK00019.PNG

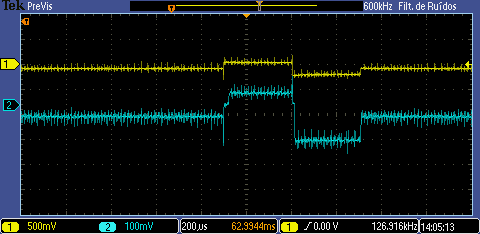
Teste de Desempeño/Imagenes osciloscopio/TEK00019.PNG
