lara-unb/Estimulema/Teste de Desempeño/Imagenes osciloscopio/TEK00023.PNG

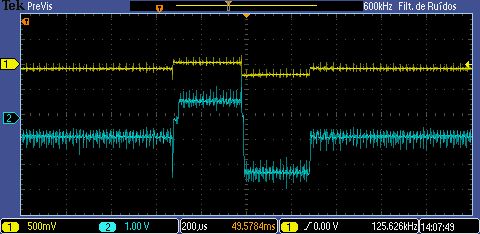
Teste de Desempeño/Imagenes osciloscopio/TEK00023.PNG
