lara-unb/Estimulema/Teste de Desempeño/Imagenes osciloscopio/TEK00025.PNG

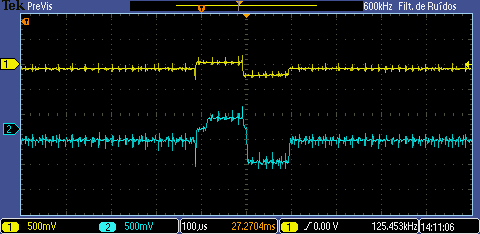
Teste de Desempeño/Imagenes osciloscopio/TEK00025.PNG
