lara-unb/Estimulema/Teste de Desempeño/Imagenes osciloscopio/TEK00026.PNG

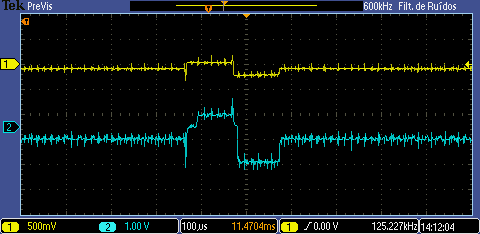
Teste de Desempeño/Imagenes osciloscopio/TEK00026.PNG
