lara-unb/Estimulema/Teste de Desempeño/Imagenes osciloscopio/TEK00028.PNG

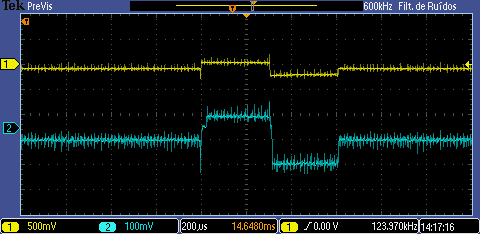
Teste de Desempeño/Imagenes osciloscopio/TEK00028.PNG
