lara-unb/Estimulema/Teste de Desempeño/Imagenes osciloscopio/TEK00029.PNG

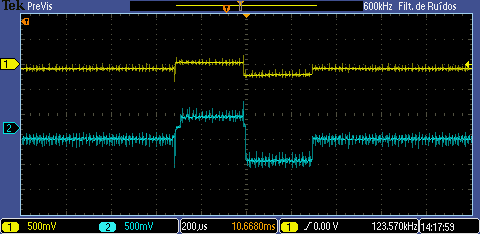
Teste de Desempeño/Imagenes osciloscopio/TEK00029.PNG
