lara-unb/Estimulema/Teste de Desempeño/Imagenes osciloscopio/TEK00031.PNG

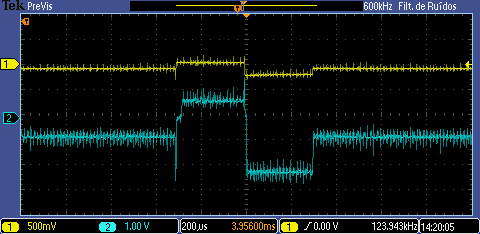
Teste de Desempeño/Imagenes osciloscopio/TEK00031.PNG
