lara-unb/Estimulema/Teste de Desempeño/Imagenes osciloscopio/TEK00032.PNG

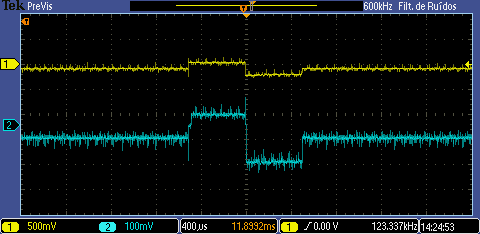
Teste de Desempeño/Imagenes osciloscopio/TEK00032.PNG
