lara-unb/Estimulema/Teste de Desempeño/Imagenes osciloscopio/TEK00033.PNG

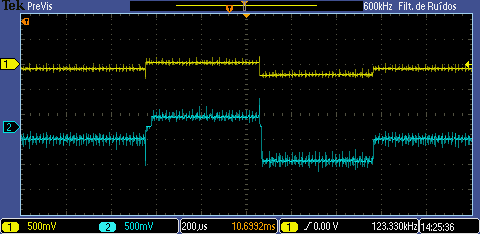
Teste de Desempeño/Imagenes osciloscopio/TEK00033.PNG
