lara-unb/Estimulema/Teste de Desempeño/Imagenes osciloscopio/TEK00035.PNG

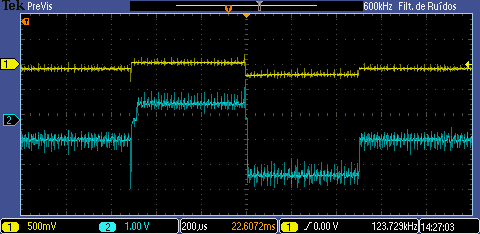
Teste de Desempeño/Imagenes osciloscopio/TEK00035.PNG
