lara-unb/Estimulema/Teste de Desempeño/Imagenes osciloscopio/TEK00037.PNG

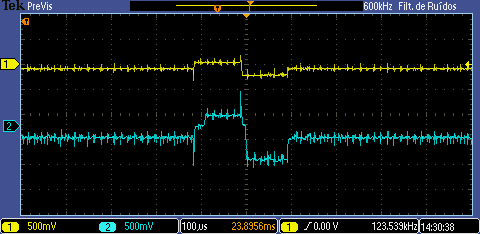
Teste de Desempeño/Imagenes osciloscopio/TEK00037.PNG
