lara-unb/Estimulema/Teste de Desempeño/Imagenes osciloscopio/TEK00045.PNG

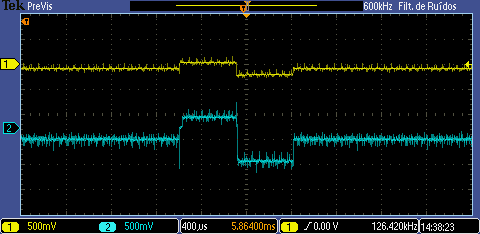
Teste de Desempeño/Imagenes osciloscopio/TEK00045.PNG
