lara-unb/Estimulema/Teste de Desempeño/Imagenes osciloscopio/TEK00046.PNG

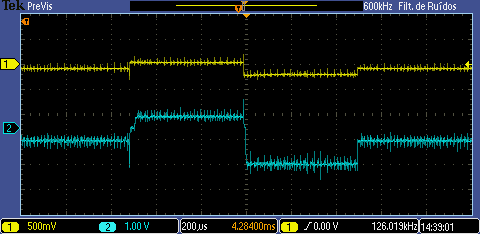
Teste de Desempeño/Imagenes osciloscopio/TEK00046.PNG
