lara-unb/Estimulema/Teste de Desempeño/Imagenes osciloscopio/TEK00047.PNG

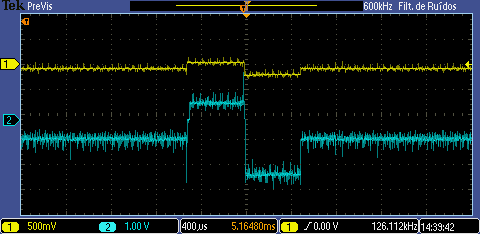
Teste de Desempeño/Imagenes osciloscopio/TEK00047.PNG
