lara-unb/Estimulema/Tesis Doc Miguel Gutierrez/figs/Fig_c2/fon_f5.pdf

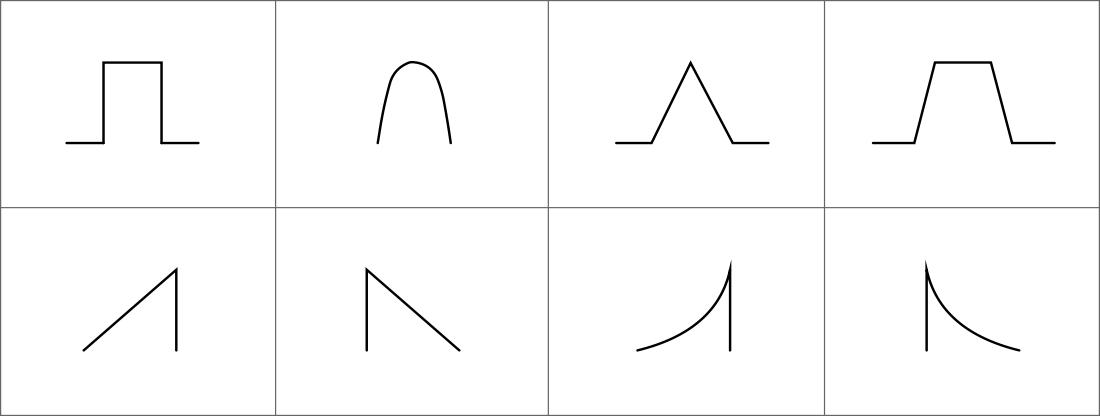
[picture p153: page 2]
