lara-unb/Estimulema/Tesis Doc Miguel Gutierrez/figs/Fig_c3/chg_f9.pdf

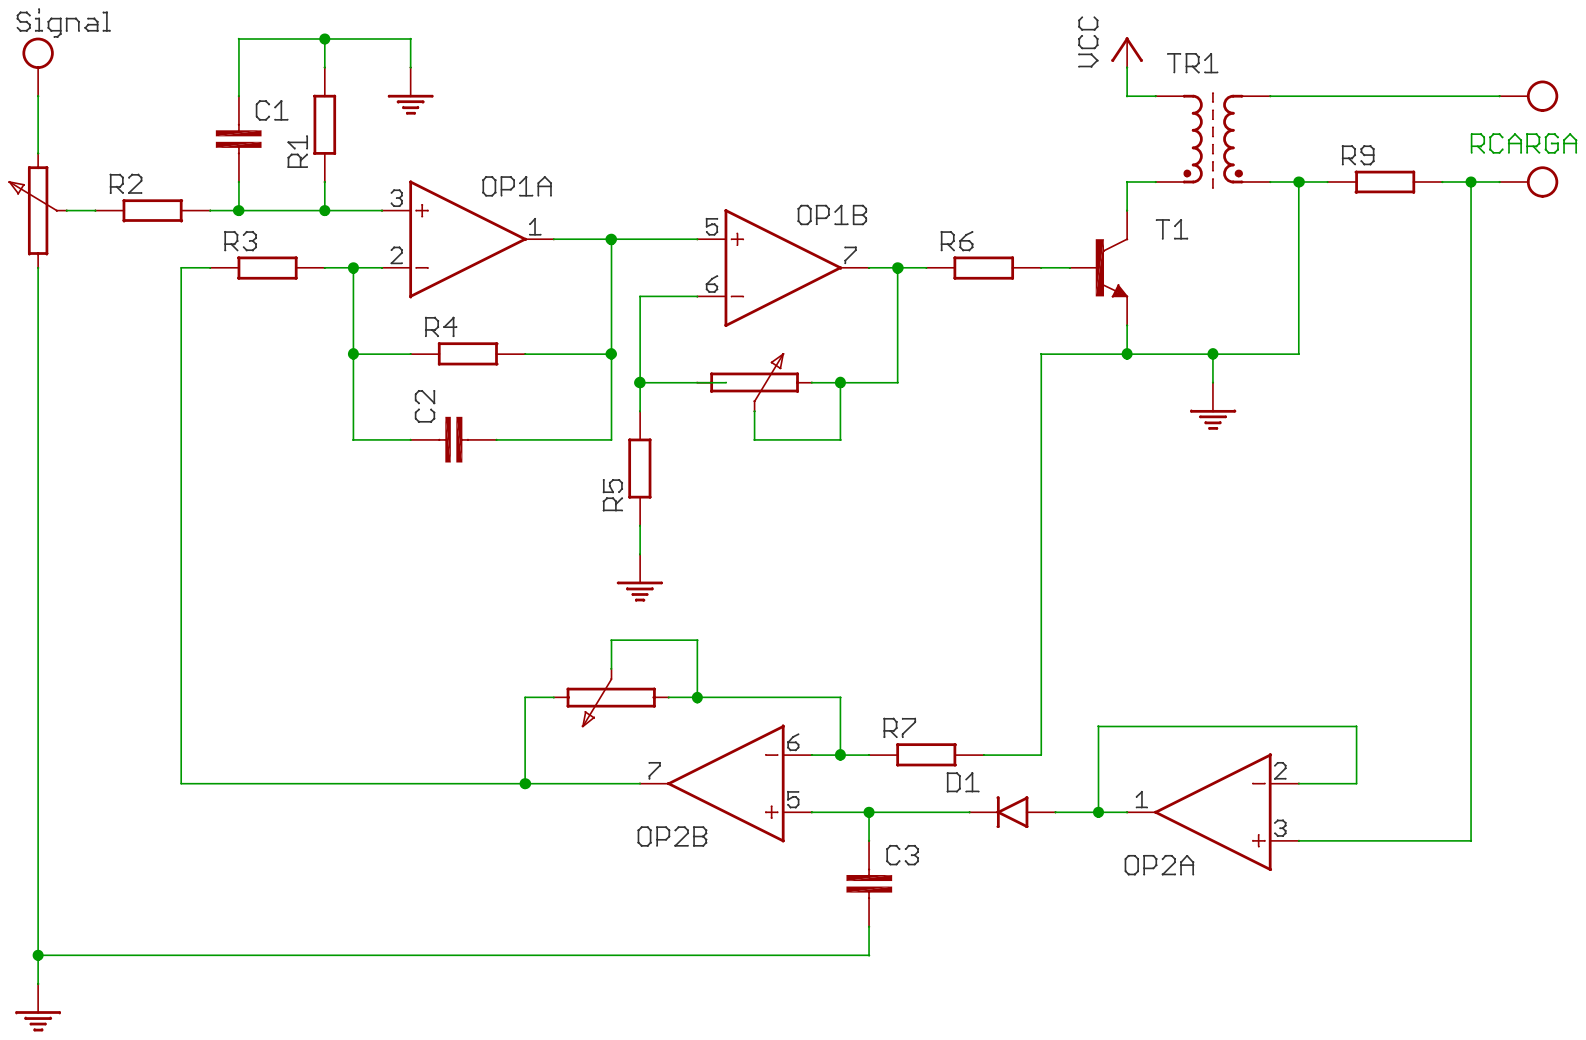
[picture p154: page 1]
