lara-unb/Estimulema/Tesis Doc Miguel Gutierrez/figs/Fig_c4/c4_f24_pci.pdf

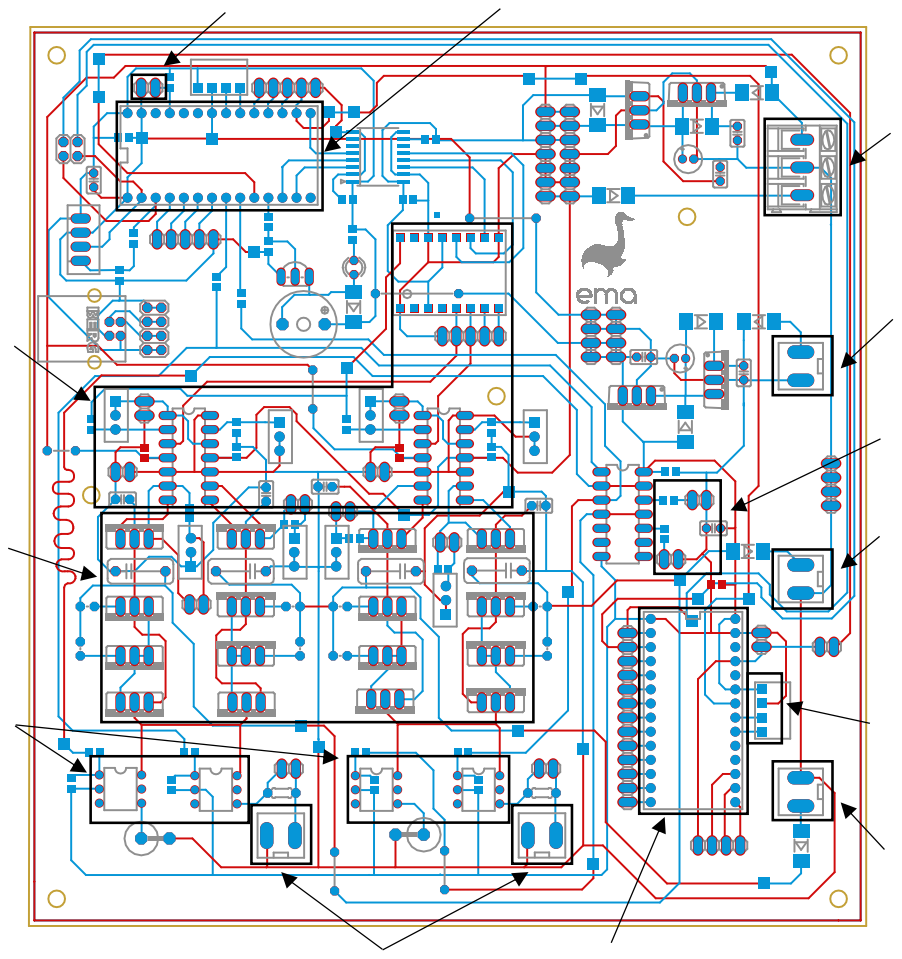
[picture p155: page 1]
