lara-unb/Estimulema/Tesis Doc Miguel Gutierrez/figs/Fig_c4/c4_f25_dct.pdf

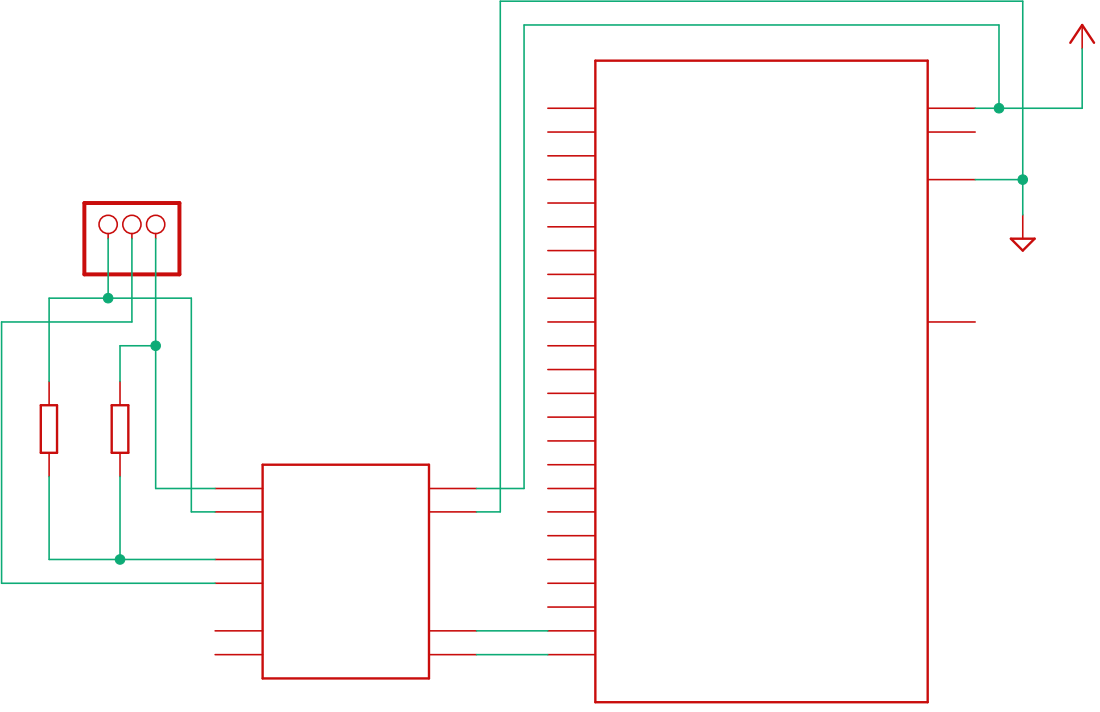
[picture p156: page 2]
