lara-unb/Estimulema/(list of files, drawings)

Other design files:
estimulemaINO/new while/new_while.pdsprj
EstimulemaPCB/Medir corriente/senales/filtro.pdsprj
