lara-unb/Estimulema/EstimulemaPCB/Estimulema v2.brd

## EAGLE design EstimulemaPCB/Estimulema v2.brd (2019-04-16)

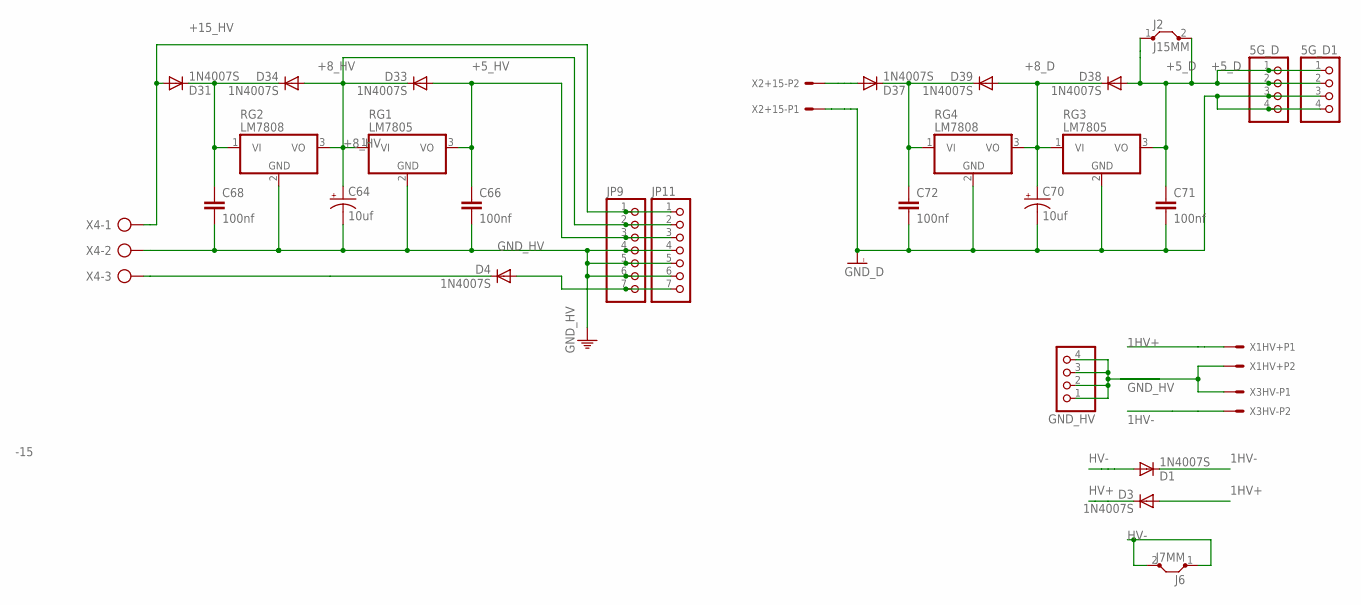
[picture p157: schematic Estimulema v2.sch, sheet 1]

Parts:
5G_D, 5G_D1: PINHD-1X4; 1X04
C64, C70: 10uf; E2-5
C66, C68, C71, C72: 100nf; C025-025X050
D1, D3, D4, D31, D33, D34, D37, D38, D39: 1N4007S; RESM4226X229
GND_HV: PINHD-1X4; 1X04
J2: J15MM; 15
J6: J7MM; 07
JP9, JP11: PINHD-1X7; 1X07
RG1, RG3: LM7805; TO220V
RG2, RG4: LM7808; TO220V
X1HV+, X2+15-, X3HV-: CONECTOR_5.08; CONECTOR_X2_5.08
X4: AK300/3

Connections:
1HV+: D3.AN (A), X1HV+.1
1HV-: D1.CA (C), X3HV-.2
+5_D: 5G_D.1, 5G_D.2, 5G_D1.1, 5G_D1.2, C71.1, D38.AN (A), J2.1, J2.2, RG3.3 (VO); also elsewhere on the board
+5_HV: C66.1, D33.AN (A), JP9.3, JP11.3, RG1.3 (VO); also elsewhere on the board
+8_D: C70.+, D38.CA (C), D39.AN (A), RG3.1 (VI), RG4.3 (VO)
+8_HV: C64.+, D33.CA (C), D34.AN (A), JP9.2, JP11.2, RG1.1 (VI), RG2.3 (VO)
+15_HV: D31.AN (A), JP9.1, JP11.1, X4.1; also elsewhere on the board
-15: D4.CA (C), X4.3
-15_HV: D4.AN (A), JP9.7, JP11.7; also elsewhere on the board
GND_D: 5G_D.3, 5G_D.4, 5G_D1.3, 5G_D1.4, C70.-, C71.2, C72.2, RG3.2 (GND), RG4.2 (GND), X2+15-.1; also elsewhere on the board
GND_HV: C64.-, C66.2, C68.2, GND_HV.1, GND_HV.2, GND_HV.3, GND_HV.4, JP9.4, JP9.5, JP9.6, JP11.4, JP11.5, JP11.6, RG1.2 (GND), RG2.2 (GND), X1HV+.2, X3HV-.1, X4.2; also elsewhere on the board
HV+: D3.CA (C); also elsewhere on the board
HV-: D1.AN (A), J6.1, J6.2; also elsewhere on the board
unnamed: D37.AN (A), X2+15-.2
unnamed: C68.1, D31.CA (C), D34.CA (C), RG2.1 (VI)
unnamed: C72.1, D37.CA (C), D39.CA (C), RG4.1 (VI)

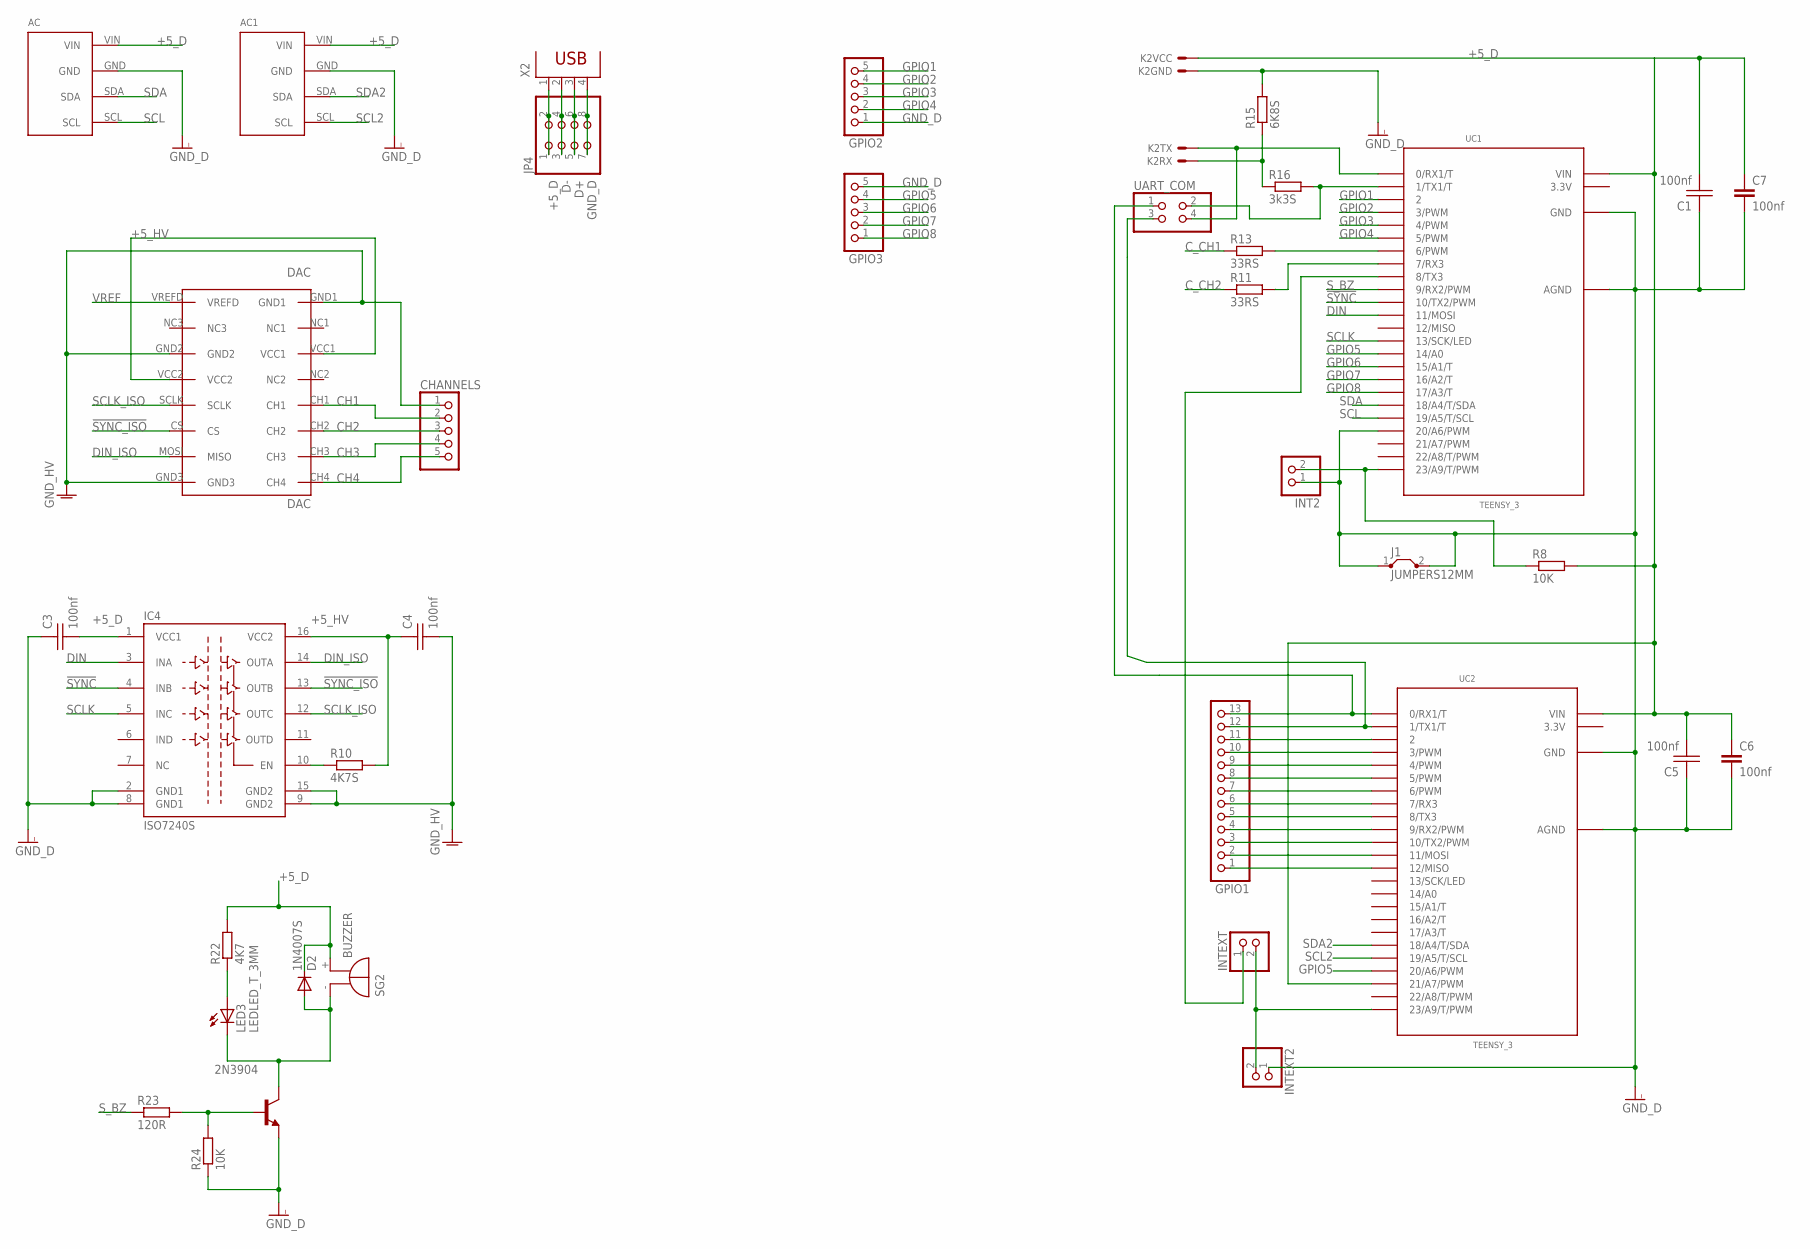
[picture p158: schematic Estimulema v2.sch, sheet 2]

Parts:
2N3904: 29-NPN-TO92-EBC; TO92-EBC
AC: CONECTOR_ACELEROMETRO_MPU6050CONECTOR_MPU6050; MPU6050
AC1: MPU6050
C1, C3, C4, C5: 100nf; CAP_CER_SMD-0805
C6, C7: 100nf; C025-025X050
CHANNELS: PINHD-1X5; 1X05
D2: 1N4007S; RESM4226X229
DAC: DAC; DACMOD_P
GPIO1: PINHD-1X13; 1X13
GPIO2, GPIO3: PINHD-1X5; 1X05
IC4: ISO7240S; SO-16DW
INT2: PINHD-1X2; 1X02
INTEXT, INTEXT2: PINHD-1X2; 1X02
J1: JUMPERS12MM; 12
JP4: PINHD-2X4; 2X04
K2: HC-06; CONECTOR_BTHC-06
LED3: LEDLED_T_3MM; LED3MM
R8, R24: 10K; RESISTENCIA_0805
R10: 4K7S; RESISTENCIA_0805
R11, R13: 33RS; RESISTENCIA_0805
R15: 6K8S; RESISTENCIA_0805
R16: 3k3S; RESISTENCIA_0805
R22: 4K7; RESISTENCIA_0805
R23: 120R; RESISTENCIA_0805
SG2: BUZZER
UART_COM: PINHD-2X2; 2X02
UC1, UC2: TEENSY_3; TEENSY_3.0-3.2_DIL
X2: PN61729

Connections:
3.3V: UC1.3.3V, UC2.3.3V
!SYNC: IC4.4 (INB), UC1.10 (10/TX2/PWM)
!SYNC_ISO: DAC.CS, IC4.13 (OUTB)
+5_D: AC.VIN, AC1.VIN, C1.2, C3.2, C5.2, C6.1, C7.1, D2.CA (C), IC4.1 (VCC1), JP4.1, JP4.2, K2.1, R8.2, R22.2, SG2.+ (-), UC1.VIN, UC2.21/A7 (21/A7/PWM), UC2.VIN, X2.1; also elsewhere on the board
+5_HV: C4.1, DAC.VCC1, DAC.VCC2, IC4.16 (VCC2), R10.2; also elsewhere on the board
CH1: CHANNELS.2, DAC.CH1; also elsewhere on the board
CH2: CHANNELS.3, DAC.CH2; also elsewhere on the board
CH3: CHANNELS.4, DAC.CH3
CH4: CHANNELS.5, DAC.CH4
C_15D: GPIO1.11, UC2.2
C_CH1: R13.1; also elsewhere on the board
C_CH2: R11.1; also elsewhere on the board
D+: JP4.5, JP4.6, X2.3
D-: JP4.3, JP4.4, X2.2
DIN: IC4.3 (INA), UC1.11 (11/MOSI)
DIN_ISO: DAC.MOSI (MISO), IC4.14 (OUTA)
GNDI: C3.1, IC4.2 (GND1), IC4.8 (GND1)
GND_D: 2N3904.E, AC.GND, AC1.GND, C1.1, C5.1, C6.2, C7.2, GPIO2.1, GPIO3.5, INT2.1, INTEXT2.1, J1.1, J1.2, JP4.7, JP4.8, K2.2, R15.2, R24.1, UC1.20/A6 (20/A6/PWM), UC1.AGND, UC1.GND, UC2.AGND, UC2.GND, X2.4; also elsewhere on the board
GND_HV: C4.2, CHANNELS.1, DAC.GND1, DAC.GND2, DAC.GND3, IC4.9 (GND2), IC4.15 (GND2); also elsewhere on the board
GPIO1: GPIO2.5, UC1.2
GPIO2: GPIO2.4, UC1.3 (3/PWM)
GPIO3: GPIO2.3, UC1.4 (4/PWM)
GPIO4: GPIO2.2, UC1.5 (5/PWM)
GPIO5: GPIO3.4, UC1.14/A0, UC2.20/A6 (20/A6/PWM)
GPIO6: GPIO3.3, UC1.15/A1 (15/A1/T)
GPIO7: GPIO3.2, UC1.16/A2 (16/A2/T)
GPIO8: GPIO3.1, UC1.17/A3 (17/A3/T)
unnamed: INTEXT.2, INTEXT2.2, UC2.23/A9 (23/A9/T/PWM)
unnamed: INTEXT.1, UC1.8 (8/TX3)
unnamed: GPIO1.13, UART_COM.1, UC2.0 (0/RX1/T)
unnamed: GPIO1.12, UART_COM.3, UC2.1 (1/TX1/T)
unnamed: GPIO1.10, UC2.3 (3/PWM)
unnamed: GPIO1.9, UC2.4 (4/PWM)
unnamed: GPIO1.8, UC2.5 (5/PWM)
unnamed: GPIO1.7, UC2.6 (6/PWM)
unnamed: GPIO1.6, UC2.7 (7/RX3)
unnamed: GPIO1.5, UC2.8 (8/TX3)
unnamed: GPIO1.4, UC2.9 (9/RX2/PWM)
unnamed: GPIO1.3, UC2.10 (10/TX2/PWM)
unnamed: GPIO1.2, UC2.11 (11/MOSI)
unnamed: GPIO1.1, UC2.12 (12/MISO)
unnamed: R16.2, UART_COM.2, UC1.1 (1/TX1/T)
unnamed: K2.3, UART_COM.4, UC1.0 (0/RX1/T)
unnamed: IC4.10 (EN), R10.1
unnamed: R13.2, UC1.6 (6/PWM)
unnamed: R11.2, UC1.7 (7/RX3)
unnamed: K2.4, R15.1, R16.1
unnamed: LED3.A, R22.1
unnamed: 2N3904.C, D2.AN (A), LED3.K (C), SG2.- (+)
unnamed: 2N3904.B, R23.2, R24.2
unnamed: INT2.2, R8.1, UC1.23/A9 (23/A9/T/PWM)
SCL: AC.SCL, UC1.19/A5 (19/A5/T/SCL)
SCL2: AC1.SCL, UC2.19/A5 (19/A5/T/SCL)
SCLK: IC4.5 (INC), UC1.13 (13/SCK/LED)
SCLK_ISO: DAC.SCLK, IC4.12 (OUTC)
SDA: AC.SDA, UC1.18/A4 (18/A4/T/SDA)
SDA2: AC1.SDA, UC2.18/A4 (18/A4/T/SDA)
S_BZ: R23.1, UC1.9 (9/RX2/PWM)
VREF: DAC.VREFD; also elsewhere on the board

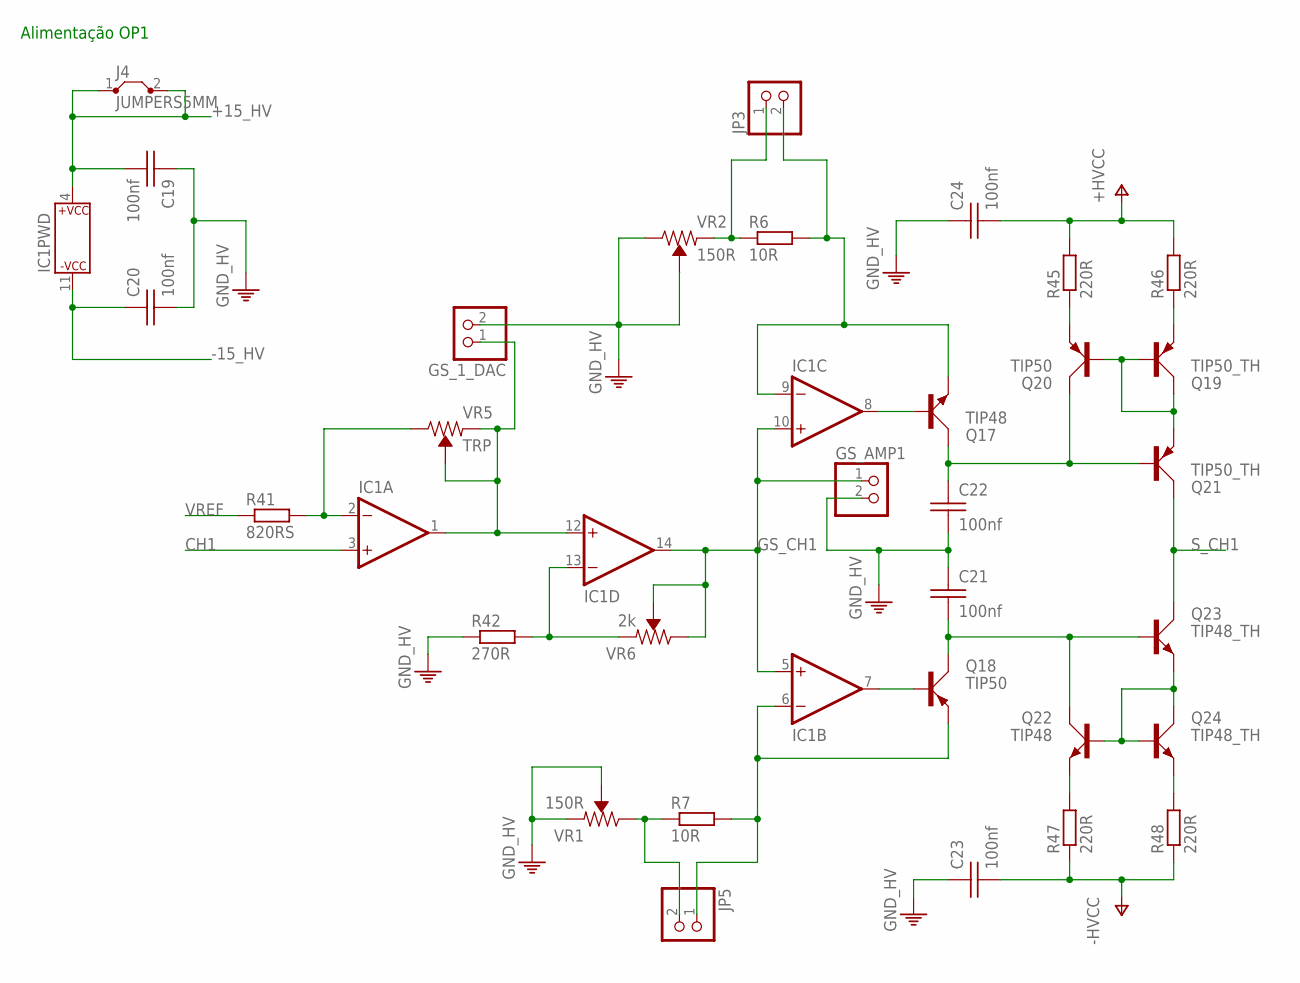
[picture p159: schematic Estimulema v2.sch, sheet 3]

Parts:
C19, C20: 100nf; CAP_CER_SMD-0805
C21, C22: 100nf; CAP_CER_2,54-5X5
C23, C24: 100nf; CAP_CER_16X7
GS_1_DAC: PINHD-1X2; 1X02
GS_AMP1: PINHD-1X2; 1X02
IC1: TL084DIL143D; DIL14
J4: JUMPERS5MM; 05
JP3, JP5: PINHD-1X2; 1X02
Q17, Q22: TIP48; TO220
Q18, Q20: TIP50; TO220
Q19, Q21: TIP50_TH; TO220
Q23, Q24: TIP48_TH; TO220
R6, R7: 10R; RESISTENCIA_0805
R41: 820RS; RESISTENCIA_0805
R42: 270R; RESISTENCIA_0805
R45, R46, R47, R48: 220R; 0204V
VR1, VR2: 150R; TRIMPOT-PTH-3386U
VR5: TRP; TRIMPOT-PTH-3386U
VR6: 2k; TRIMPOT-PTH-3386U

Connections:
+15_HV: C19.2, IC1.4 (P$V+), J4.1, J4.2; also elsewhere on the board
-15_HV: C20.1, IC1.11 (P$V-); also elsewhere on the board
CH1: IC1.3 (+IN); also elsewhere on the board
GND_HV: C19.1, C20.2, C21.1, C22.2, C23.1, C24.1, GS_1_DAC.2, GS_AMP1.2, R42.1, VR1.1 (CCW), VR1.2 (WIPER), VR2.2 (WIPER), VR2.3 (CW); also elsewhere on the board
GS_CH1: GS_AMP1.1, IC1.5 (+IN), IC1.10 (+IN), IC1.14 (OUT), VR6.2 (WIPER), VR6.3 (CW)
HV+: C24.2, R45.2, R46.2; also elsewhere on the board
HV-: C23.2, R47.1, R48.1; also elsewhere on the board
unnamed: JP5.2, R7.1, VR1.3 (CW)
unnamed: JP3.1, R6.1, VR2.1 (CCW)
unnamed: IC1.2 (-IN), R41.2, VR5.3 (CW)
unnamed: GS_1_DAC.1, IC1.1 (OUT), IC1.12 (+IN), VR5.1 (CCW), VR5.2 (WIPER)
unnamed: IC1.13 (-IN), R42.2, VR6.1 (CCW)
unnamed: IC1.9 (-IN), JP3.2, Q17.E, R6.2
unnamed: IC1.6 (-IN), JP5.1, Q18.E, R7.2
unnamed: C21.2, Q18.C, Q22.C, Q23.B
unnamed: C22.1, Q17.C, Q20.C, Q21.B
unnamed: Q20.E, R45.1
unnamed: Q19.E, R46.1
unnamed: Q19.B, Q19.C, Q20.B, Q21.E
unnamed: Q22.B, Q23.E, Q24.B, Q24.C
unnamed: Q22.E, R47.2
unnamed: Q24.E, R48.2
unnamed: IC1.8 (OUT), Q17.B
unnamed: IC1.7 (OUT), Q18.B
S_CH1: Q21.C, Q23.C; also elsewhere on the board
VREF: R41.1; also elsewhere on the board

Notes on the sheet:
Alimentação OP1

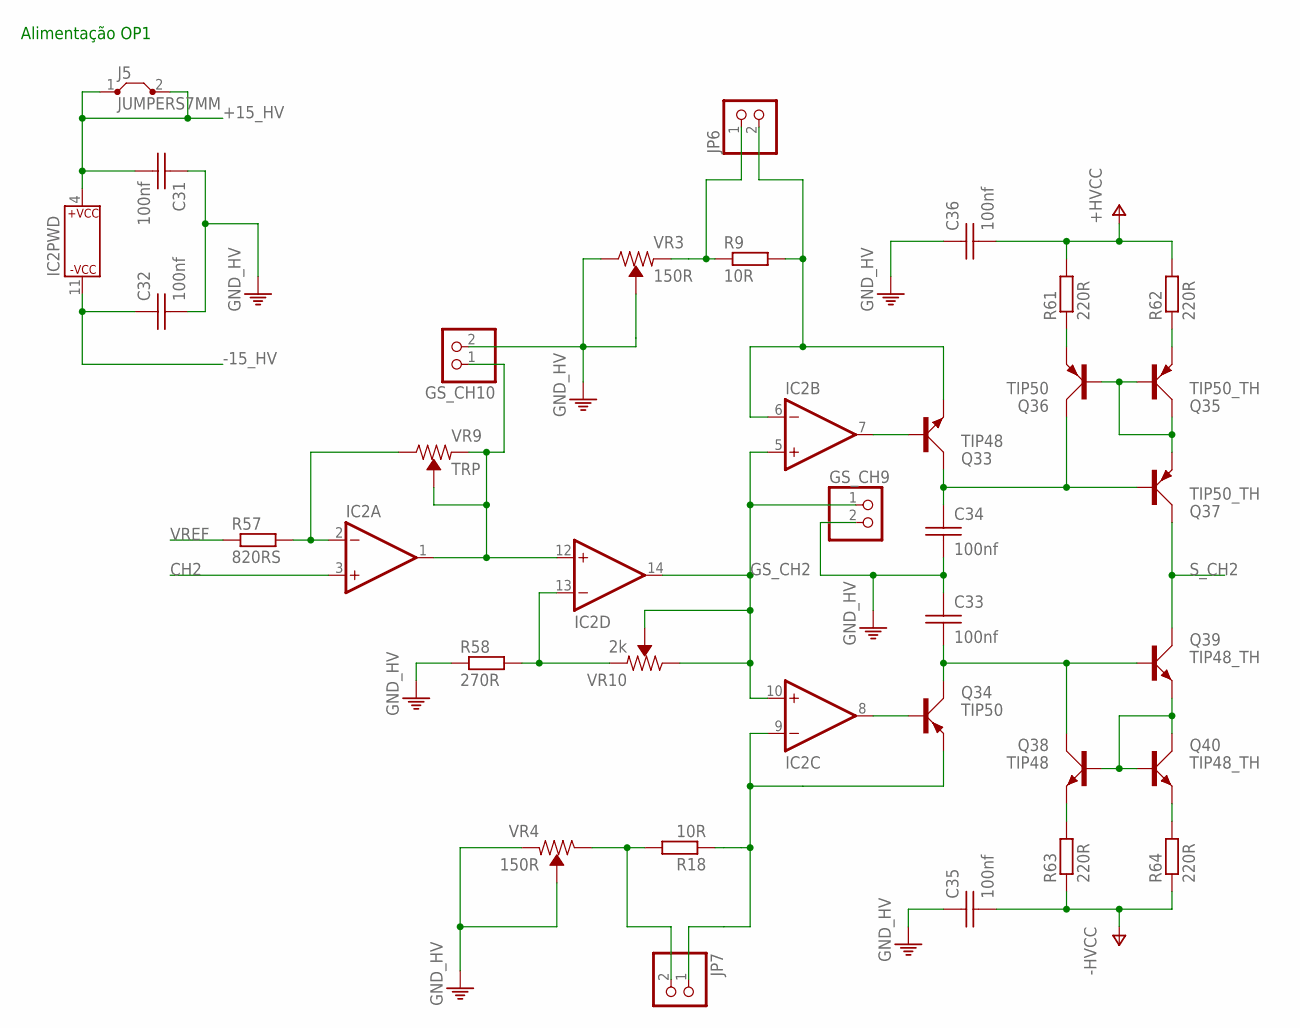
[picture p160: schematic Estimulema v2.sch, sheet 4]

Parts:
C31, C32: 100nf; CAP_CER_SMD-0805
C33, C34: 100nf; CAP_CER_2,54-5X5
C35, C36: 100nf; CAP_CER_16X7
GS_CH9, GS_CH10: PINHD-1X2; 1X02
IC2: TL084DIL143D; DIL14
J5: JUMPERS7MM; 07
JP6, JP7: PINHD-1X2; 1X02
Q33, Q38: TIP48; TO220
Q34, Q36: TIP50; TO220
Q35, Q37: TIP50_TH; TO220
Q39, Q40: TIP48_TH; TO220
R9, R18: 10R; RESISTENCIA_0805
R57: 820RS; RESISTENCIA_0805
R58: 270R; RESISTENCIA_0805
R61, R62, R63, R64: 220R; 0204V
VR3, VR4: 150R; TRIMPOT-PTH-3386U
VR9: TRP; TRIMPOT-PTH-3386U
VR10: 2k; TRIMPOT-PTH-3386U

Connections:
+15_HV: C31.2, IC2.4 (P$V+), J5.1, J5.2; also elsewhere on the board
-15_HV: C32.1, IC2.11 (P$V-); also elsewhere on the board
CH2: IC2.3 (+IN); also elsewhere on the board
GND_HV: C31.1, C32.2, C33.1, C34.2, C35.1, C36.1, GS_CH9.2, GS_CH10.2, R58.1, VR3.2 (WIPER), VR3.3 (CW), VR4.1 (CCW), VR4.2 (WIPER); also elsewhere on the board
GS_CH2: GS_CH9.1, IC2.5 (+IN), IC2.10 (+IN), IC2.14 (OUT), VR10.2 (WIPER), VR10.3 (CW)
HV+: C36.2, R61.2, R62.2; also elsewhere on the board
HV-: C35.2, R63.1, R64.1; also elsewhere on the board
unnamed: IC2.6 (-IN), JP6.2, Q33.E, R9.2
unnamed: JP6.1, R9.1, VR3.1 (CCW)
unnamed: JP7.2, R18.2, VR4.3 (CW)
unnamed: IC2.9 (-IN), JP7.1, Q34.E, R18.1
unnamed: IC2.2 (-IN), R57.2, VR9.3 (CW)
unnamed: GS_CH10.1, IC2.1 (OUT), IC2.12 (+IN), VR9.1 (CCW), VR9.2 (WIPER)
unnamed: IC2.13 (-IN), R58.2, VR10.1 (CCW)
unnamed: C33.2, Q34.C, Q38.C, Q39.B
unnamed: C34.1, Q33.C, Q36.C, Q37.B
unnamed: Q36.E, R61.1
unnamed: Q35.E, R62.1
unnamed: Q35.B, Q35.C, Q36.B, Q37.E
unnamed: Q38.B, Q39.E, Q40.B, Q40.C
unnamed: Q38.E, R63.2
unnamed: Q40.E, R64.2
unnamed: IC2.7 (OUT), Q33.B
unnamed: IC2.8 (OUT), Q34.B
S_CH2: Q37.C, Q39.C; also elsewhere on the board
VREF: R57.1; also elsewhere on the board

Notes on the sheet:
Alimentação OP1

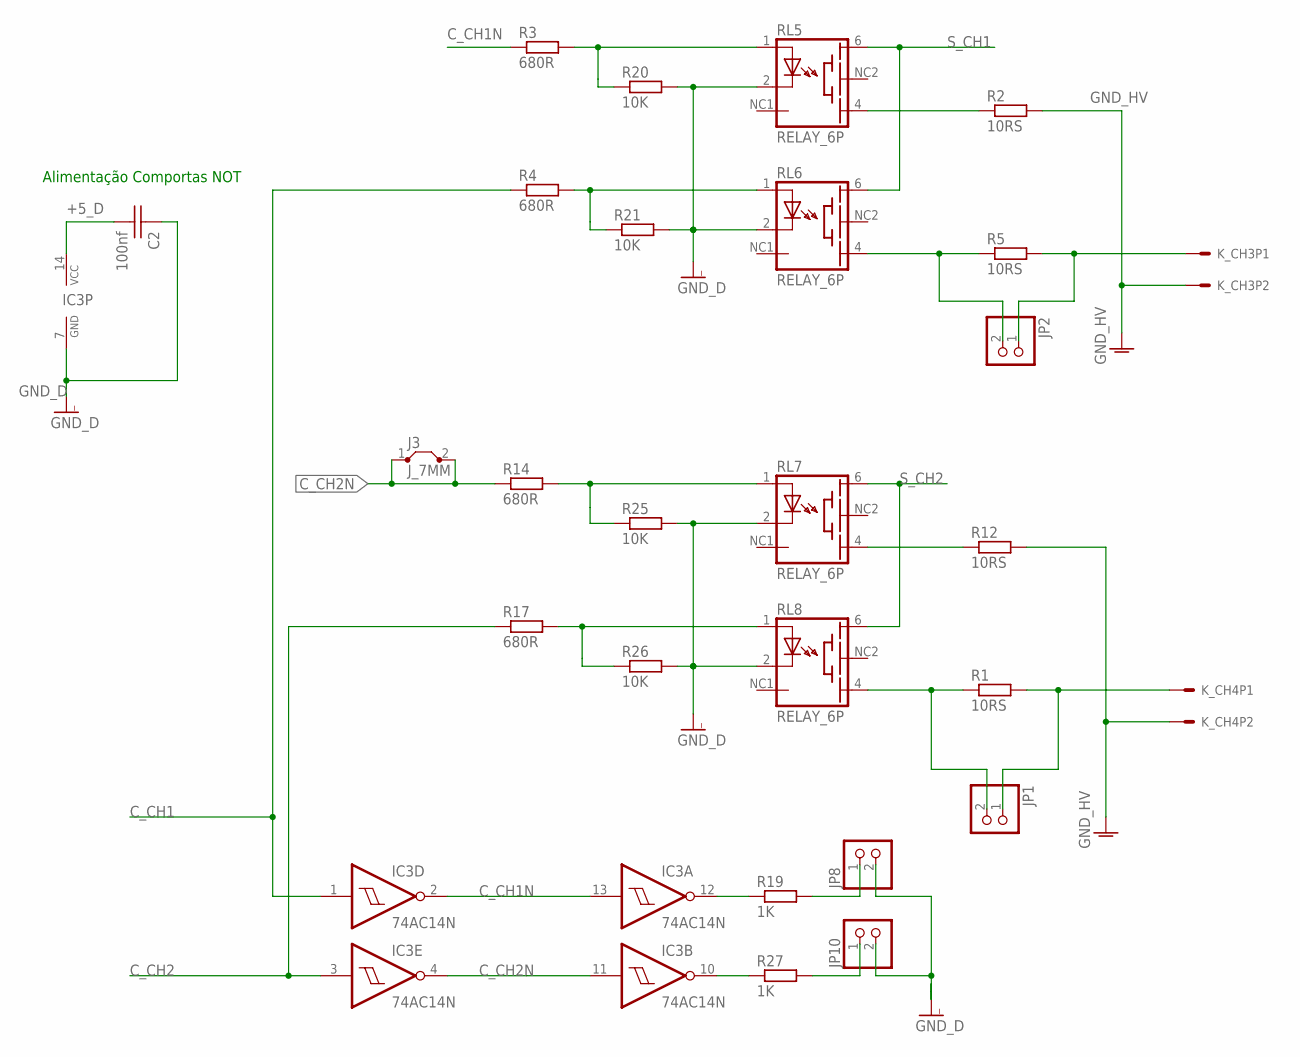
[picture p161: schematic Estimulema v2.sch, sheet 5]

Parts:
C2: 100nf; CAP_CER_SMD-0805
IC3: 74AC14N; DIL14
J3: J_7MM; 07
JP1, JP2, JP8, JP10: PINHD-1X2; 1X02
K_CH3, K_CH4: CONECTOR_5.08; CONECTOR_X2_5.08
R1, R5: 10RS; 0204/5
R2, R12: 10RS; 0617V
R3, R4, R14, R17: 680R; RESISTENCIA_0805
R19, R27: 1K; RESISTENCIA_0805
R20, R21, R25, R26: 10K; RESISTENCIA_0805
RL5, RL6, RL7, RL8: RELAY_6P; TS210

Connections:
+5_D: C2.2, IC3.14 (VCC); also elsewhere on the board
C_CH1: IC3.1 (I), R4.1; also elsewhere on the board
C_CH1N: IC3.2 (O), IC3.13 (I), R3.1
C_CH2: IC3.3 (I), R17.1; also elsewhere on the board
C_CH2N: IC3.4 (O), IC3.11 (I), J3.1, J3.2, R14.1
GND_D: C2.1, IC3.7 (GND), JP8.2, JP10.2, R20.2, R21.2, R25.2, R26.2, RL5.2 (C), RL6.2 (C), RL7.2 (C), RL8.2 (C); also elsewhere on the board
GND_HV: K_CH3.2, K_CH4.2, R2.2, R12.2; also elsewhere on the board
unnamed: R3.2, R20.1, RL5.1 (A)
unnamed: R4.2, R21.1, RL6.1 (A)
unnamed: R2.1, RL5.4 (EMI)
unnamed: JP2.2, R5.1, RL6.4 (EMI)
unnamed: R14.2, R25.1, RL7.1 (A)
unnamed: R17.2, R26.1, RL8.1 (A)
unnamed: R12.1, RL7.4 (EMI)
unnamed: JP2.1, K_CH3.1, R5.2
unnamed: JP1.1, K_CH4.1, R1.2
unnamed: JP1.2, R1.1, RL8.4 (EMI)
unnamed: JP8.1, R19.2
unnamed: IC3.12 (O), R19.1
unnamed: IC3.10 (O), R27.1
unnamed: JP10.1, R27.2
S_CH1: RL5.6 (BAS), RL6.6 (BAS); also elsewhere on the board
S_CH2: RL7.6 (BAS), RL8.6 (BAS); also elsewhere on the board

Notes on the sheet:
Alimentação Comportas NOT

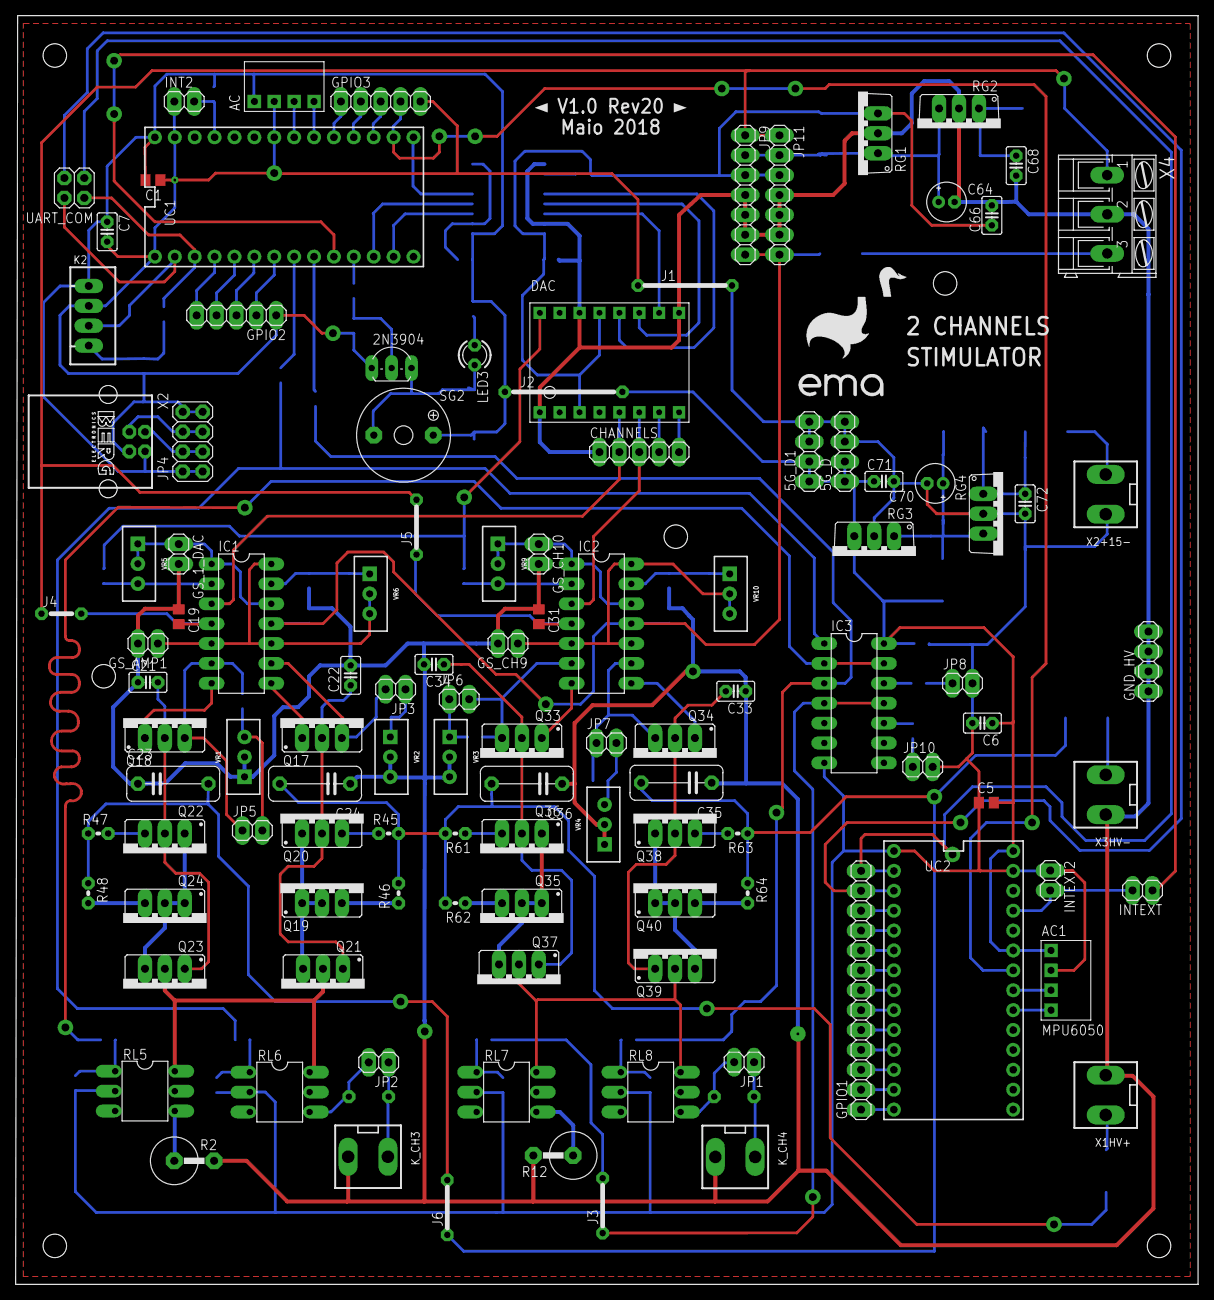
[picture p162: board Estimulema v2.brd from above]

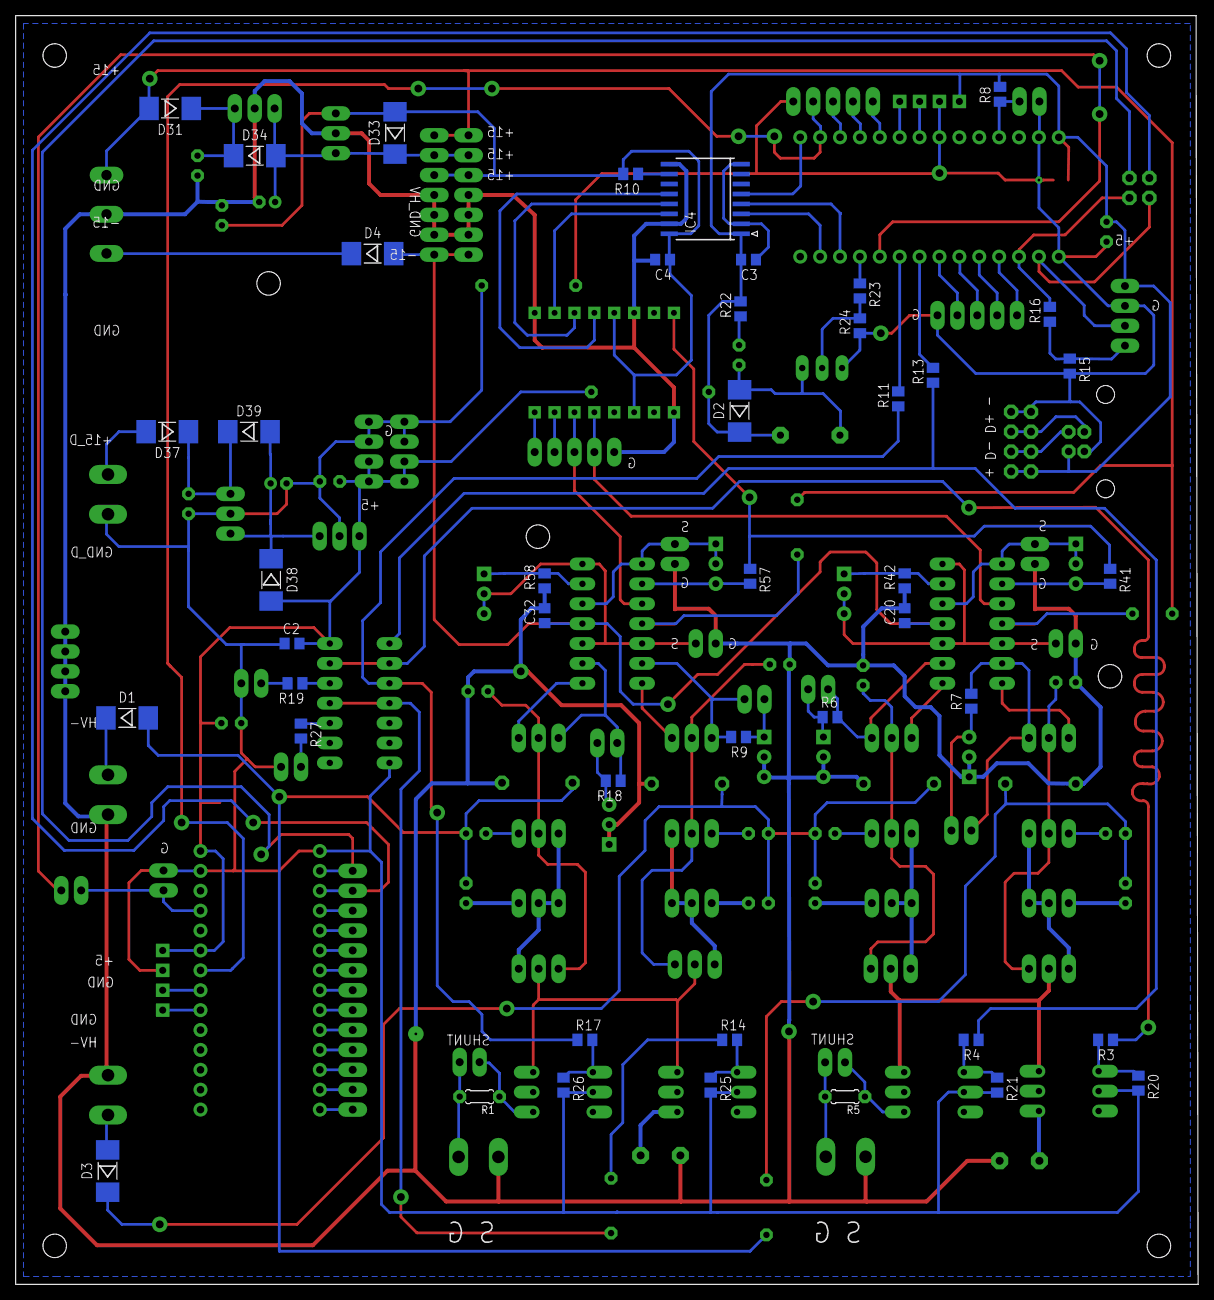
[picture p163: board Estimulema v2.brd from below]

Board: 2 copper layers, 151.0 x 162.0 mm, 158 parts (45 on the bottom side), 125 nets.
