lara-unb/Estimulema/estimulemaINO/Accel_MPU6050_V2_8-29-18/Accel_MPU6050_V2_8-29-18.ino

#include "I2Cdev.h"
#include "MPU6050.h"
#if I2CDEV_IMPLEMENTATION == I2CDEV_ARDUINO_WIRE
#include "Wire.h"
#endif

// #define Pin_Inter 23
const int Pin_Led_Control = 13;
const int Pin_signal_Control = 20;

const char fin = '>';                 // Character separator used for split data

MPU6050 accel;

int16_t ax = 0, ay = 0, az = 0;

bool capture = false, loops = true;

int pint = 0;

bool uno = true, dos = false; 

unsigned long time_count = 0;


void setup() {
  // join I2C bus (I2Cdev library doesn't do this automatically)
  #if I2CDEV_IMPLEMENTATION == I2CDEV_ARDUINO_WIRE
    Wire.begin();
  #elif I2CDEV_IMPLEMENTATION == I2CDEV_BUILTIN_FASTWIRE
    Fastwire::setup(400, true);
  #endif

  // Initialize parameters for Stim-Accel communication
  Serial.begin(2000000);
  Serial.setTimeout(1);
  
  Serial1.begin(2000000);
  Serial1.setTimeout(1);

  accel.initialize();
  
  //pinMode(Pin_Inter, INPUT);
  pinMode(Pin_signal_Control, INPUT_PULLUP);
  pinMode(Pin_Led_Control, OUTPUT);

  /*int16_t * ax = (int16_t) malloc(1 * sizeof(int16_t));
  int16_t *ay = (int16_t) malloc(1 * sizeof(int16_t));
  int16_t *az = (int16_t) malloc(1 * sizeof(int16_t));

  ax = 0;
  ay = 0;
  az = 0;*/
  
  digitalWrite(Pin_Led_Control,1);
}

void loop() {

  time_count = micros() + 5e5;

  led_blink_and_read();

  pint = 0;
  ax = 0;
  ay = 0;
  az = 0;

  if(capture){

    Serial.print(micros());
    Serial.print(";");
    pint = digitalRead(Pin_signal_Control);
    accel.getAcceleration(&ax, &ay, &az);
    Serial.print(ax);
    Serial.print(";");
    Serial.print(ay);
    Serial.print(";");
    Serial.print(az);
    Serial.print(";");
    Serial.println(pint);

    while(capture) {
      pint = digitalRead(Pin_signal_Control);
      //Serial.print(micros());
      Serial.print("0;");
      accel.getAcceleration(&ax, &ay, &az);
      Serial.print(ax);
      Serial.print(";");
      Serial.print(ay);
      Serial.print(";");
      Serial.print(az);
      Serial.print(";");
      Serial.println(pint);
      read_data();      
    } 

    Serial.print(micros());
    Serial.print(";");
    Serial.print(ax);
    Serial.print(";");
    Serial.print(ay);
    Serial.print(";");
    Serial.print(az);
    Serial.print(";");
    Serial.println(pint);
    Serial.println(">"); // End captura

  }// end fin captura
}

void read_data(){
	if(Serial1.available() != 0){
  		String data_in = Serial1.readStringUntil(fin);
    	int sel1 = data_in.toInt();
    	data_in = Serial1.readStringUntil(fin);
    	int sel2 = data_in.toInt();
    	Serial1.readString();

    	switch (sel1) {
      		case 1:
      			if(sel2 == 1){ 		// Sel2 is iqual to activate capture function
      				digitalWrite(Pin_Led_Control, 0);
      	 			capture = true;
      	 			loops = false;
      			}else{
      				capture = false;
      				loops = true;
      			}
        		break;
      		/*case 2: // en este caso se quita porque ocurre un atraso en la señal quitado junto con el bip de min
        		Serial.print("T>");
        		Serial.print(sel2);  // Sel2 is iqual to minutes
        		Serial.println(">");
        		break;*/
      		case 3:
      			// No hay mas captura de dados
      			capture = false;
      			loops = true;

      			//Imprime el ultimo valor
      		Serial.print(micros());
			    Serial.print(";");
			    pint = digitalRead(Pin_signal_Control);
			    accel.getAcceleration(&ax, &ay, &az);
			    Serial.print(ax);
			    Serial.print(";");
			    Serial.print(ay);
			    Serial.print(";");
			    Serial.print(az);
			    Serial.print(";");
			    Serial.println(pint);
			    
			    // Finaliza todo
        		Serial.println("f");
        		break;
    	}
  	}

    if(Serial.available() != 0){
      String car_ini = Serial.readString();
      if(car_ini == "f"){
        capture = false;
        loops = true;
      }else if(car_ini == "s"){
        digitalWrite(Pin_Led_Control, 0);
        capture = true;
        loops = false;
      }
    }
}

// funcion para hacer blink y leer datos si los hay
void led_blink_and_read(){
	while(loops && capture == false){
		if(micros() >= time_count && uno){
		    uno = false;
		    dos = true;
		    time_count = micros() + 5e5;
		    digitalWrite(Pin_Led_Control, 0);
		}

    	if(micros() >= time_count && dos){
      		uno = true;
      		dos = false;
      		time_count = micros() + 5e5;
      		digitalWrite(Pin_Led_Control, 1);
    	}

    	read_data();
  	}
}
