lara-unb/Estimulema/(commit log)

2018-04-23 testando nuevas funcionalidades
    implementando comunicaciony limites de therapy, Ton y TOff
2018-05-04 version antigua
    descartado esta version ahora est[a la version 2
2018-08-15 Colocando tudo de novo
2018-08-15 Adicionando los INO del proyecto
    los ino usados actualmente son: EstimulemaV3_7-10-18.ino y MPU6050_raw_Mod.ino
    [new_while.pdsprj]
2018-08-15 Adicionando el proyecto de la PCB
    adiciono el proyecto final hasta la fecha
    [AD629 shield.brd, AD629 shield.sch, Estimulema v2.brd, Estimulema v2.sch, filtro.pdsprj]
2018-08-17 Add xls
    for test performance of estimulema
    [Libro testes electro.xlsx]
2018-08-20 Actualizacion
    Correcion de bugs, en la interface del py, problema boton de emergencia
    [Estimulema V0.3 Rv1.py, EstimulemaV3_7-10-18.ino, PLot_live.py]
2018-08-27 Teste desempenho Dualpex
    los archivos csv estan en el archivo comprimido
2018-08-30 Adicion de nuevas funcionalidades
    Furon adicionados:
    *- comunicacion serial entre stim y accel Serial1
    *- NUevo protocolo de comunicacion entre Teensys
    *- conteo de minutos en la interface
    *- modificacion de la GUI para colocar inicio y fin del teste de reobase
    *- modificaciones hechas tanto en los ino como en la py
    *- ahora el archivo de accel se lama Accel_MPU
    *- adicionado nuevo parametro al protocolo de comunicacion entre stim y estimulema py rh_ini y rh_fin
    [Aparelho de mediçao de forza (Router's conflicted copy 2018-08-17).SLDASM, Aparelho de mediçao de forza.SLDASM, Assem1.SLDASM, CAIXA CARGAS COMPLETA.SLDASM, CAIXA SISTEMA CARGAS INF.SLDPRT, CAIXA SISTEMA CARGAS SUP.SLDPRT, Celula de carga.SLDPRT, ESTOPIN.SLDPRT]
2018-09-06 Nueva version del estimulema ino
    Version v4 con rampa algunos errores por arreglar
    [Aparelho de mediçao de forza.SLDASM, Estimulema v2.brd, Estimulema v2.sch, agarre sup trasero - tuvo 1 pol.SLDPRT, agarre sup trasero - tuvo 2 pol .SLDPRT, isolador pasante.SLDPRT]
2019-04-16 final version working, teste OK!!
    Updates:
    1. Estimulema firmware:
    beep feature was remove of stim function
    Cronaxie: this function was remove of firmware and instead it was placed the calibration function for activate the accelerate acquisition.
    Other small fixes.
    2. Accel firmware: updates in serial communications and add functions for data flow control
    3. Add new version of firmware loadcell
    4. add libraries used in inos firmware
    [Estimulema v2.brd, Estimulema v2.sch]
2019-04-16 Two version of control of Stimulema
    1. Estimulema GUI
    2. Test GUI (excitability test and stimulation control)
    [Pasta1(Recuperado Automaticamente).xlsx, acel_data Sun 07 16h30.xlsx, teste .xlsx]
2019-04-27 Atualização pcb e tese
2019-06-04 Modificaçoes GUI e Testes de Genesys
    Teste de desempenho Genesys e modificaciones del la intyerface de GUI
    [Libro testes electro.xlsx, T0000.CSV, T0002.CSV, T0003.CSV, T0004.CSV, T0005.CSV, t0001.CSV]
2019-06-04 Version Funcionando del Stimulema
    Diag and Train OK
    [Treinamento0 Fri 05 10h17.csv, Treinamento0 Fri 05 10h21.csv, Treinamento0 Mon 15 14h48.csv]
2019-08-27 testes de desempenho
    libro com testes de desempenho
    [Libro testes electro HTM.xlsx, T0000.CSV, T0001.CSV, T0002.CSV, T0003.CSV, T0004.CSV, T0005.CSV, T0006.CSV]
